edsammy/wipow/README.md

Wireless Power Monitoring Device
=====
University of Rochester   
Electrical Engineering Depatment   

Mentor: Professor Thomas B Jones   
Created by: Jack Yung & Ka Fung    
Maintained by: Will Kung & Eddie Samuels

-----------------------------------------------------------------------------------
Wireless Power Monitoring device that runs on the Arduino and uses the MAXQ3183. Capable of reading voltage, current, power, and voltage and current harmonics (1st-5th).
