edsammy/wipow/Presentations and Reports/7-10.pptx

| A | B | C | N | Total
RMS Voltage | ✓ | ✓ | ✓ | - | -
RMS Current | ✓ | ✓ | ✓ | ✓ | -
Power (Apparent/Real/Reactive) | ✓ | ✓ | ✓ | - | ✓
Line Frequency | ✓ | ✓ | ✓ | - | ✓
Power Factor (Real over Reactive) | ✓ | ✓ | ✓ | - | -
Voltage Phasor Angles | ✓ | ✓ | ✓ | - | -
Current Harmonics | Filter problem in the chip?
Voltage Harmonics
Current THD
Fundamental Powers

## Slide 2

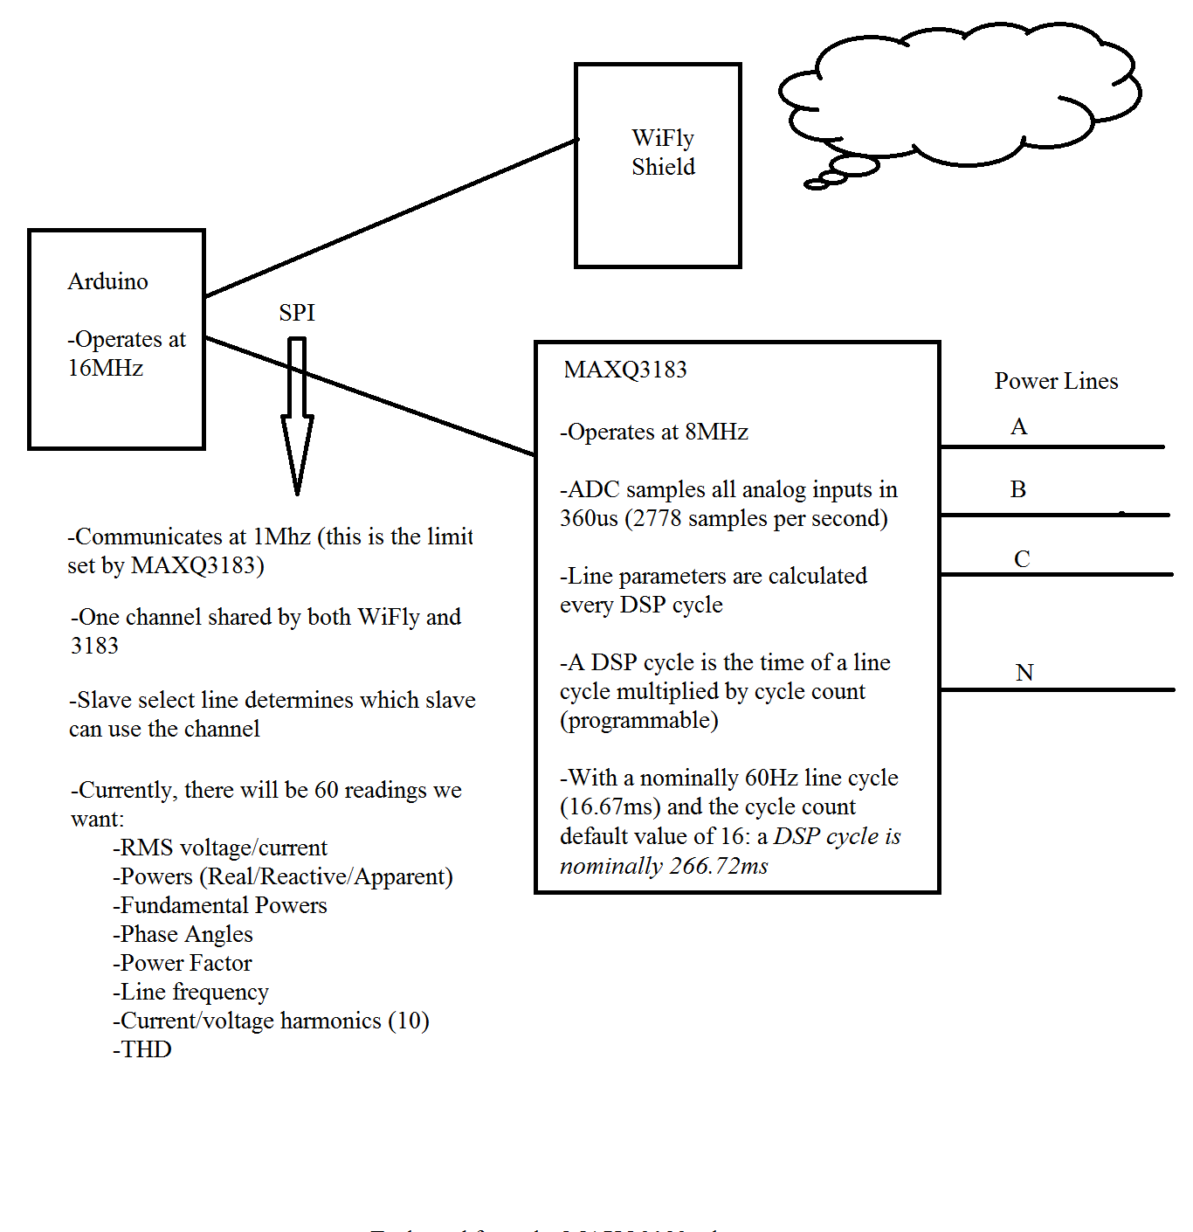
[picture p3: figure]
