edsammy/wipow/Presentations and Reports/9-11-12 Presentation.pptx

## Wireless Building Power Monitor

(Hardware Design and Packaging)
2012 Spring to Summer
Pak Lam (Jack) Yung

## Wireless Power Monitor System

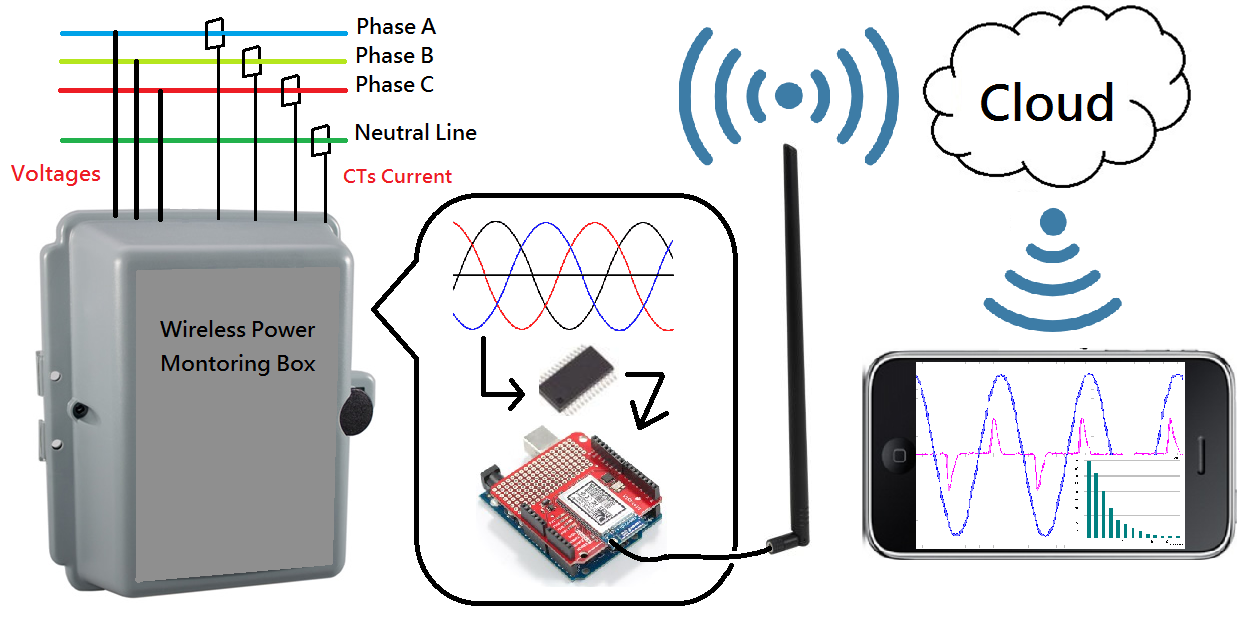
[picture p4: figure]

## Inside the Box

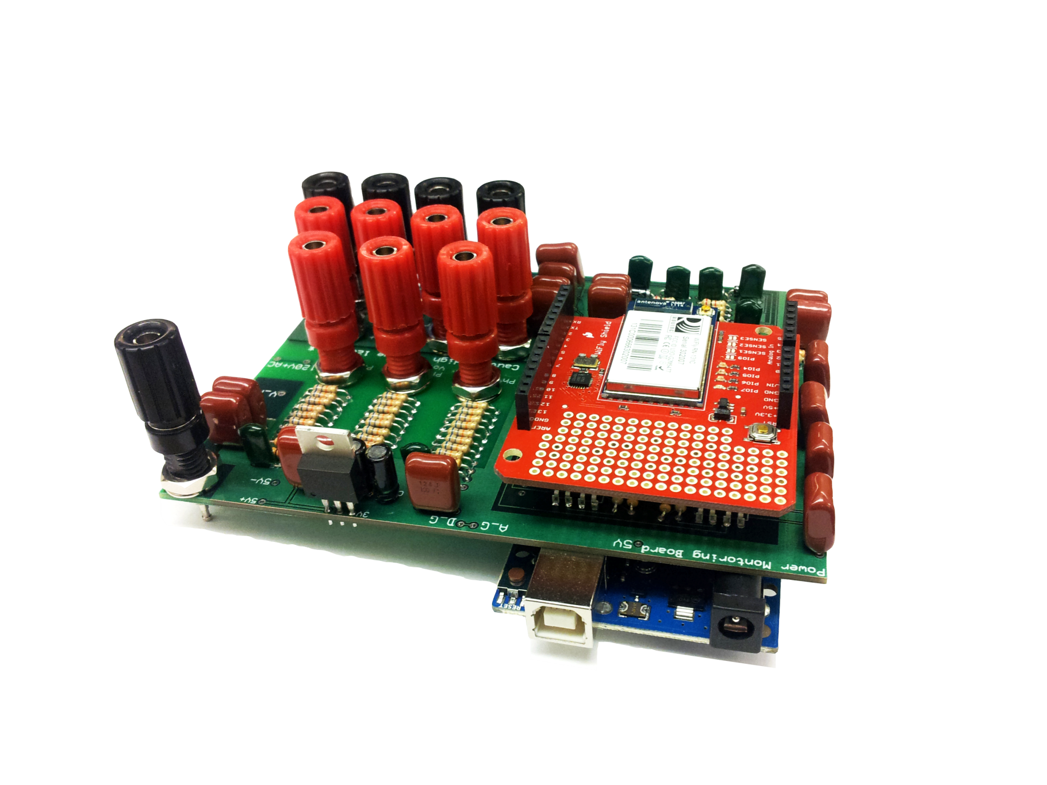
[picture p5: figure]

## Slide 4

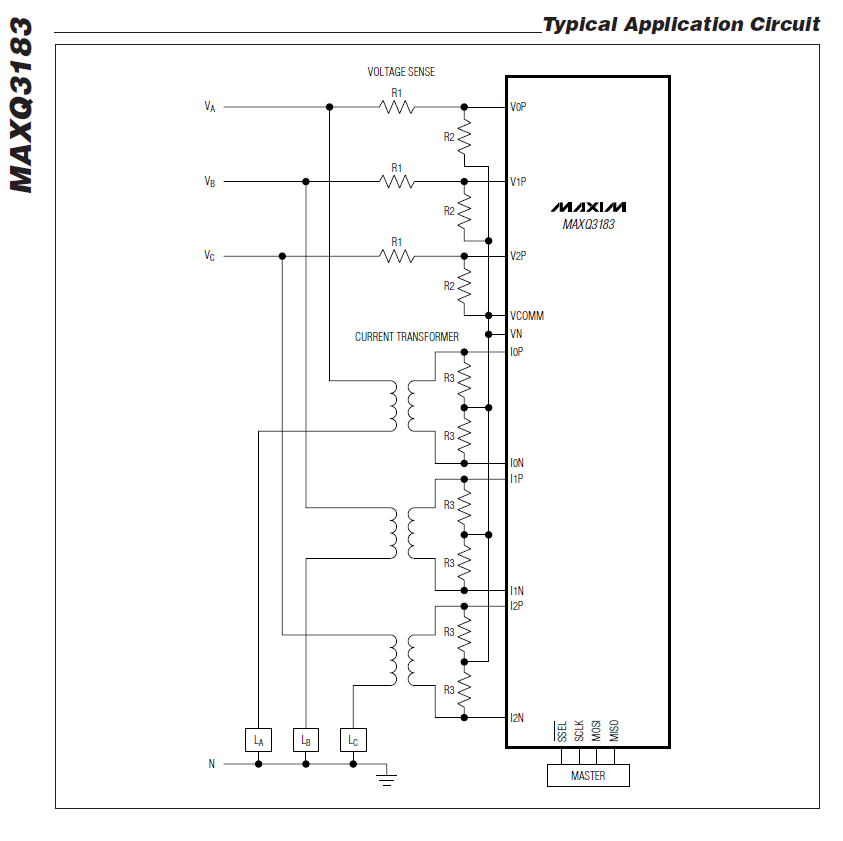
[picture p6: figure]

## Slide 5

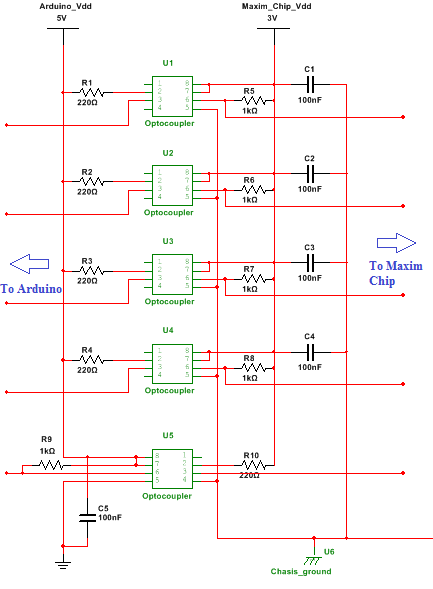
[picture p7: figure]

## Slide 6

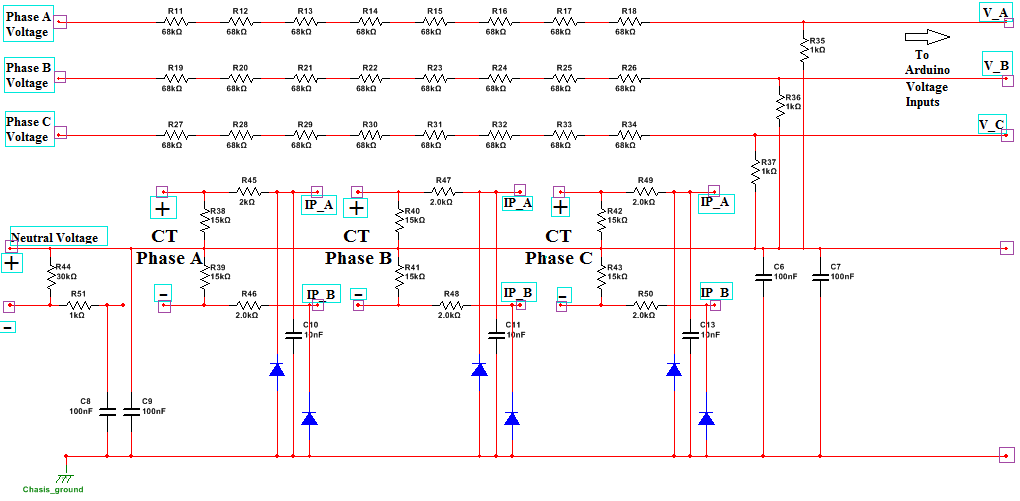
[picture p8: figure]

## Slide 7

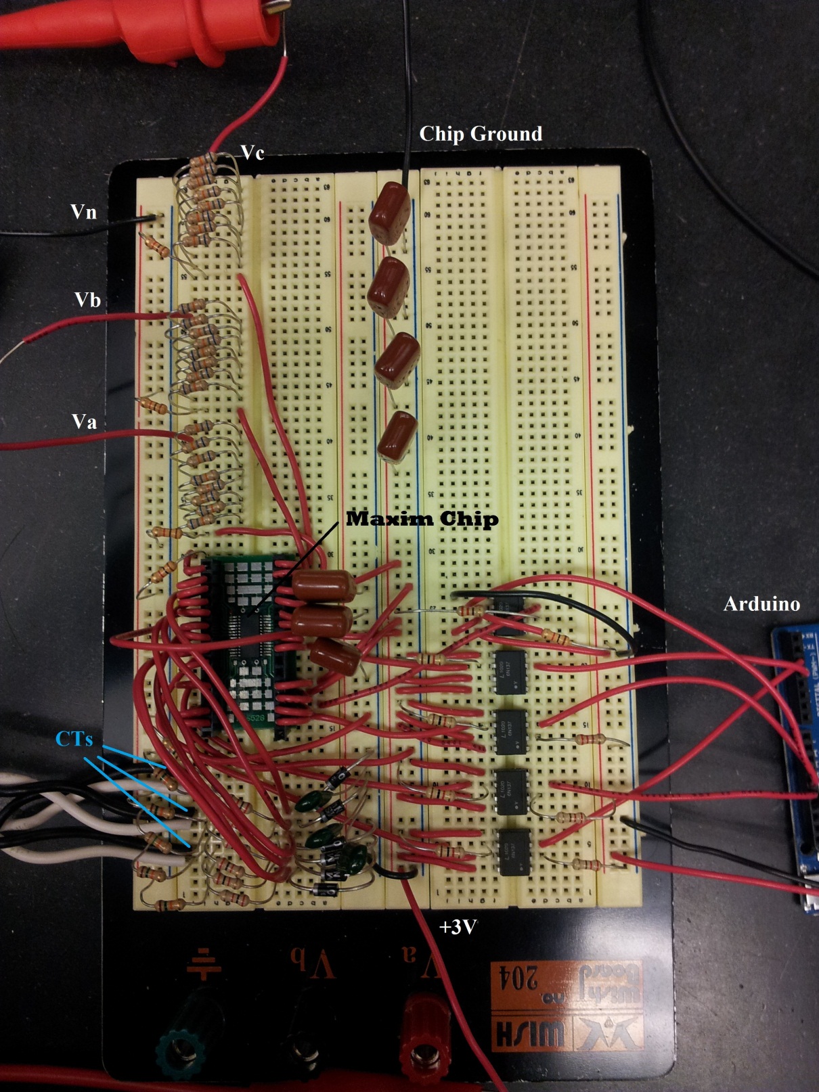
[picture p9: figure]

## Slide 8

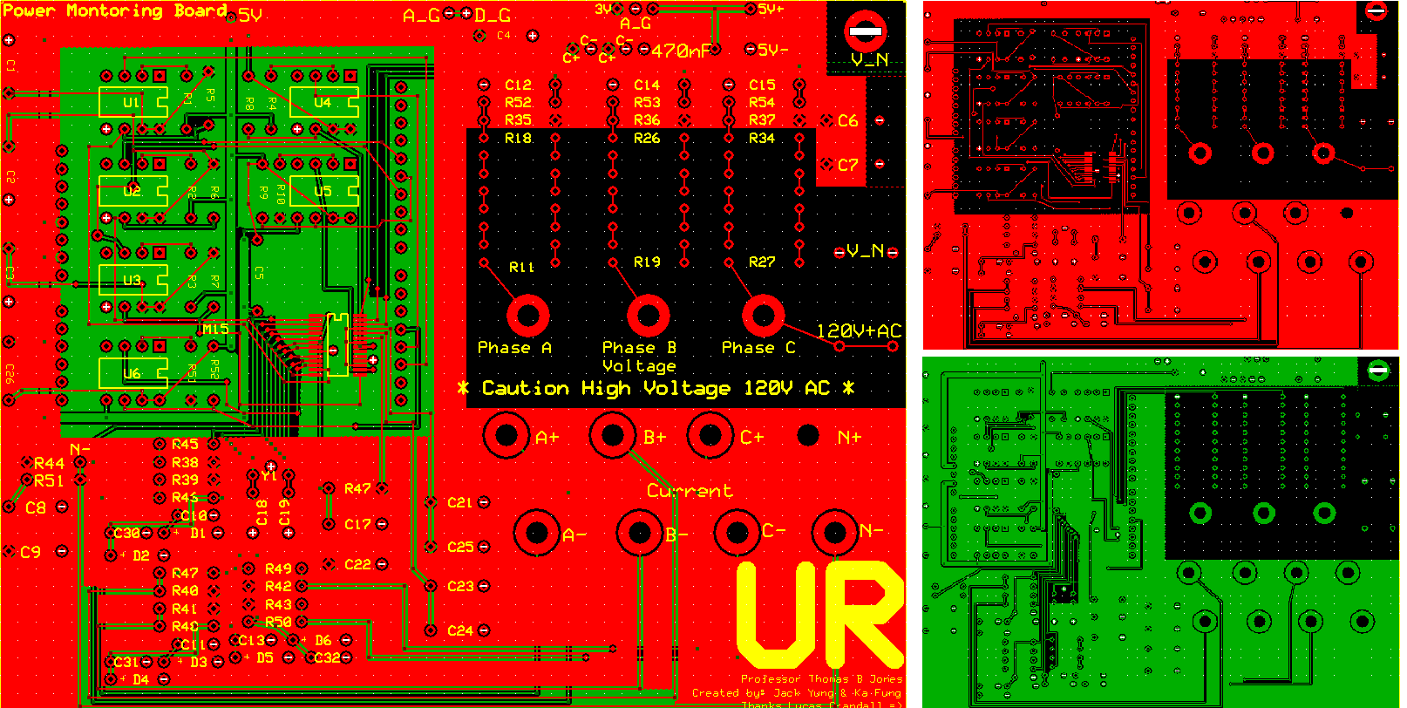
[picture p10: figure]
