edsammy/wipow/Presentations and Reports/Arduino intro plus AFEs.pptx

## Introduction to Arduino

By Gabriel Unger

## What is Arduino?

- Open-source physical computing platform
- Atmel AVR ATmega microcontrollers
- Free, simple IDE with built-in functions
- Arduino Programming Language (C/C++)

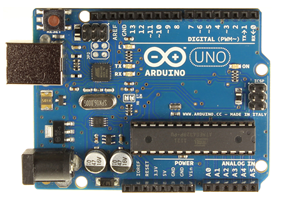
[picture p11: figure]

## What is Arduino Used For?

- Standalone systems
  - Robots
  - Pervasive computing (smart home)
- Interface between physical world and computing world
  - Our project
  - Transducers feed Arduino
  - Arduino feeds a system

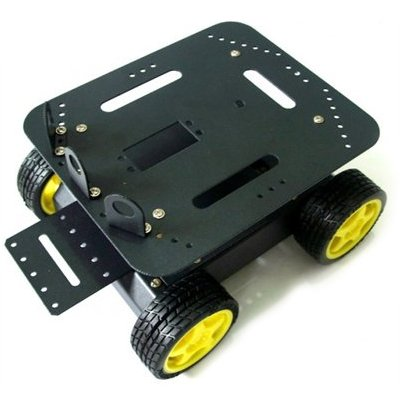
[picture p12: figure]

## Why Arduino?

- Easy
  - Pre-made official boards
  - C/C++
- Open
  - Third-party boards
  - “Shields” extend functionality
- Popular
  - Community-developed libraries
  - Online support community

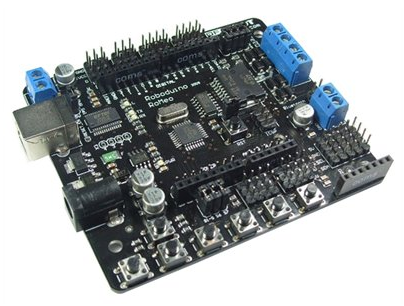
[picture p13: figure]
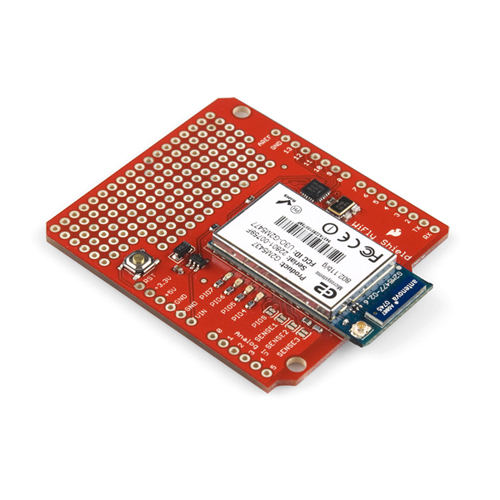
[picture p14: figure]

## What Can Arduino Do?

- Processing and Storage
  - Capable processor (robot brain)
  - SRAM, EEPROM, SD
- Connectivity
  - Basic digital, analog I/O
  - Serial
  - Bluetooth
  - WiFi
  - Zigbee
  - NFC/RFID
  - Ethernet

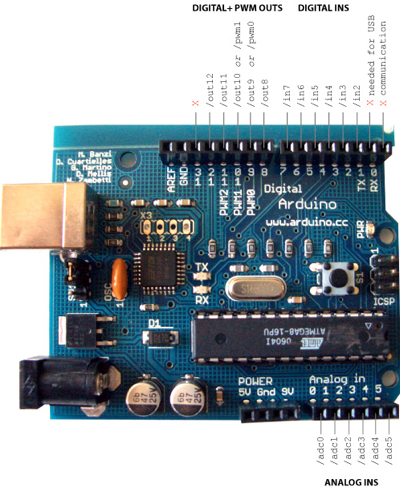
[picture p15: figure]

## Programming an Arduino Board

- Arduino IDE
  - Version 1.0
  - Free
  - C/C++
  - “Sketches”
    - One or more programs
    - .ino extension
    - setup() and loop()
- Any other IDE
  - Must support ATmega
  - Few advantages

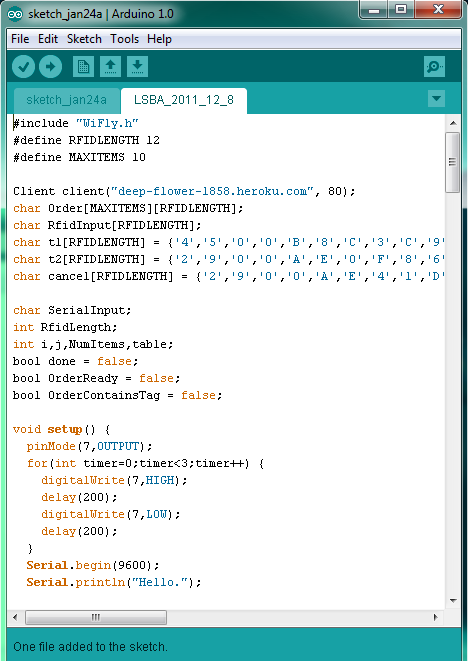
[picture p16: figure]

## Arduino Uno

- Latest official Arduino board
- ATmega328
  - 8-bit
  - 14 digital I/O (6 PWM)
  - 6 analog inputs
  - 16 MHz
  - 5V
  - 32 KB of program memory
  - 2 KB of SRAM (variables)
  - 1 KB EEPROM
  - Serial port
  - SPI port
  - 2 external interrupts
  - AREF

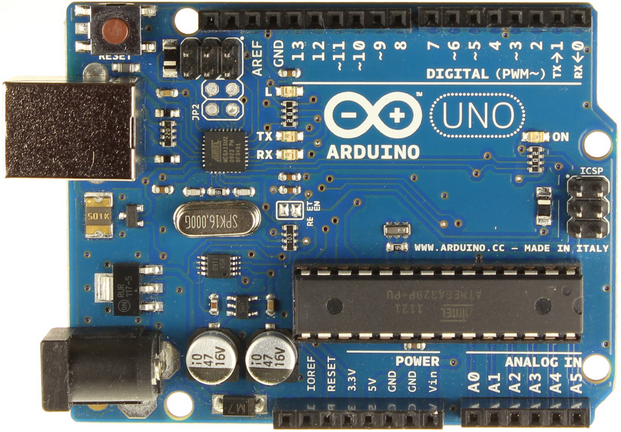
[picture p17: figure]

## How Arduino Fits Our Project

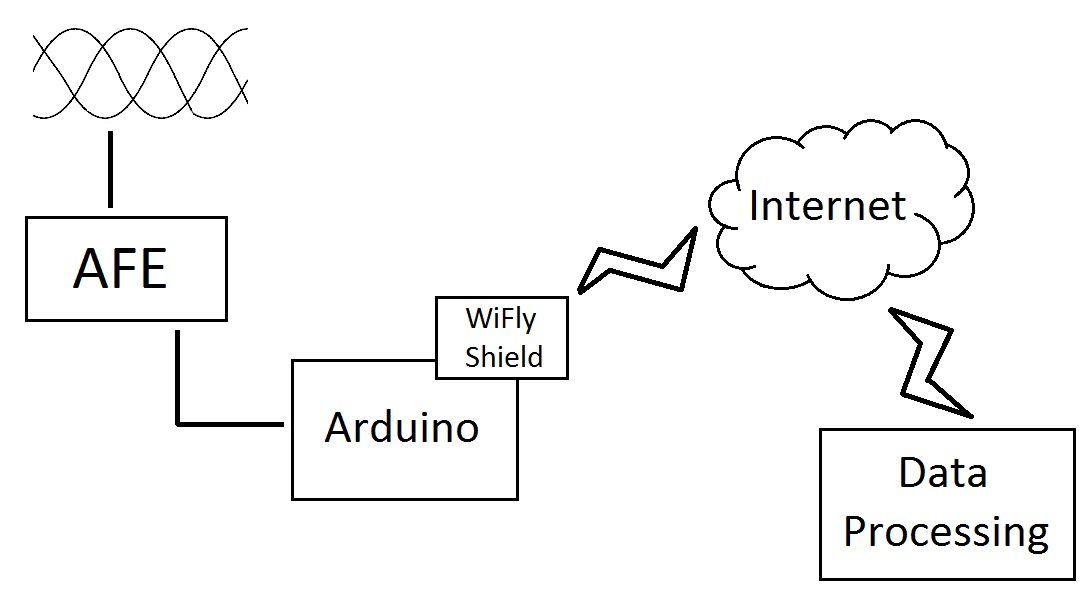
[picture p18: figure]

## Analog Front End (AFE)

- Grabs raw sensor outputs
  - Voltages
  - Currents
- Provides data to next level of processing
- Some provide advanced features
  - Fundamental frequency
  - Harmonic power
  - Power factor

## Maxim AFE Devices

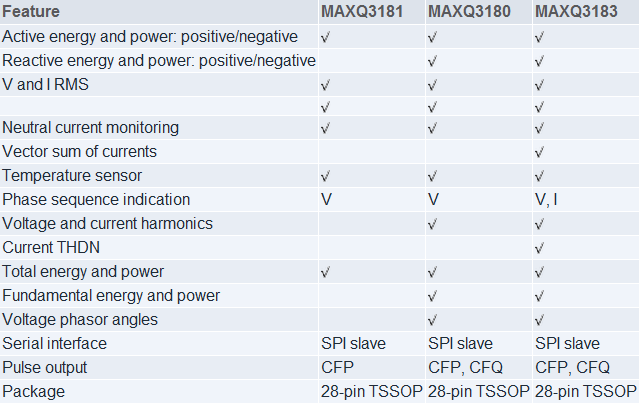
[picture p19: figure]

## MAXQ3183 Overview

- 3-Phase voltage, current
- ~$20 direct from Maxim
- TSSOP (tiny)
- SPI
- 3.3V
- 35 mW typical
- 7.6 MHz internal clock

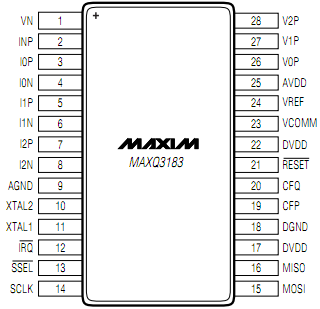
[picture p20: figure]

## MAXQ3183 Internals

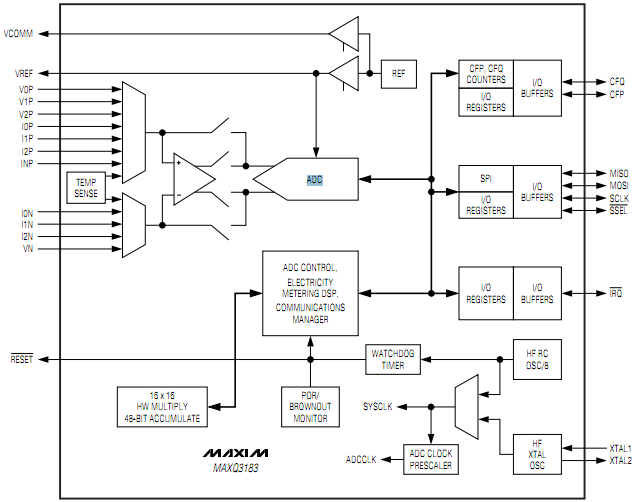
[picture p21: figure]
