edsammy/wipow/Presentations and Reports/Power Monitor - Hardware.pptx

## Power Monitor - Hardware

Pak Lam (Jack) Yung

## Power Monitoring System


## Hardware Design

- PCB Design (2x)
- Packaging
- Testing
- Installation

## One Year Ago

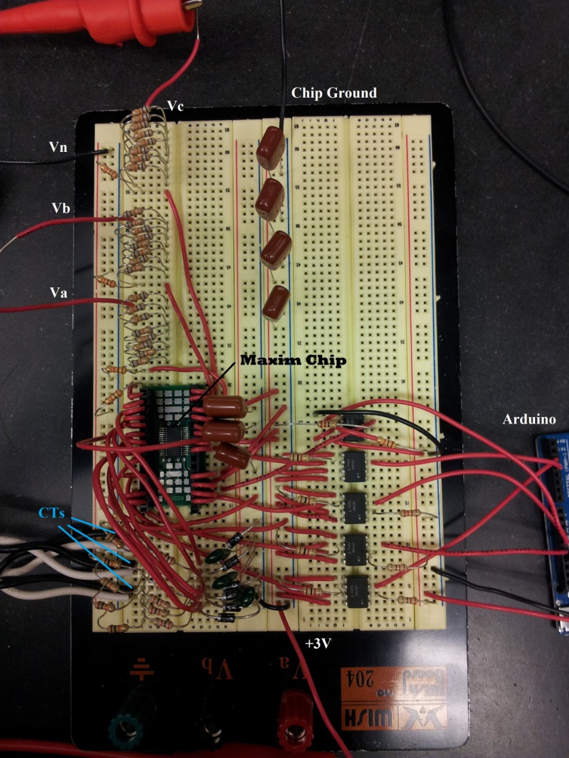
[picture p28: figure]

## Summer 2012

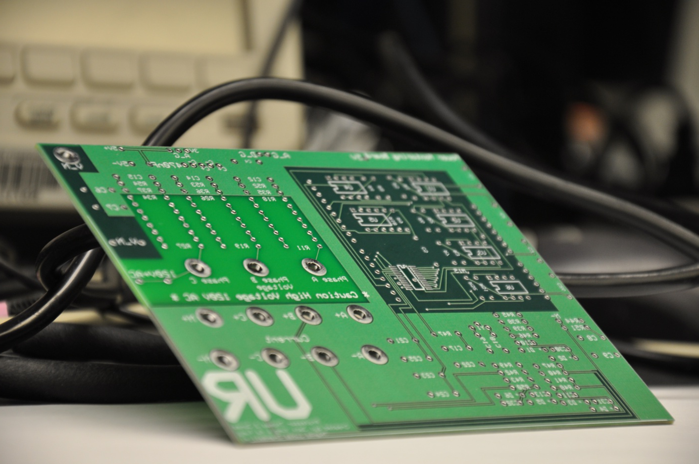
[picture p29: figure]

## Spring 2013

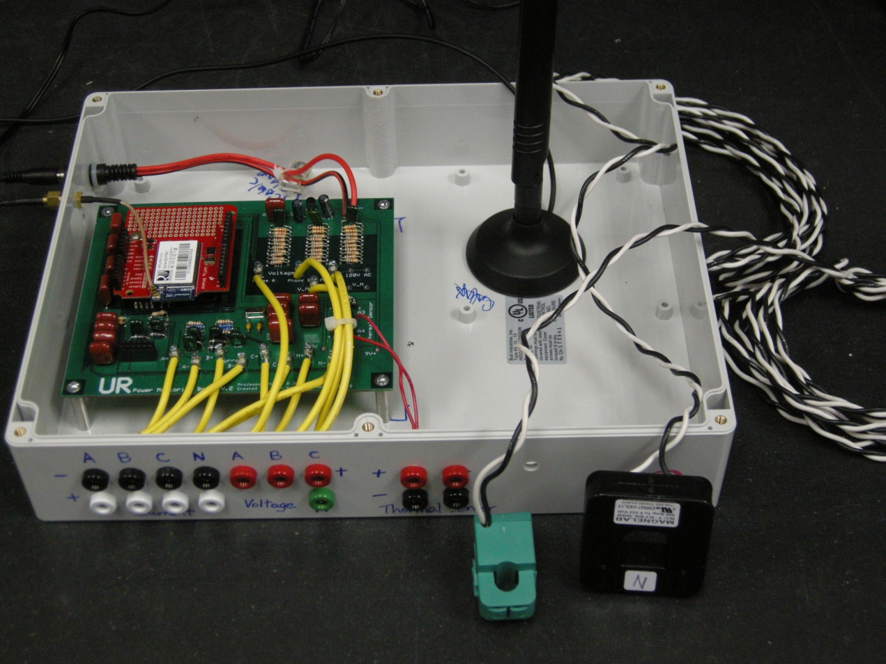
[picture p30: figure]

## First Circuit

- Noise
- Not safe
- Unstable
- Cheap

## First PCB

- Low Noise
- Safe
- 4 layer
- $219.9 – 4 piece
- $55 per piece
- Order from express PCB (Free Software)
- http://www.expresspcb.com/

## 4 layer PCB


## 4 Layer

- Top: N+
- 2nd: Digital Ground
- 3rd: Analog Ground
- Bottom: ~3V

## One Mistake for the first PCB

- R51 Right Hole
- should Not connect
- to top layer (N+)

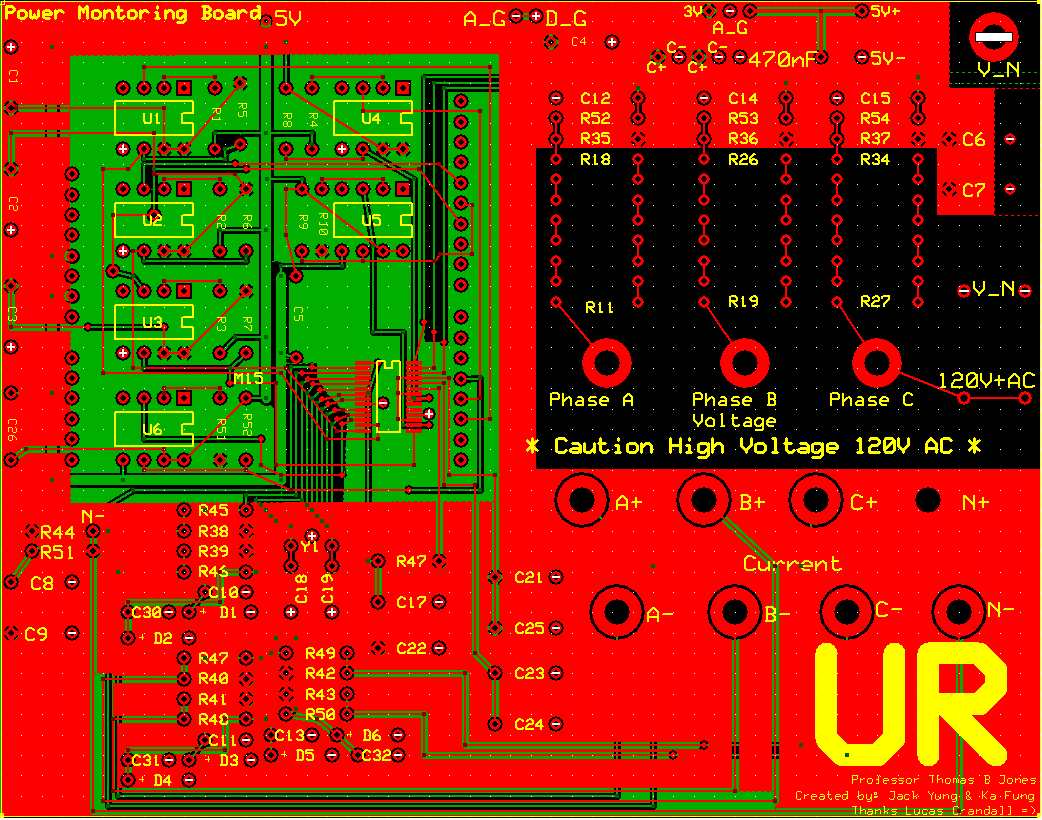
[picture p31: figure]
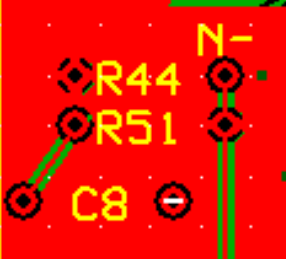
[picture p32: figure]

## Circuit


## Circuit


## Circuit

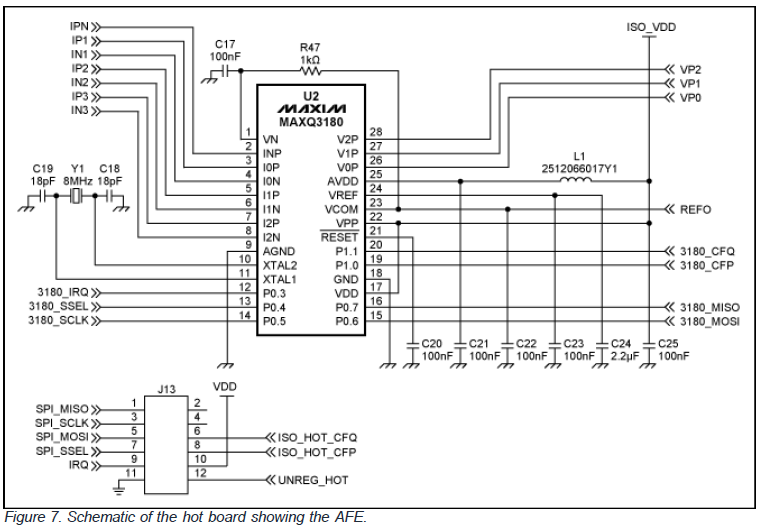
[picture p33: figure]

## Circuit


## Component

- Arduino Uno Board
- Wifly Shield
- CT
- Resistors, Capacitor
- Optopcoupler
- Maxim Chip
- Stackable Header
- Crystal Oscillator
- Voltage Regulator 5v to 3v
- Transformer AC to DC

## Where to Buy Them ?!

- http://www.sparkfun.com/products/10007
- https://shop.maximintegrated.com/storefront/priceavailable.do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
- http://www.digikey.com/product-detail/en/6N137/160-1791-ND/1969175
- http://www.digikey.com/product-detail/en/EPS090066-P5P/T980-P5P-ND/1016856
- http://www.digikey.com/product-detail/en/LP2950-33LPRE3/296-31455-1-ND/3505910
- http://www.newegg.com/Product/Product.aspx?Item=N82E16833998117
- https://www.sparkfun.com/products/9954

## PCB 2

- Same components
- BUT used Arduino Mage and added Thermal Sensor
- Bigger size
- Still 4 layer, circuit design is about the same.
- 6 piece for $430.99
- Each board is 72
- Express PCB

## Circuit Power

- 120 AC to 9v and 5v DC
- 9v Goes to Anduino, 5v goes to regulator and change to 3v.
- 3V power the chip and Optopcoupler

## Circuit Power

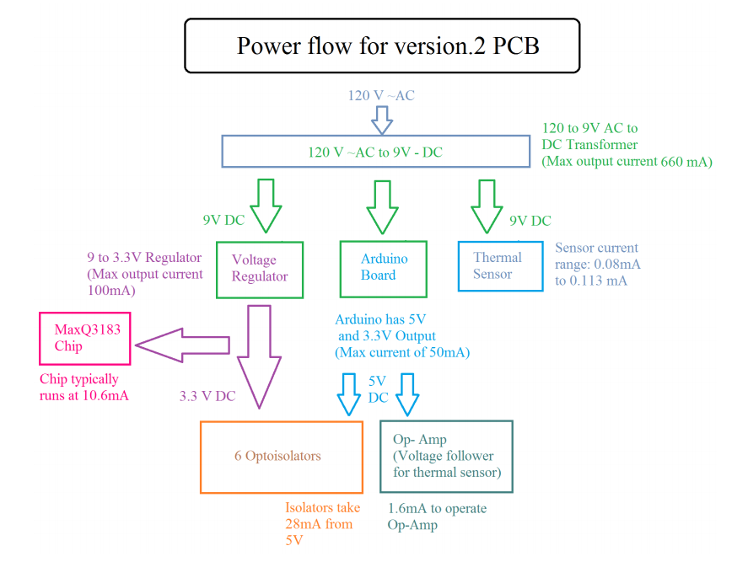
[picture p34: figure]

## Packaging

- Size measurement, purchase, installation

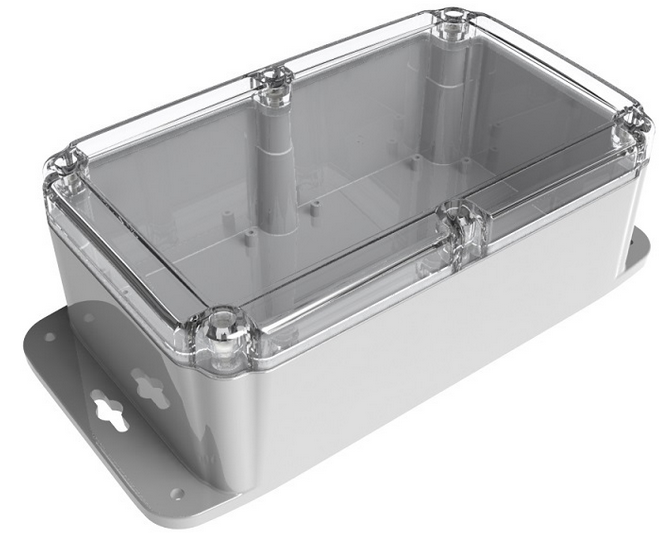
[picture p35: figure]

## Box 1 – Hopeman Building

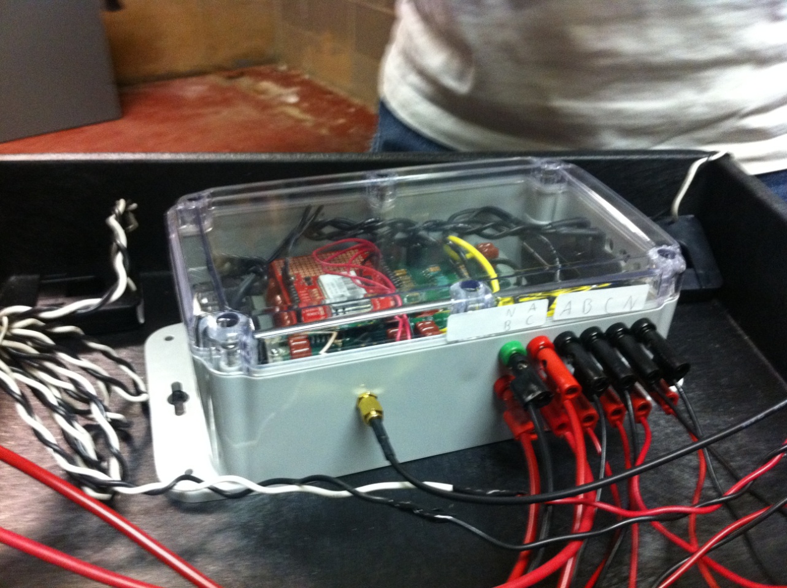
[picture p36: figure]

## Box 2

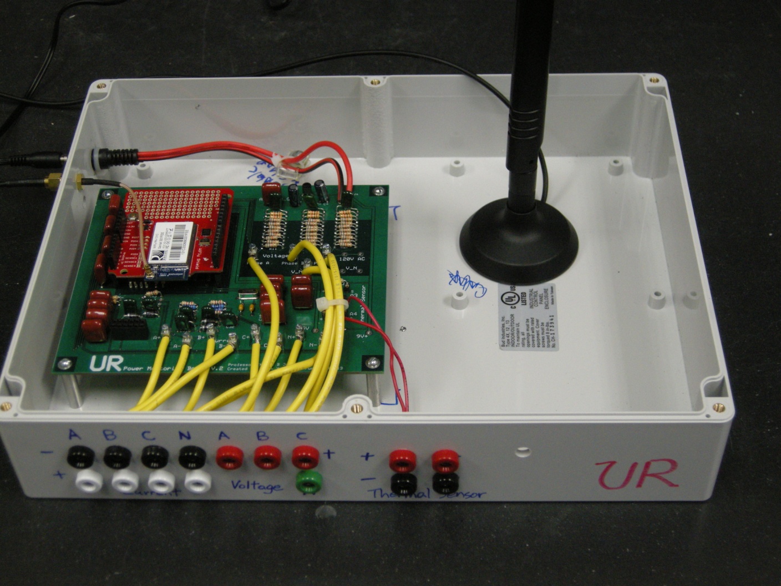
[picture p37: figure]

## Testing

- After building and soldering the board, run the sample code, get same reading. Let it run in the lab for few days and make sure it is safe to use (High voltage !!!)

## Installation

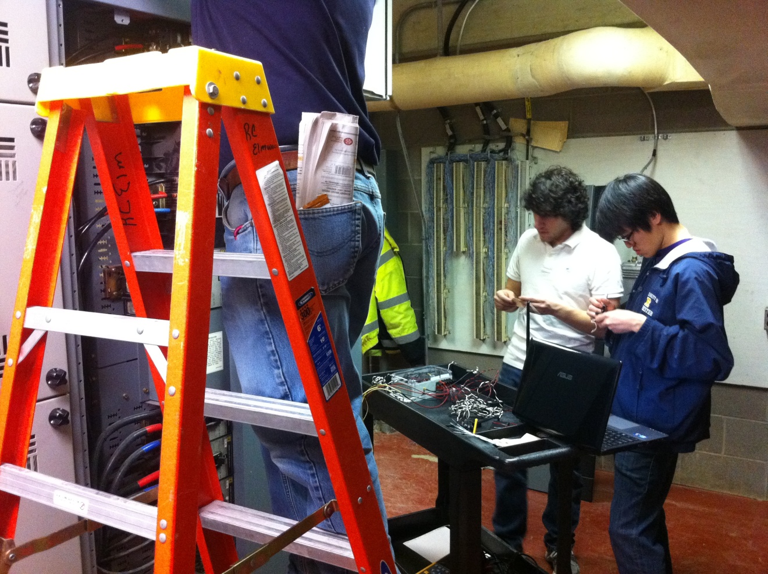
[picture p38: figure]

## Installation

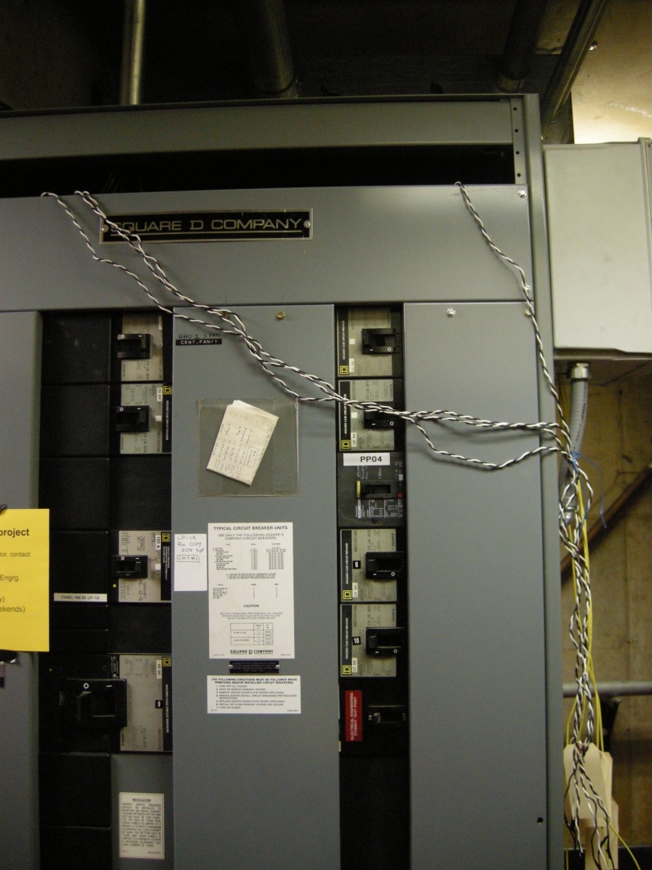
[picture p39: figure]

## Installation

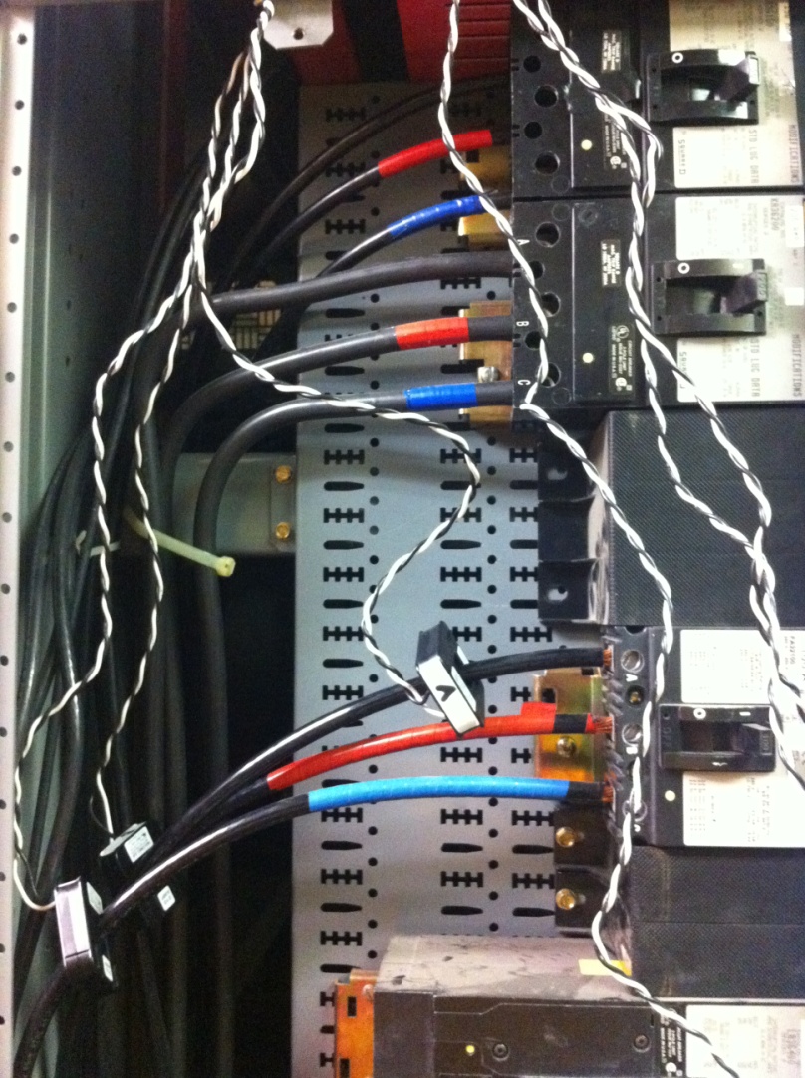
[picture p40: figure]

## Inventory

- Arduino Uno Board X3
- Arduino Mage x1
- PCB V1 x2
- PCB v2 x5 (un soldered)
- Wifly Shield X2
- CT x 9
- Resistors, Capacitor (Workshop)
- Optopcoupler x24
- Maxim Chip x5
- Stackable Header x6 sets
- Crystal Oscillator x4
- Voltage Regulator x5
- Transformer AC to 9 DC x3
- Box x2 (1 big and 1 small)
- Antenna x2
- Laptop x1
