edsammy/wipow/Presentations and Reports/Progress Report_PCB and Packing.pptx

## Process Report – PCB and Packing

Jack Yung
11-27-2012

## PCB Update:

- Adding internal connections to match the extra pins for Arduino Mega
- Expanding the circuit board:
- Make space for installation.
- Make space for thermal sensor.
- Adding voltage regulator to replace voltage transformer.
- $220 4-boards

## Voltage Regulator I

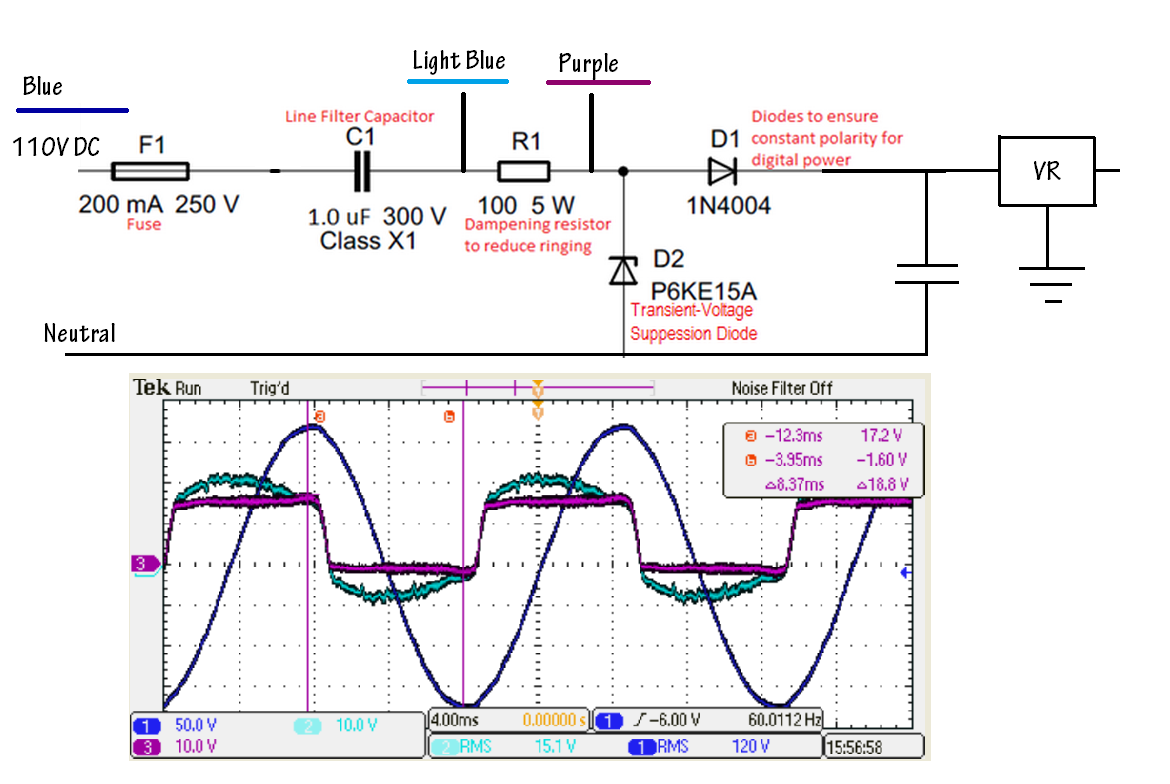
[picture p45: figure]

## Voltage Regulator II

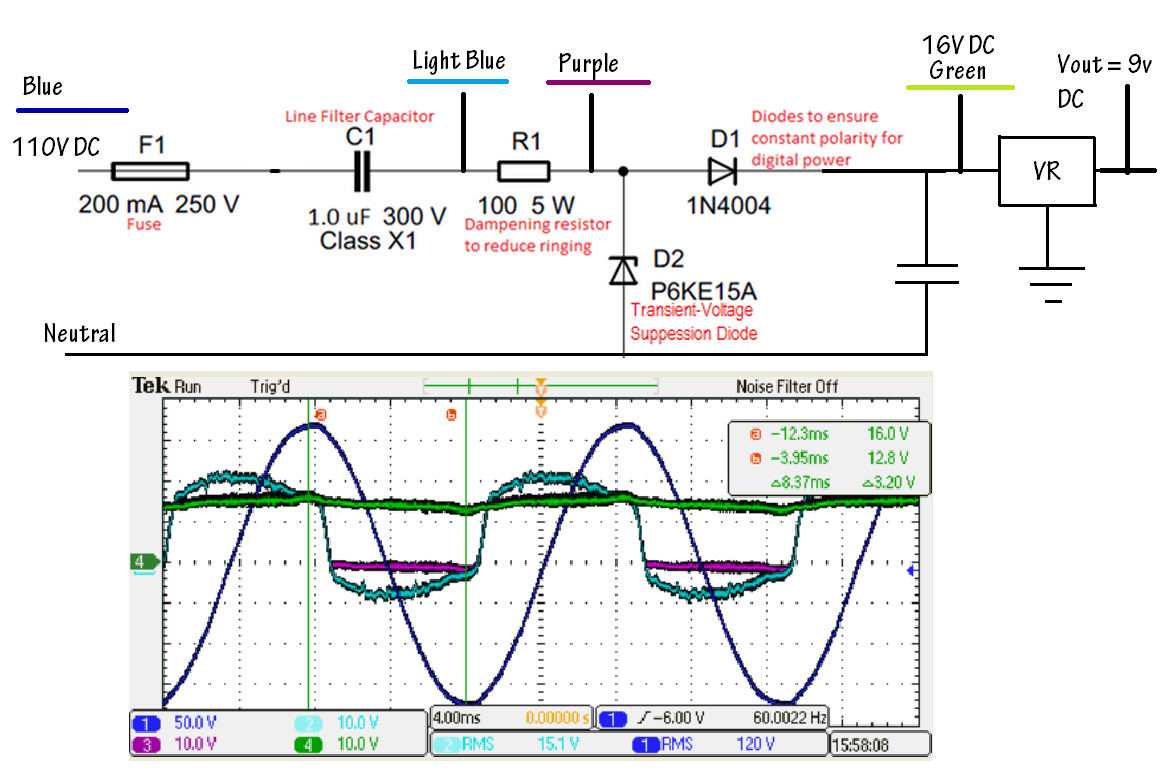
[picture p46: figure]

## Voltage Regulator

- Safety Testing (Connection with resistive load)
- ~20 hours total

## Packing Update

- Paul: No more packing box in the lab
- Buy new packing box when new PCB design finished.
- Plastic Vs. Metal

## Sample

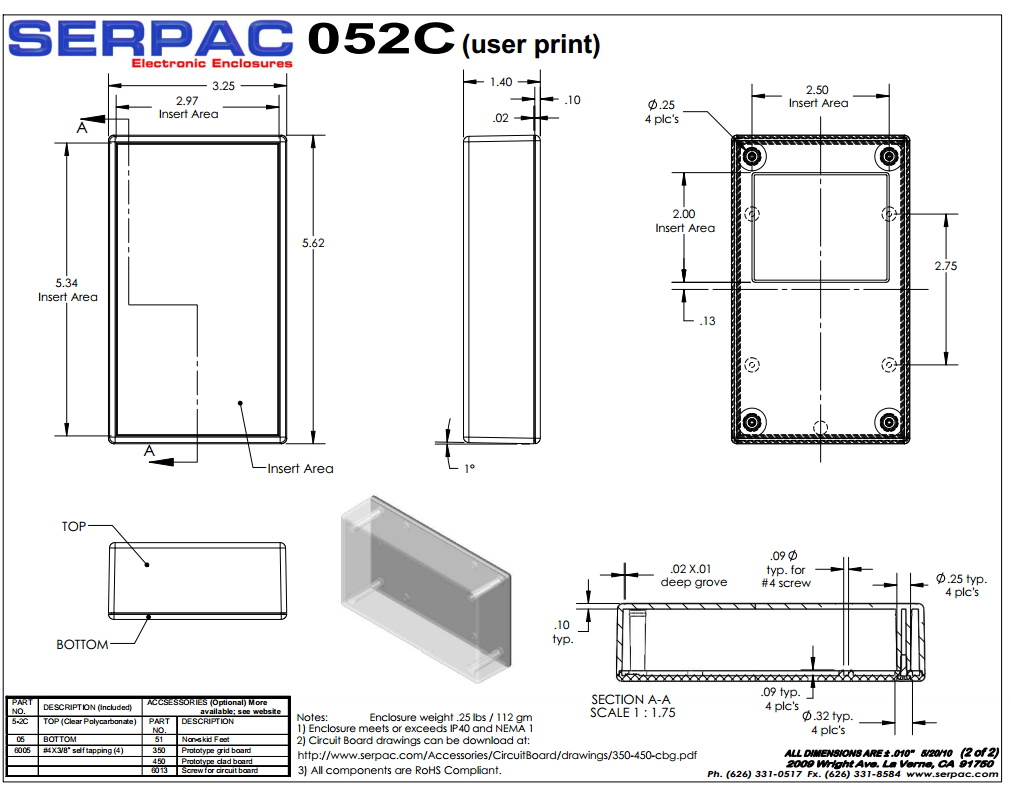
[picture p47: figure]

## Slide 8

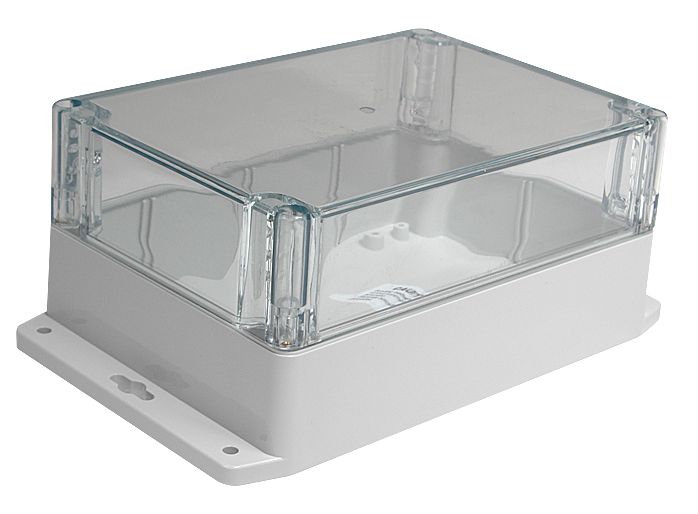
[picture p48: figure]
