edsammy/wipow/Measurement Device/MAXQ3182 Reference Design from Maxim/4663Fig54.gif

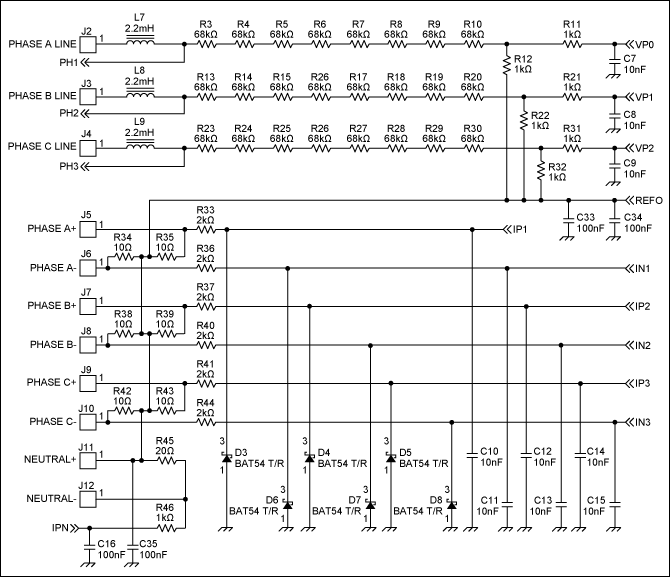
Measurement Device/MAXQ3182 Reference Design from Maxim/4663Fig54.gif
