edsammy/wipow/Measurement Device/MAXQ3182 Reference Design from Maxim/Chip.png

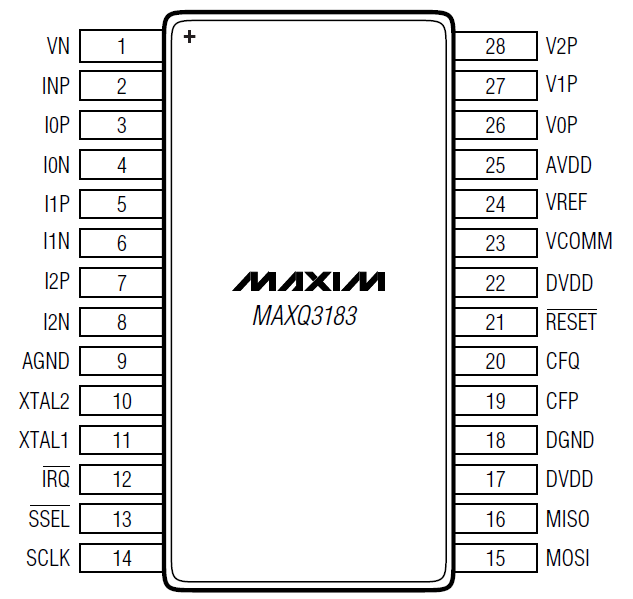
Measurement Device/MAXQ3182 Reference Design from Maxim/Chip.png
