edsammy/wipow/Pictures/20120620_092530.jpg

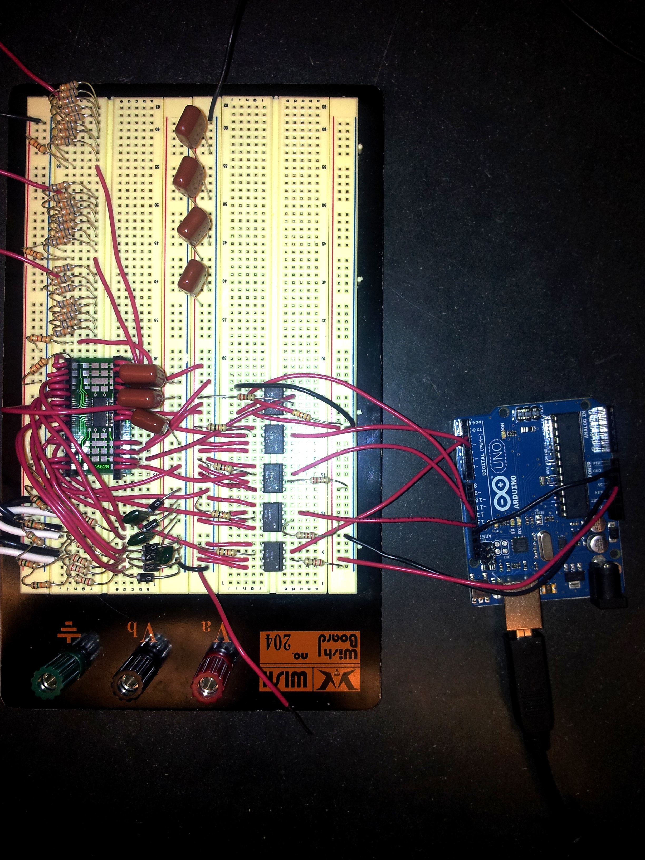
Pictures/20120620_092530.jpg
