edsammy/wipow/Pictures/20120724_105830.jpg

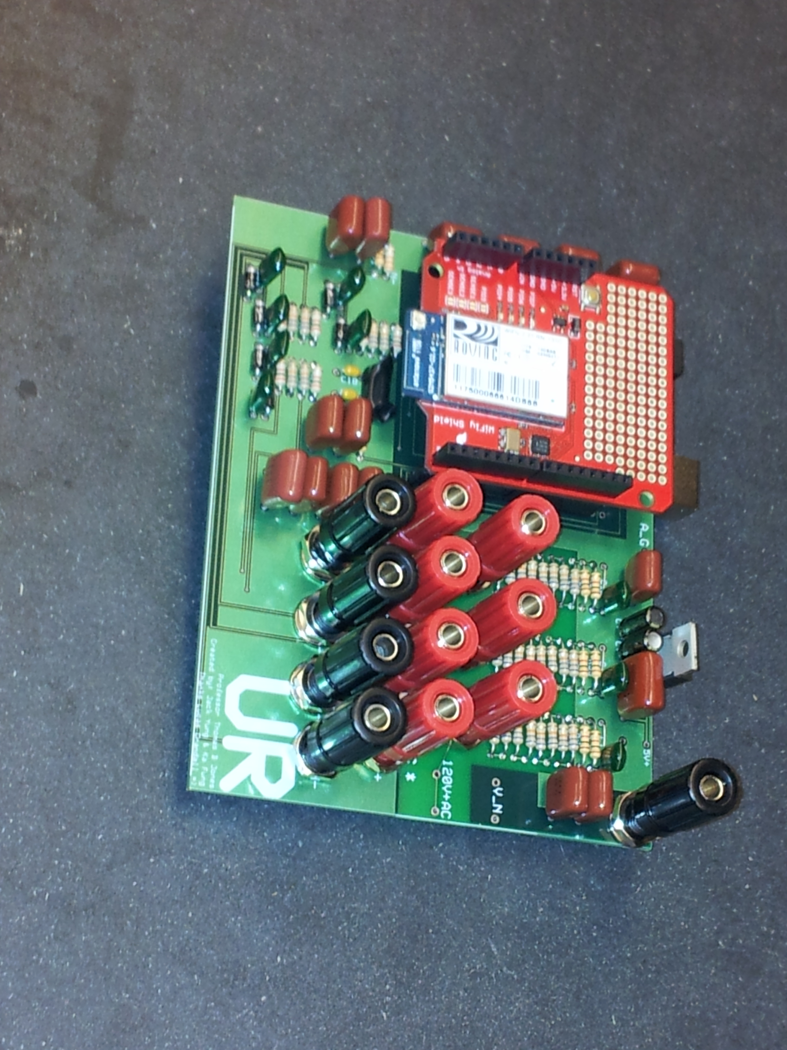
Pictures/20120724_105830.jpg
