edsammy/wipow/Pictures/20120724_105836.jpg

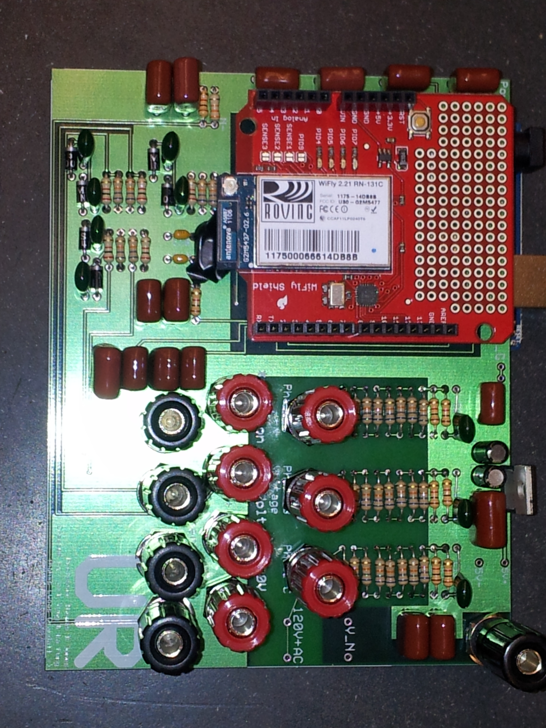
Pictures/20120724_105836.jpg
