edsammy/wipow/Pictures/20120724_105849.jpg

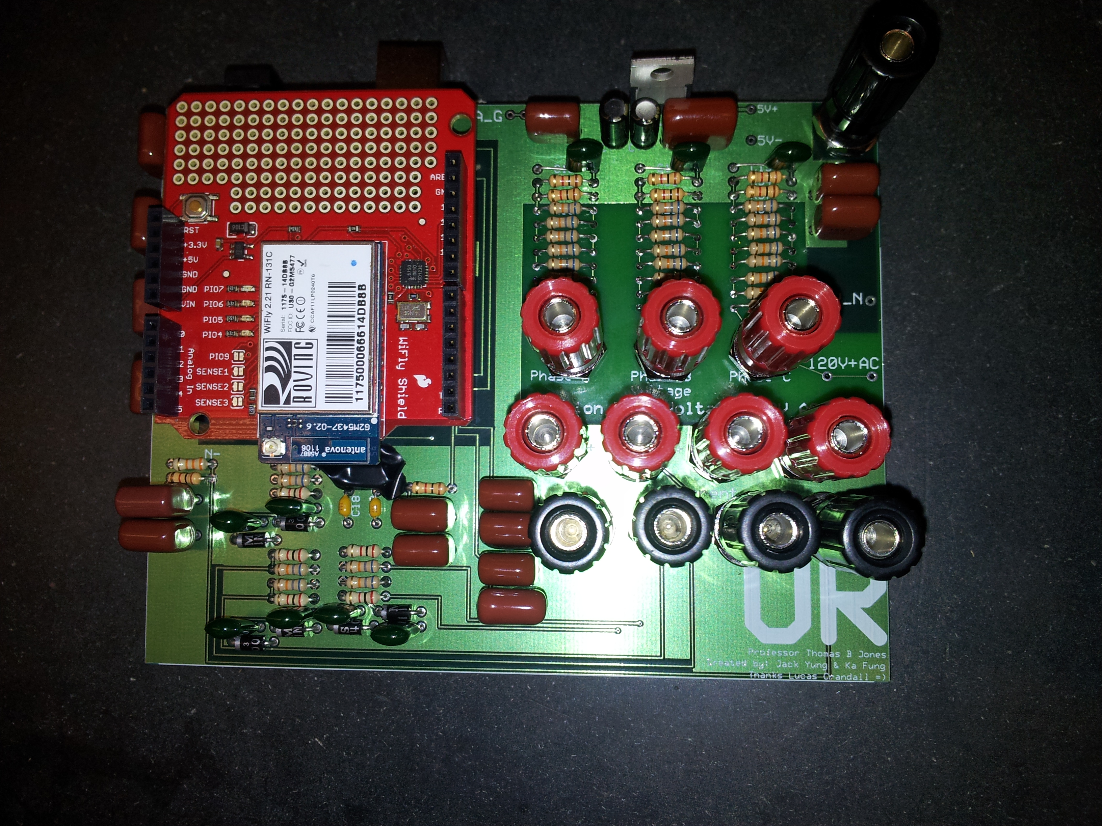
Pictures/20120724_105849.jpg
