edsammy/wipow/Pictures/20120724_143413.jpg

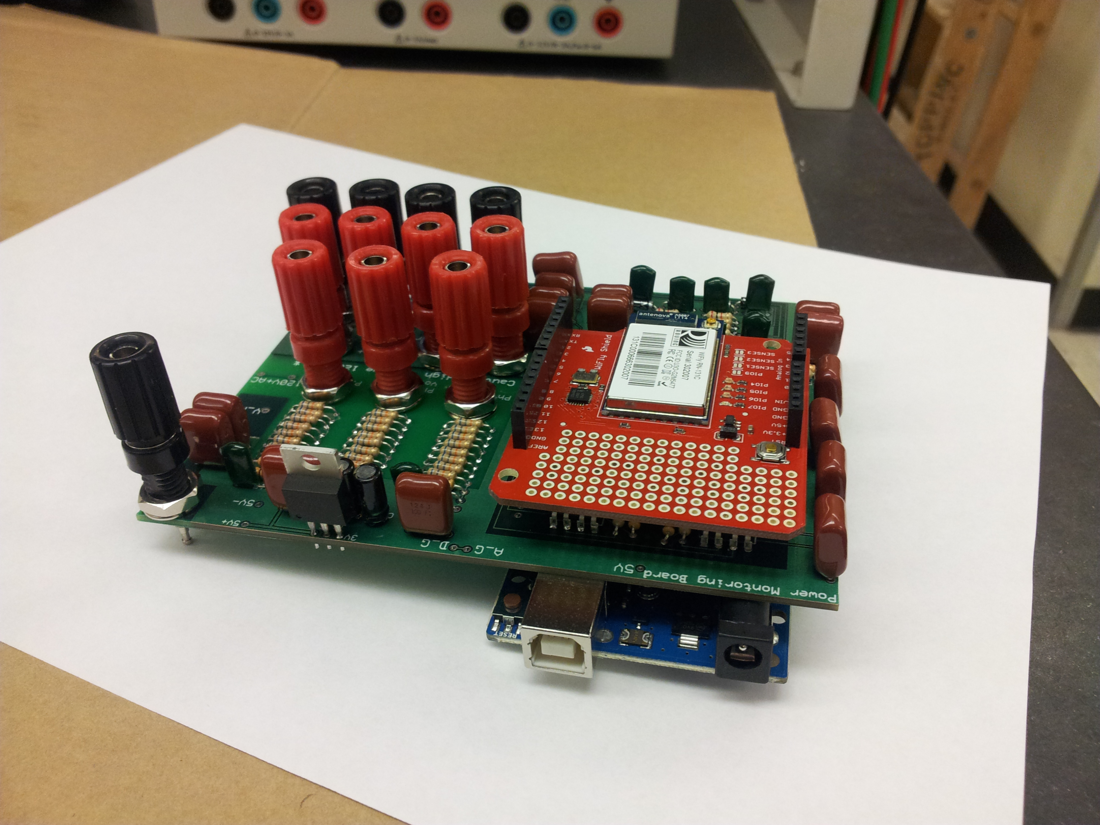
Pictures/20120724_143413.jpg
