edsammy/wipow/Pictures/DSCN5337.JPG

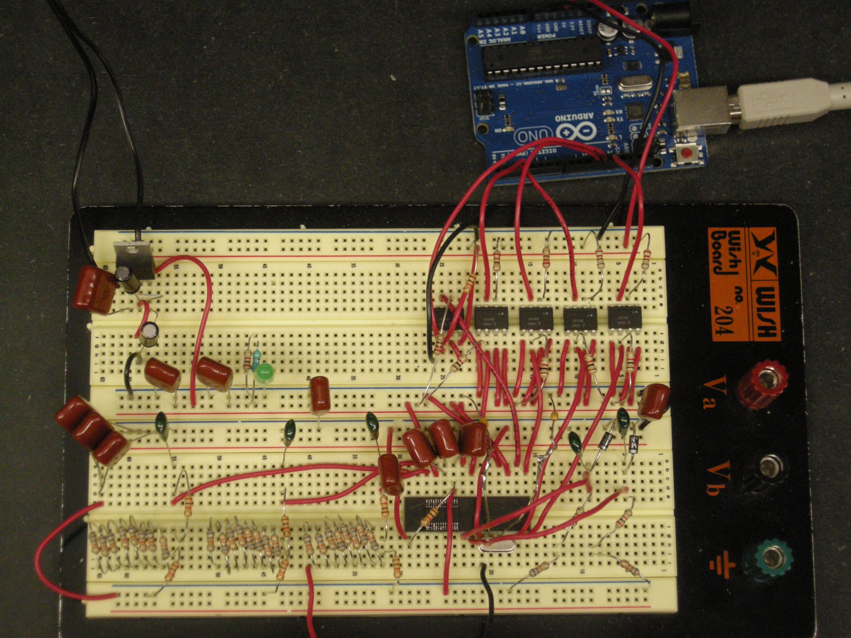
Pictures/DSCN5337.JPG
