edsammy/wipow/Pictures/DSCN5338.JPG

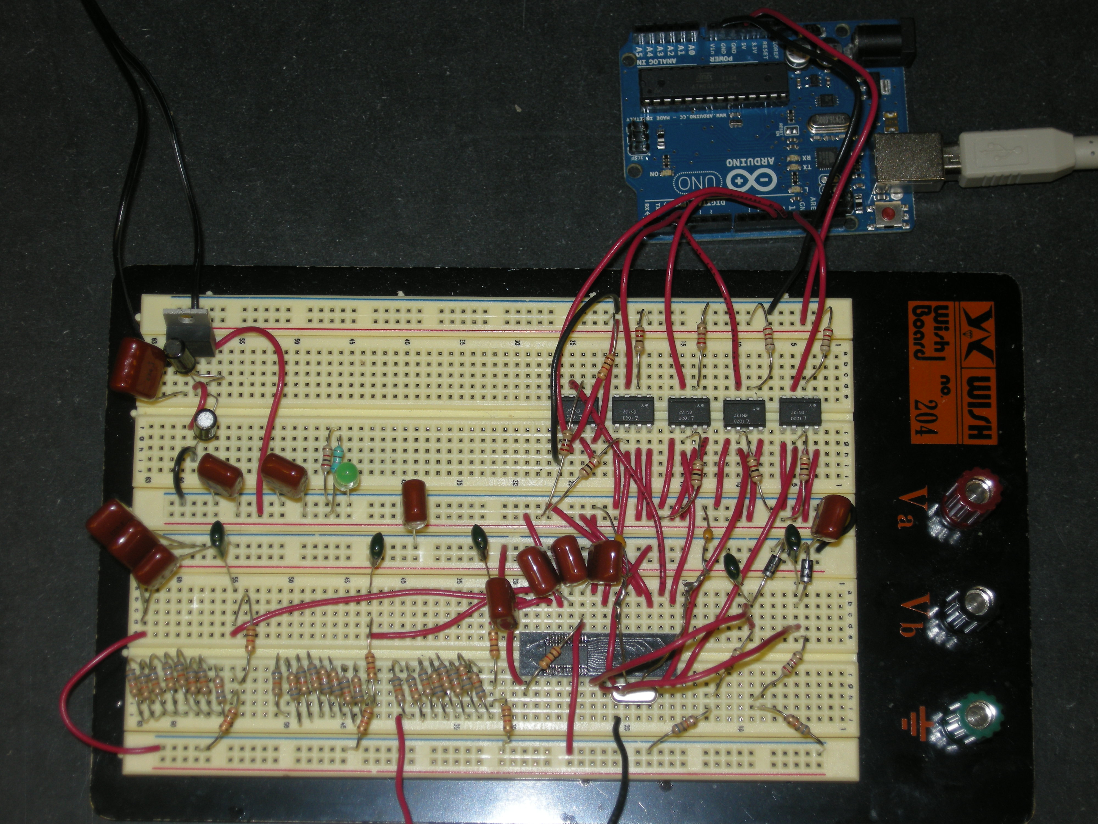
Pictures/DSCN5338.JPG
