edsammy/wipow/Pictures/DSCN5339.JPG

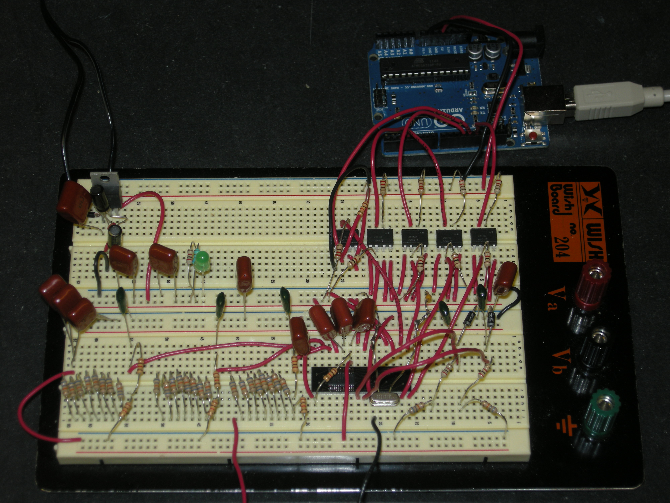
Pictures/DSCN5339.JPG
