edsammy/wipow/Pictures/DSCN5345.JPG

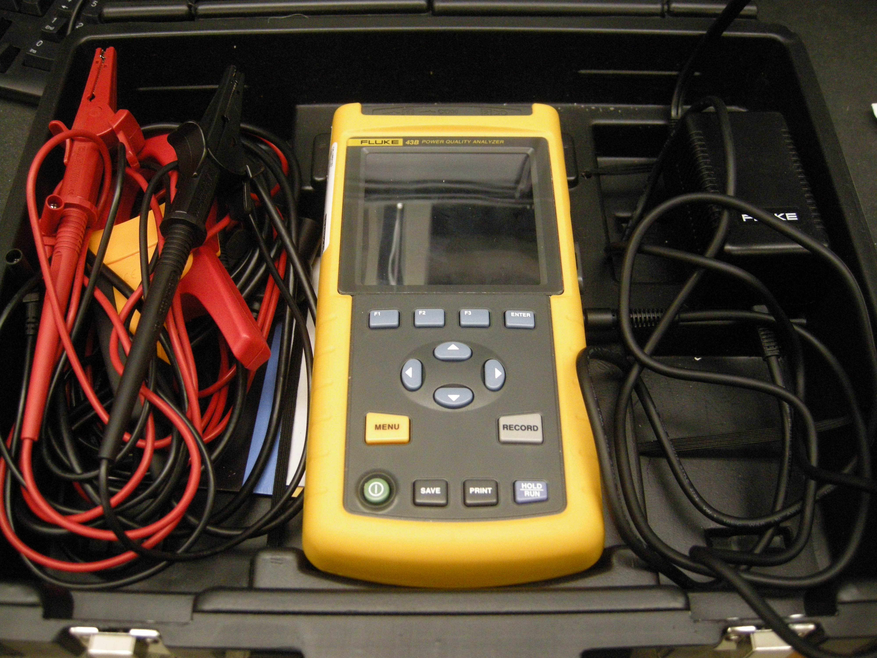
Pictures/DSCN5345.JPG
