edsammy/wipow/Pictures/DSCN5346.JPG

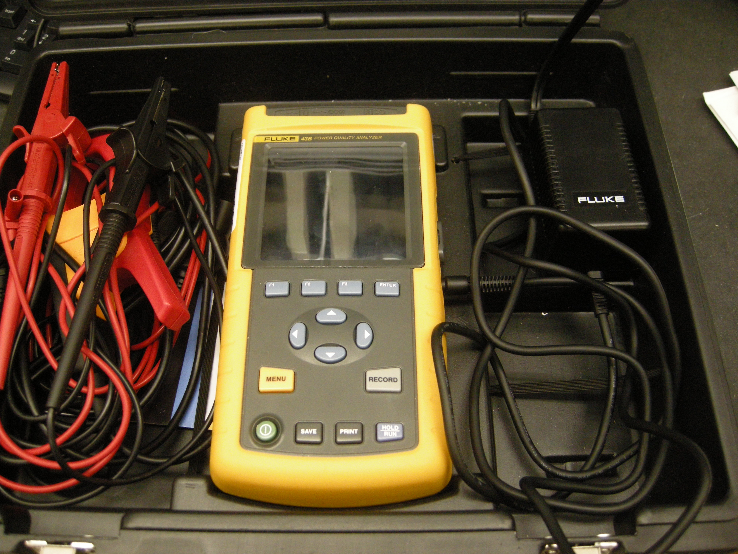
Pictures/DSCN5346.JPG
