edsammy/wipow/Pictures/DSCN5347.JPG

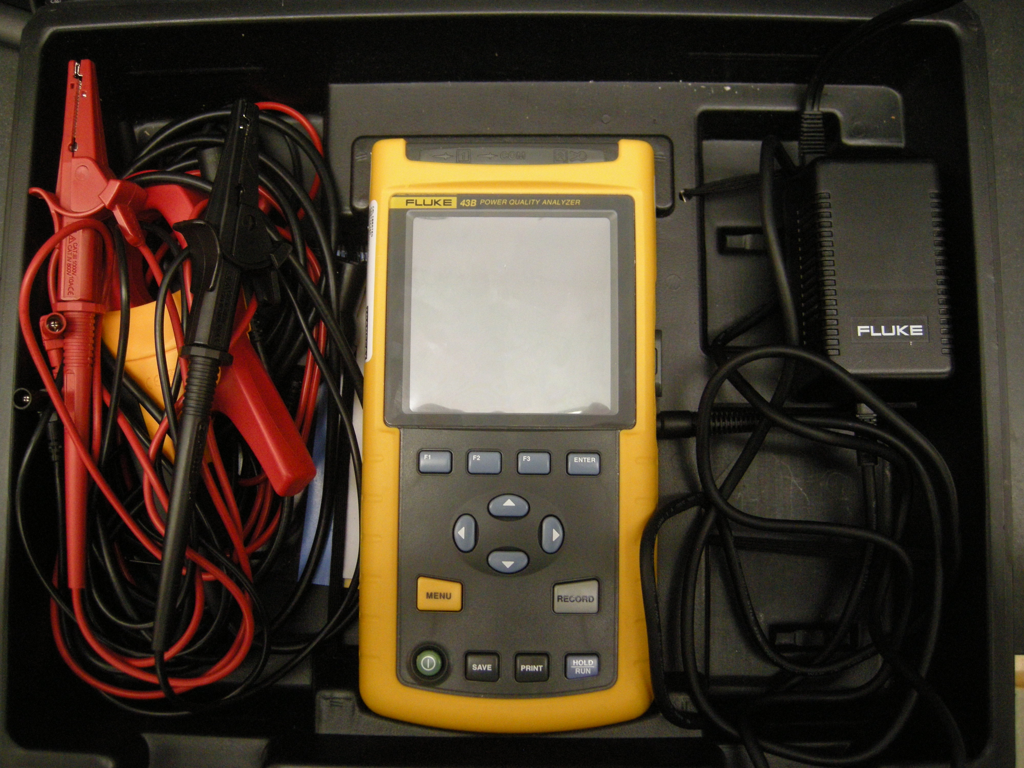
Pictures/DSCN5347.JPG
