edsammy/wipow/Pictures/DSCN5348.JPG

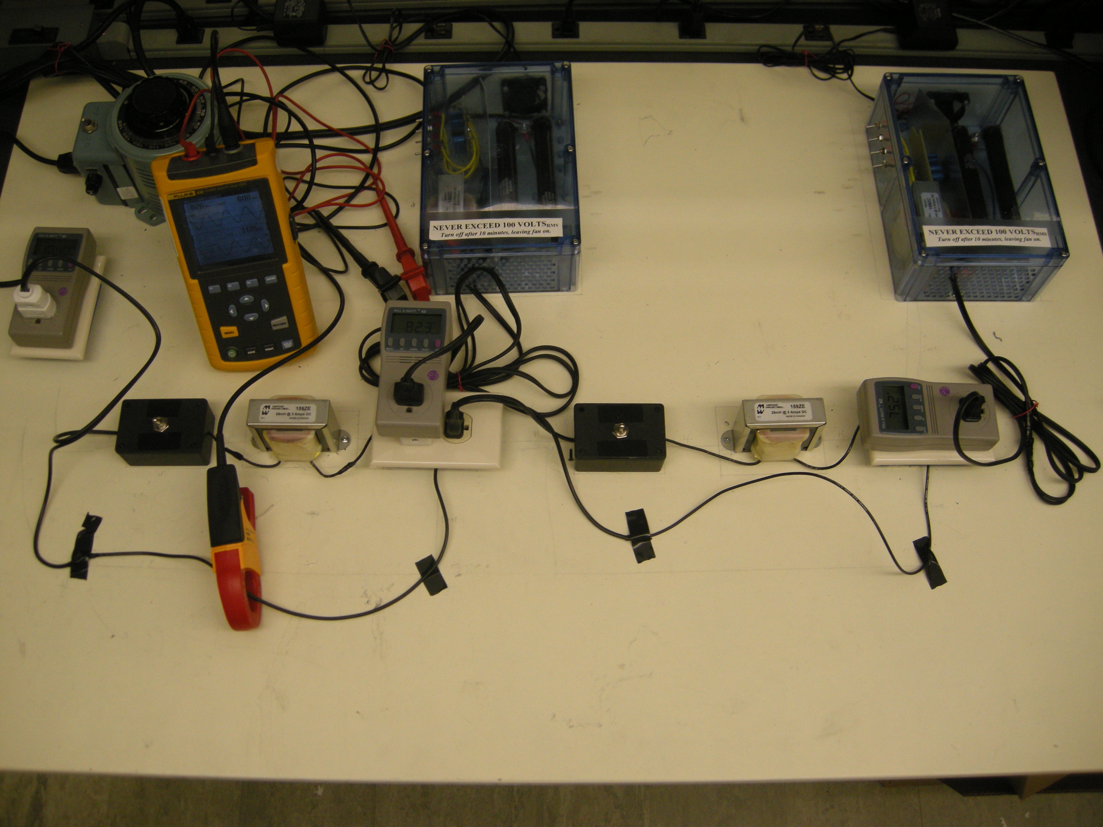
Pictures/DSCN5348.JPG
