edsammy/wipow/Pictures/DSCN5349.JPG

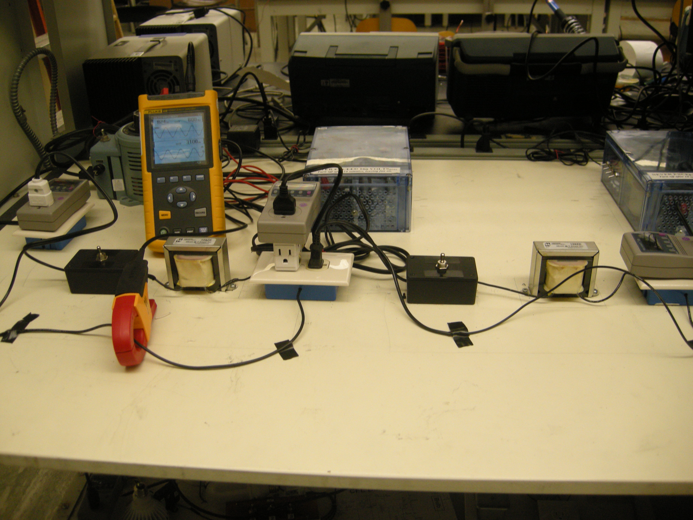
Pictures/DSCN5349.JPG
