edsammy/wipow/Pictures/DSCN5350.JPG

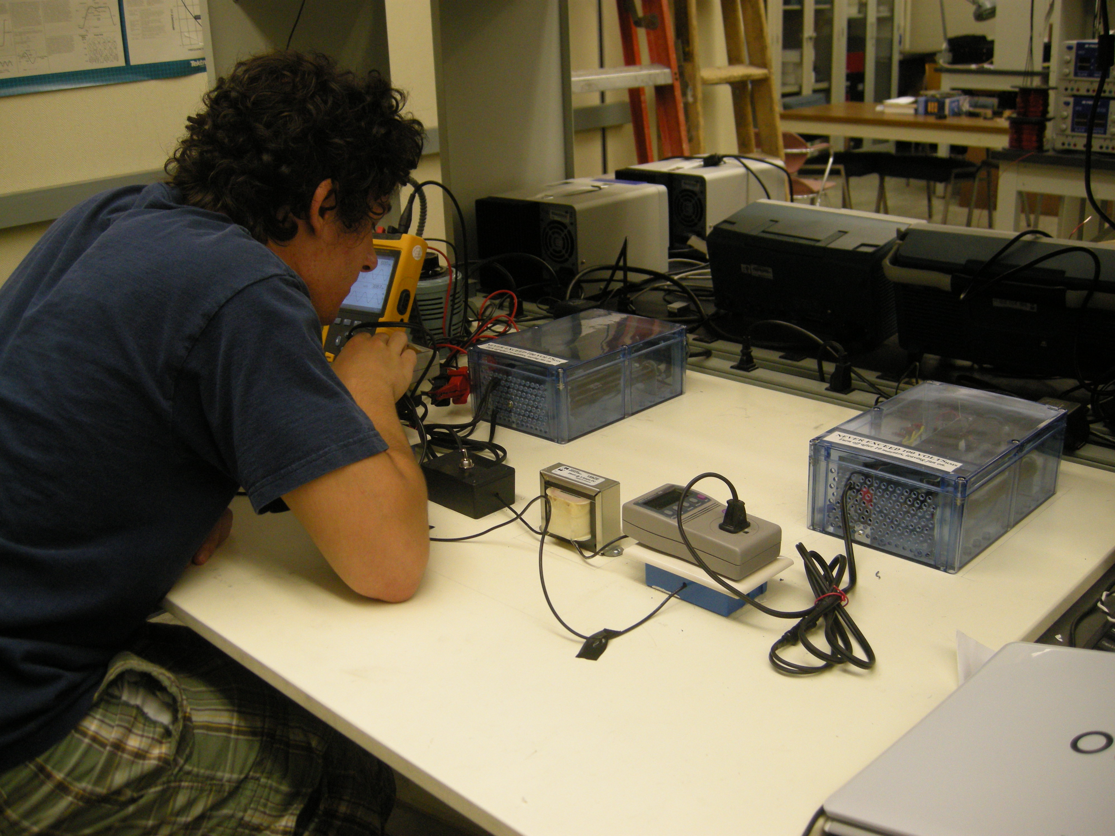
Pictures/DSCN5350.JPG
