edsammy/wipow/Pictures/DSCN5351.JPG

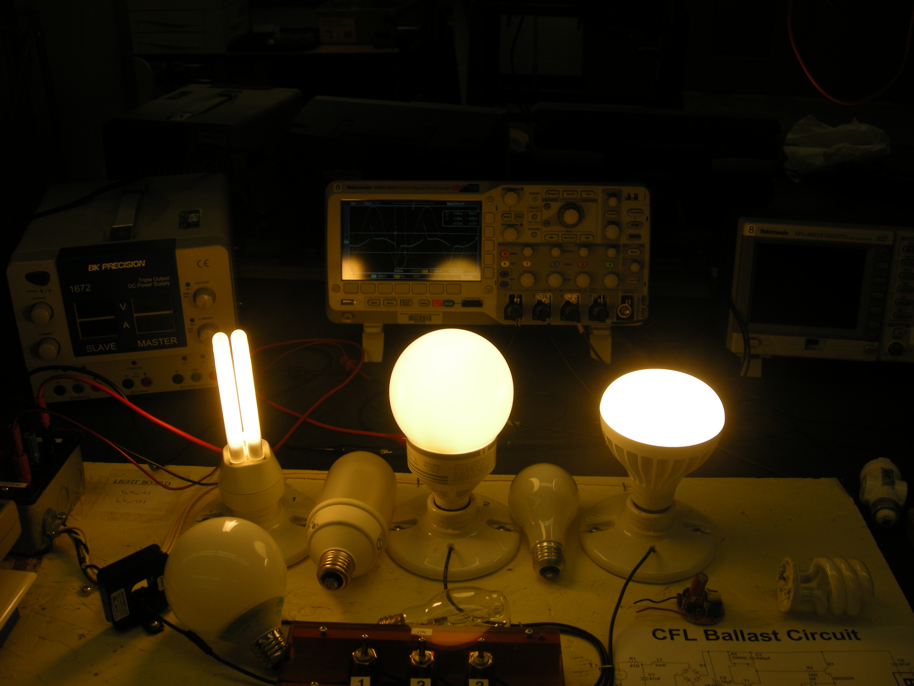
Pictures/DSCN5351.JPG
