edsammy/wipow/Pictures/DSCN5352.JPG

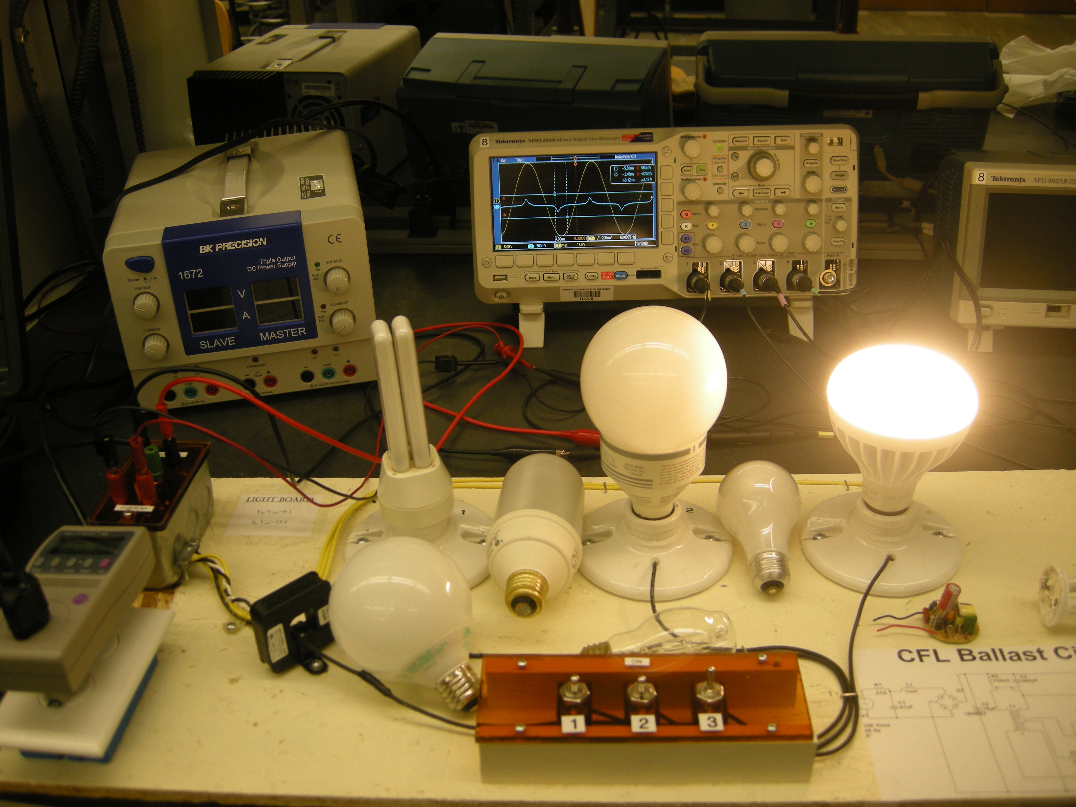
Pictures/DSCN5352.JPG
