edsammy/wipow/Pictures/DSCN5353.JPG

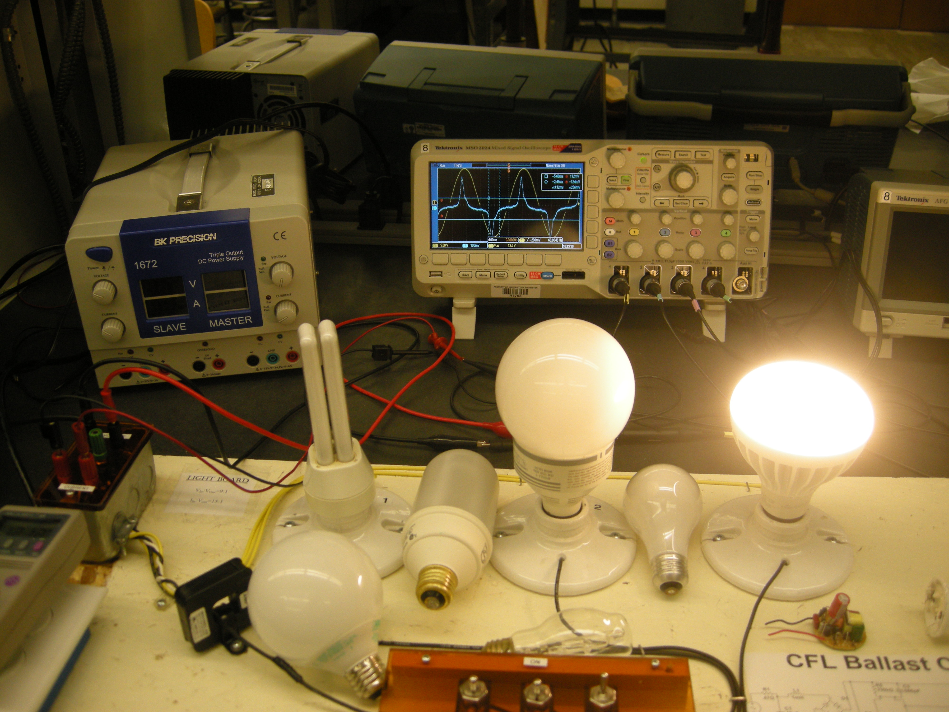
Pictures/DSCN5353.JPG
