edsammy/wipow/Pictures/DSCN5354.JPG

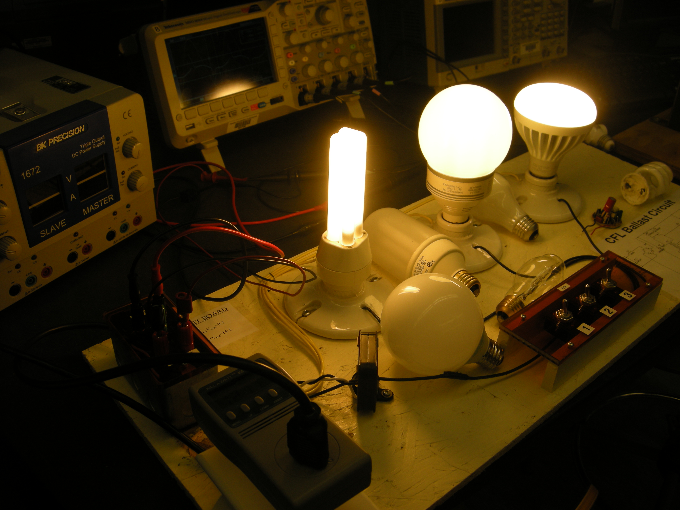
Pictures/DSCN5354.JPG
