edsammy/wipow/Pictures/DSCN5355.JPG

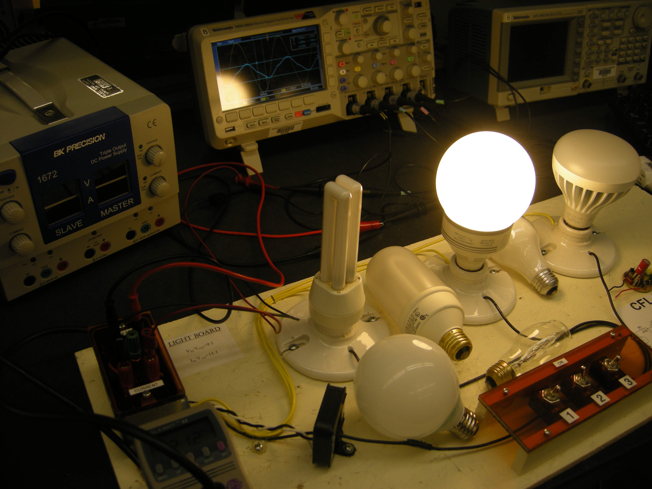
Pictures/DSCN5355.JPG
