edsammy/wipow/Pictures/DSCN5356.JPG

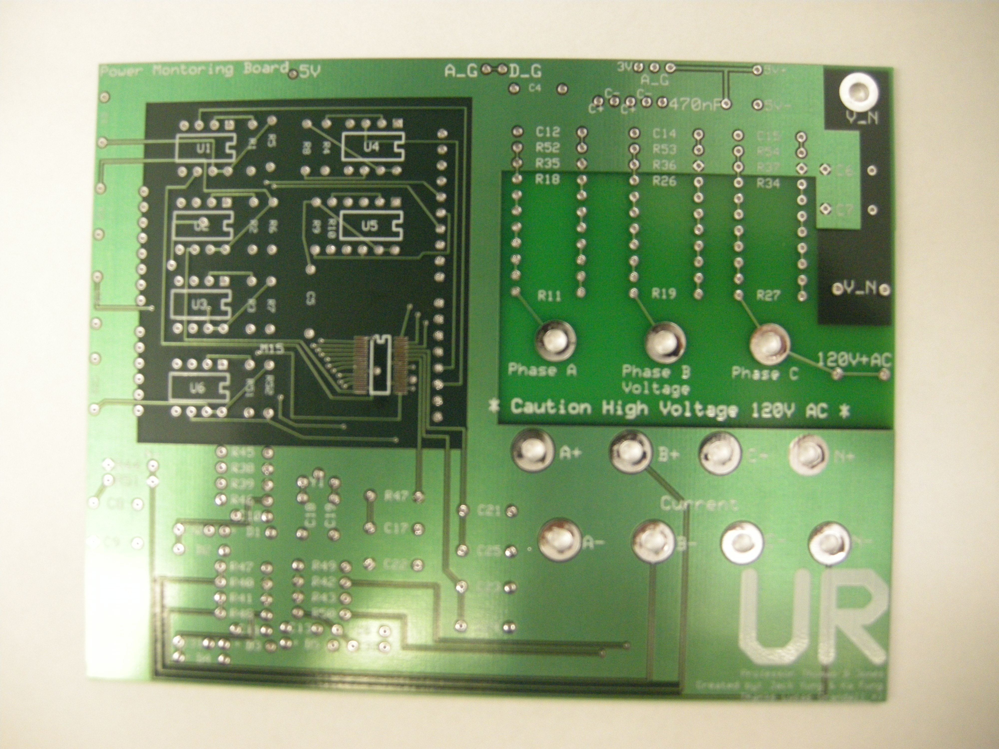
Pictures/DSCN5356.JPG
