edsammy/wipow/Pictures/DSCN5357.JPG

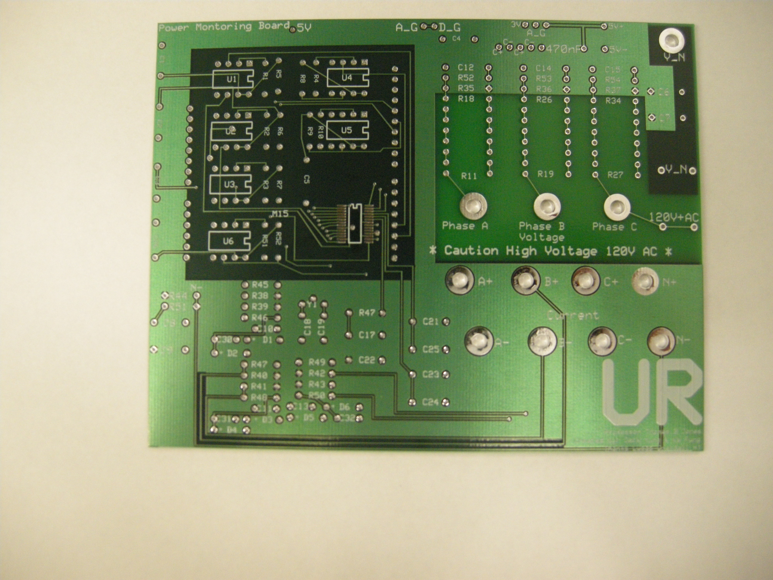
Pictures/DSCN5357.JPG
