edsammy/wipow/Pictures/DSCN5360.JPG

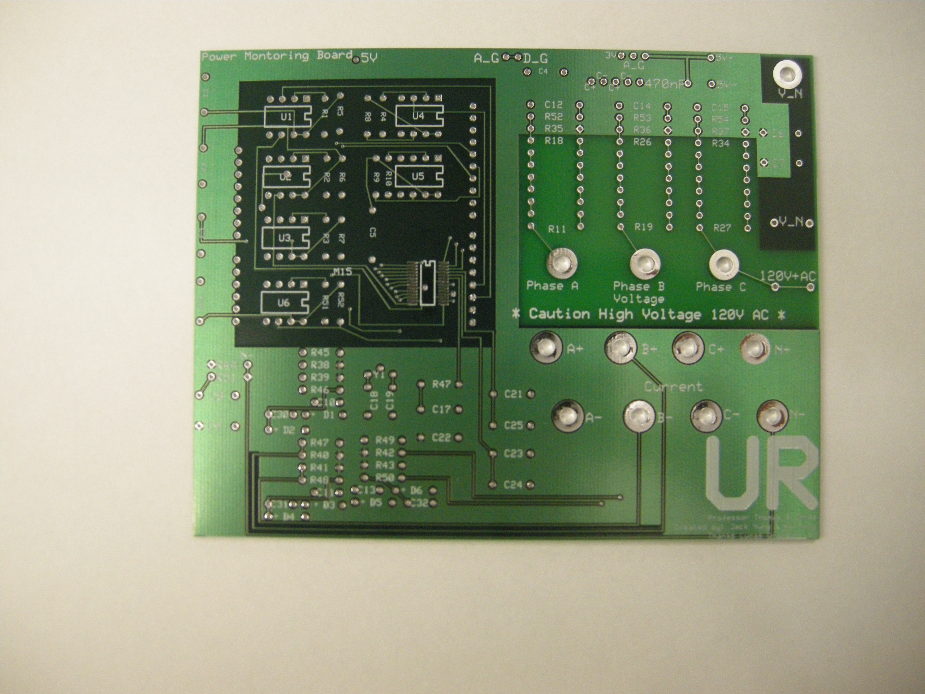
Pictures/DSCN5360.JPG
