edsammy/wipow/Pictures/DSCN5361.JPG

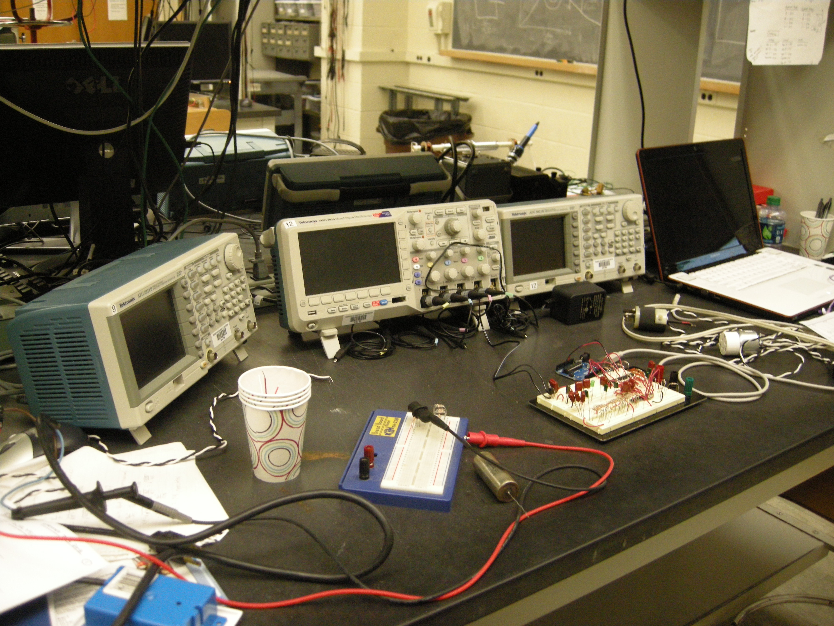
Pictures/DSCN5361.JPG
