edsammy/wipow/Pictures/DSCN5362.JPG

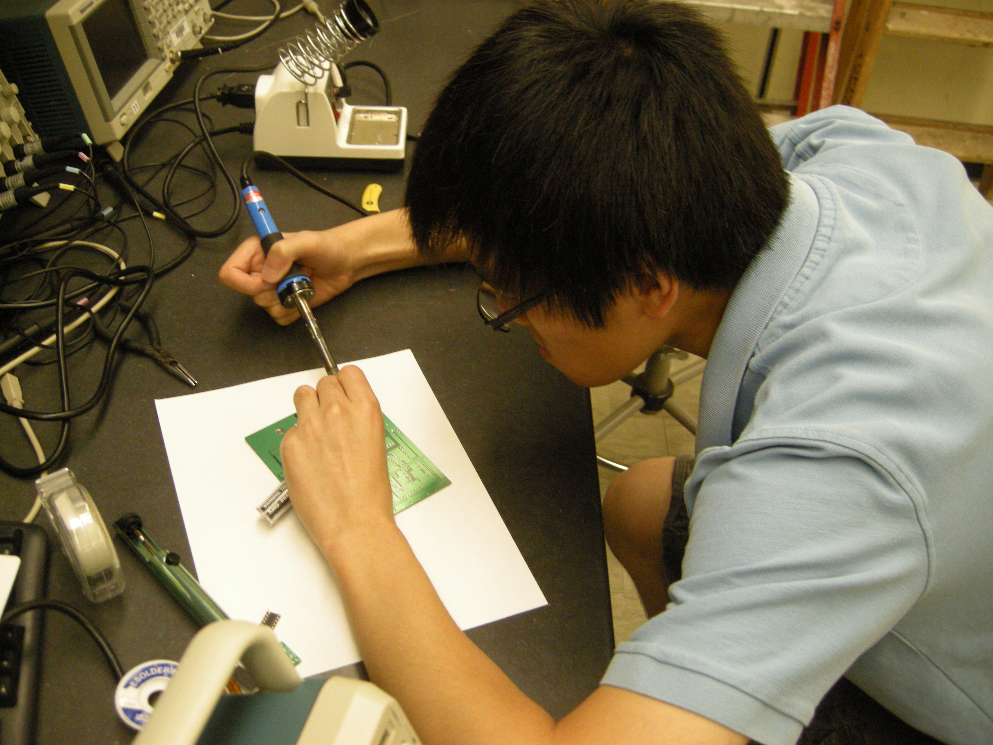
Pictures/DSCN5362.JPG
