edsammy/wipow/Pictures/DSCN5363.JPG

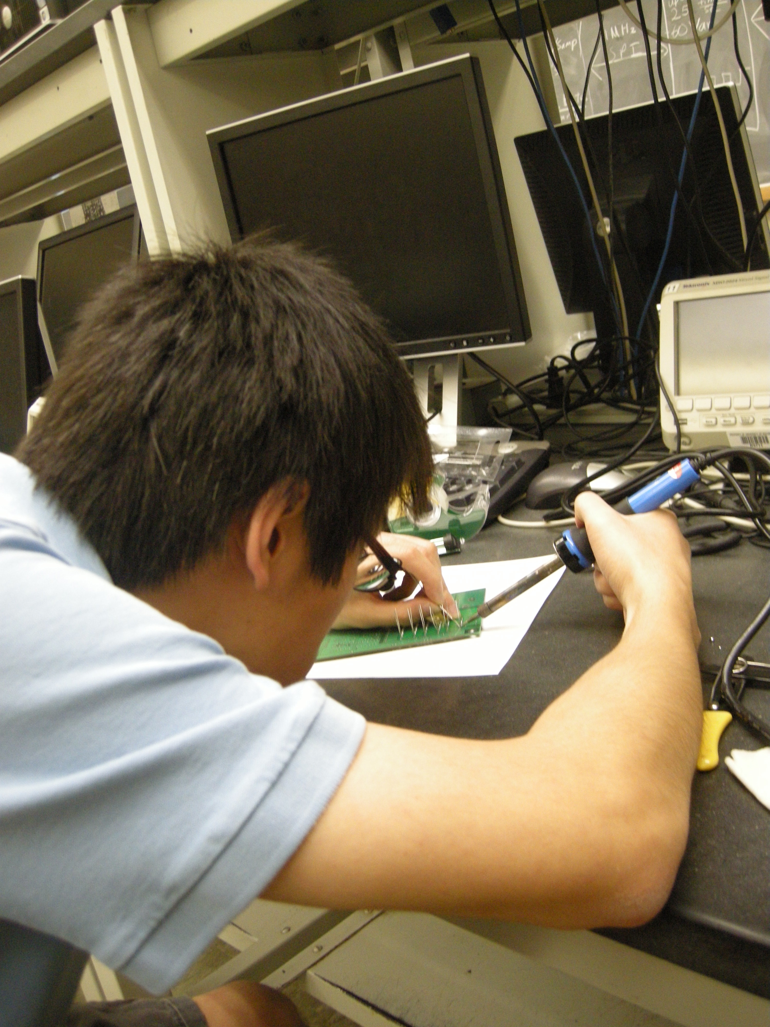
Pictures/DSCN5363.JPG
