edsammy/wipow/Pictures/DSCN5364.JPG

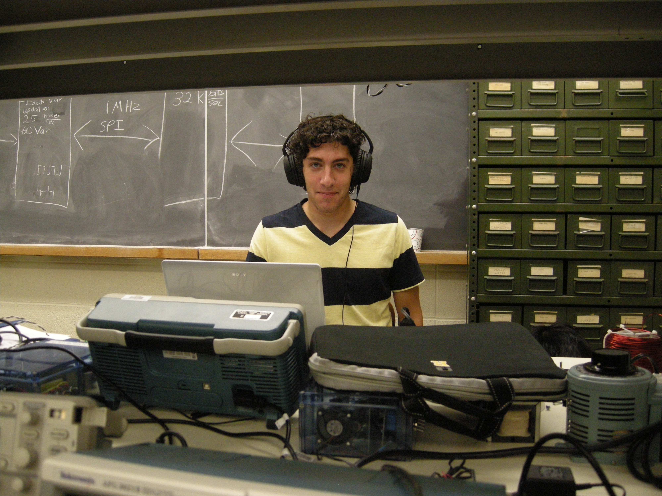
Pictures/DSCN5364.JPG
