edsammy/wipow/Pictures/DSCN5375.JPG

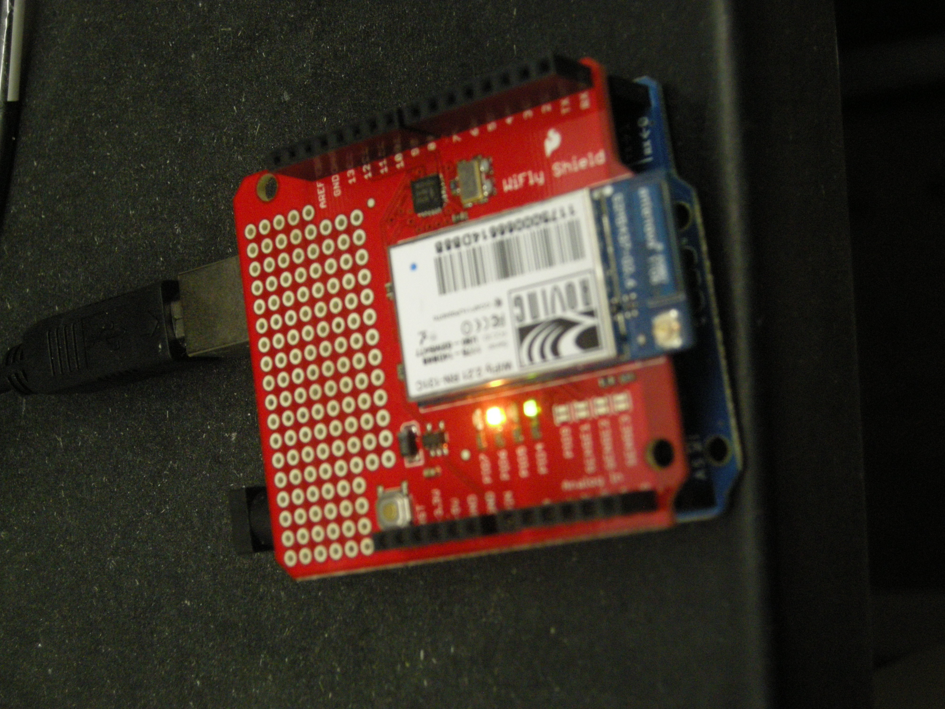
Pictures/DSCN5375.JPG
