edsammy/wipow/Pictures/DSCN5383.JPG

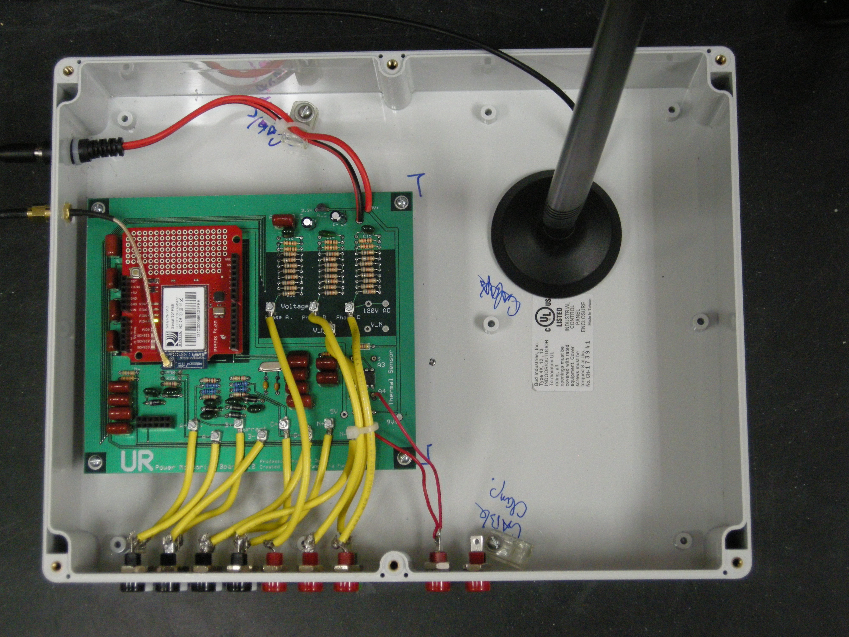
Pictures/DSCN5383.JPG
