edsammy/wipow/Pictures/DSCN5384.JPG

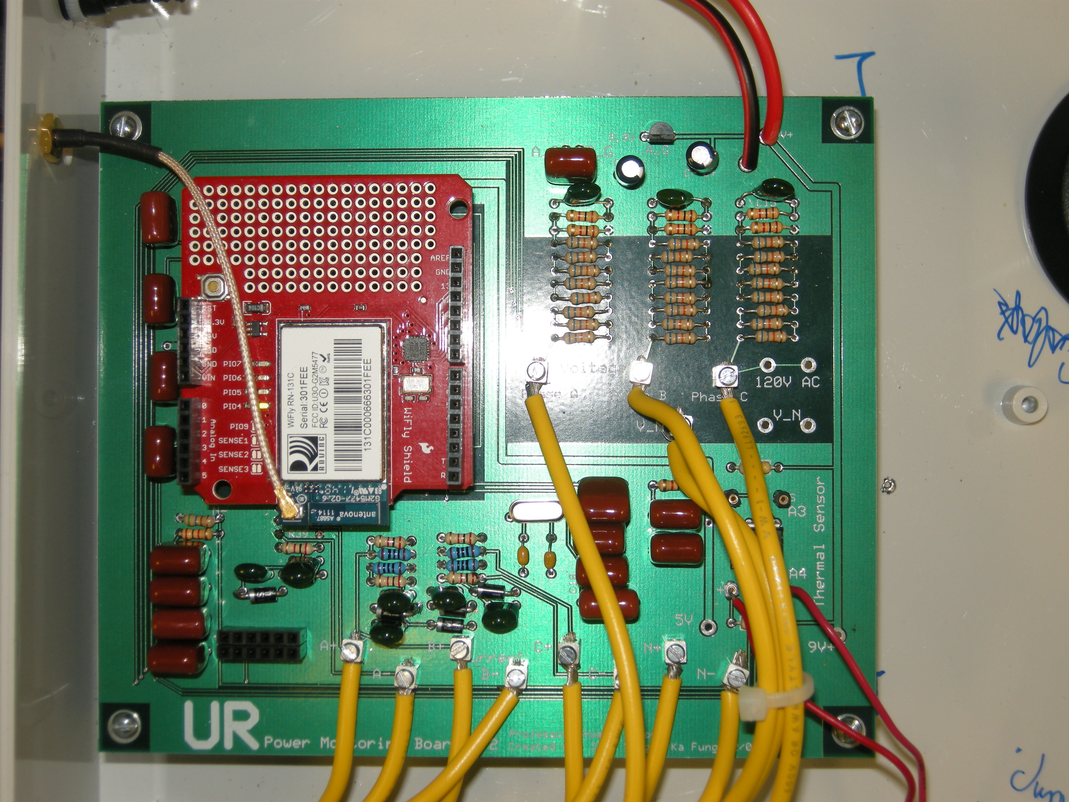
Pictures/DSCN5384.JPG
