edsammy/wipow/Pictures/DSCN5385.JPG

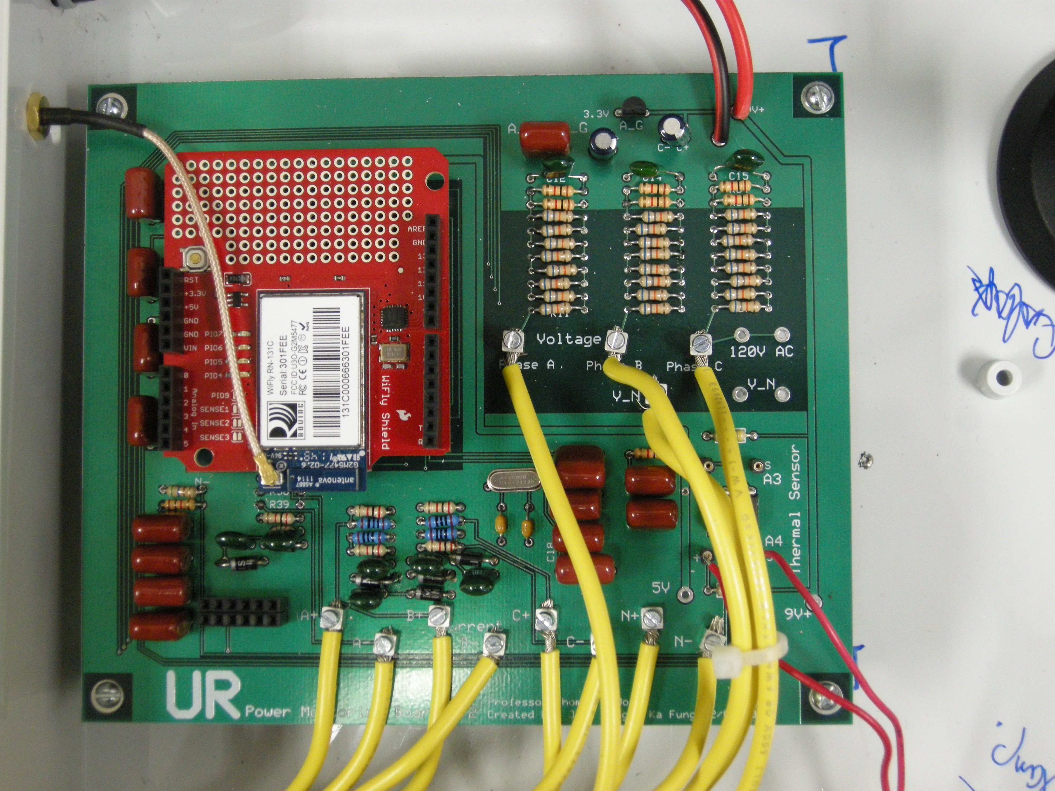
Pictures/DSCN5385.JPG
