edsammy/wipow/Pictures/DSCN5388.JPG

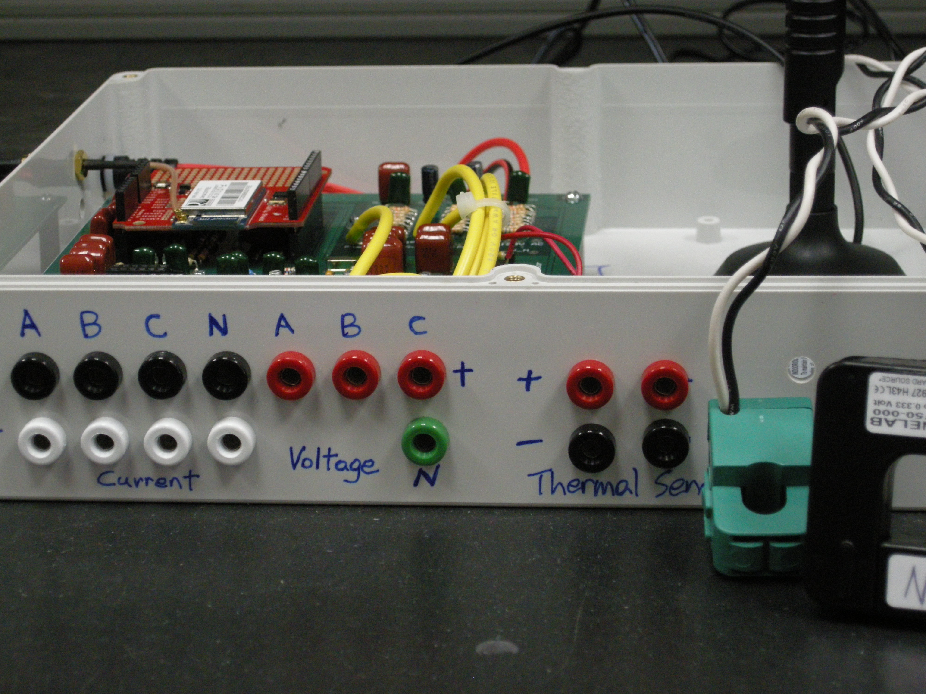
Pictures/DSCN5388.JPG
