edsammy/wipow/Pictures/DSCN5389.JPG

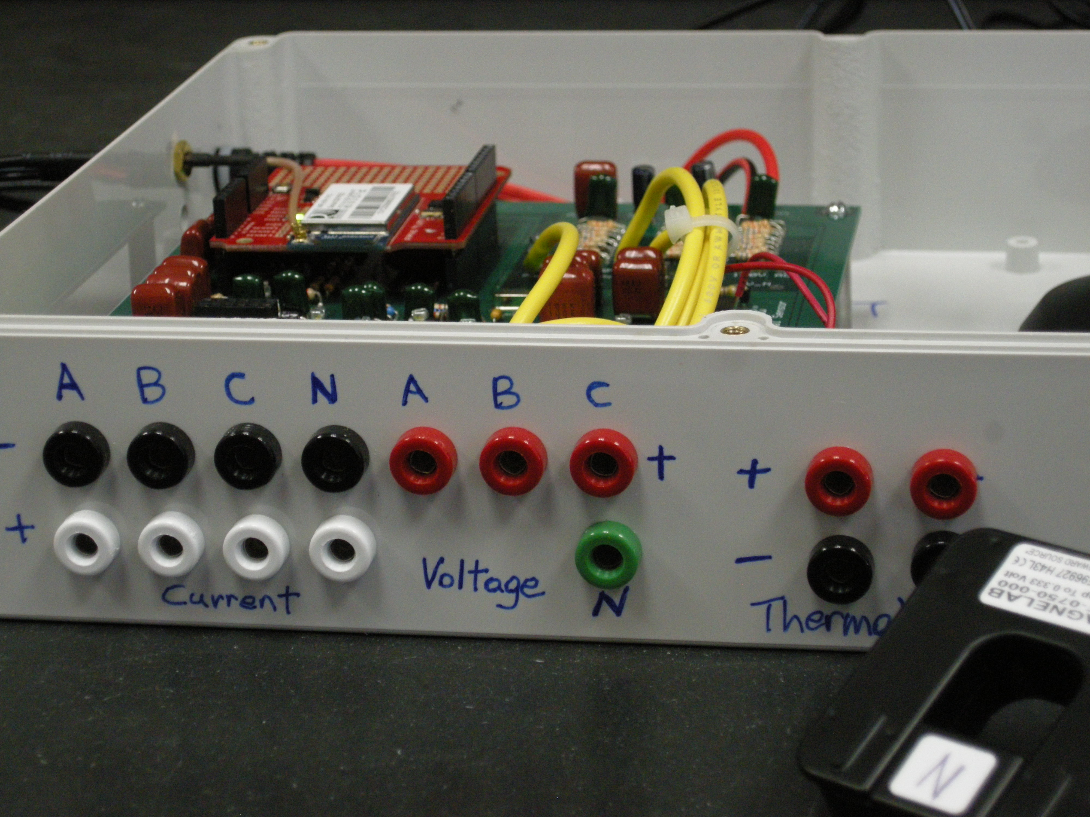
Pictures/DSCN5389.JPG
