edsammy/wipow/Pictures/DSCN5390.JPG

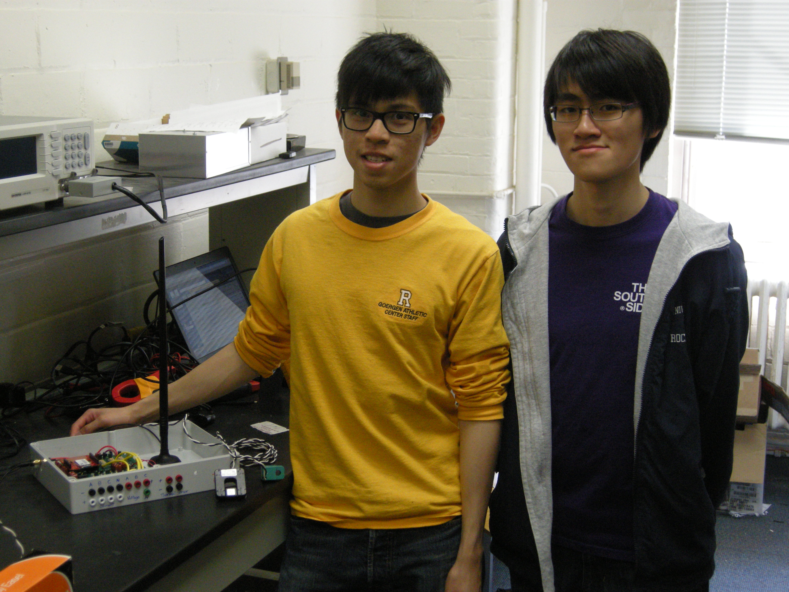
Pictures/DSCN5390.JPG
