edsammy/wipow/Pictures/DSCN5393.JPG

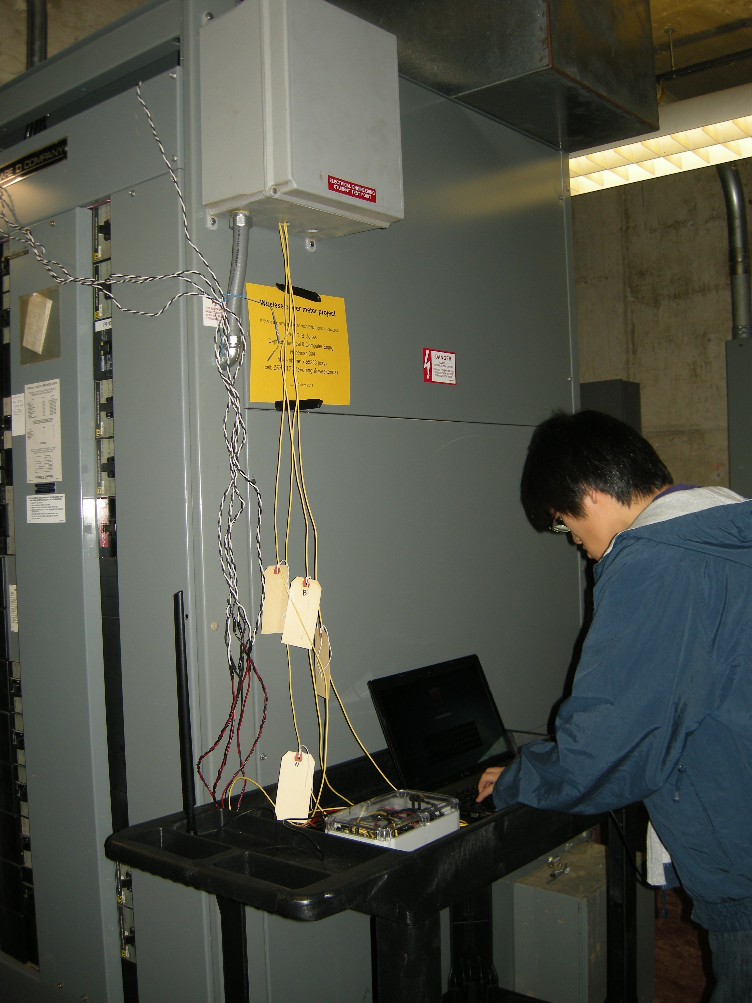
Pictures/DSCN5393.JPG
