edsammy/wipow/Pictures/DSCN5394.JPG

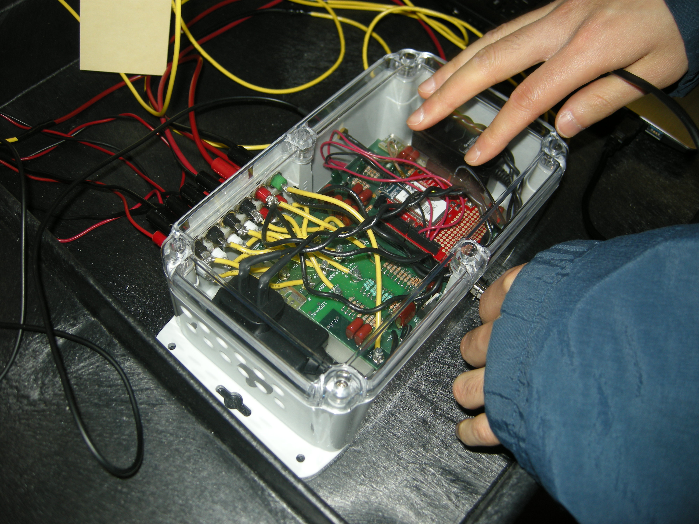
Pictures/DSCN5394.JPG
