edsammy/wipow/Pictures/DSCN5395.JPG

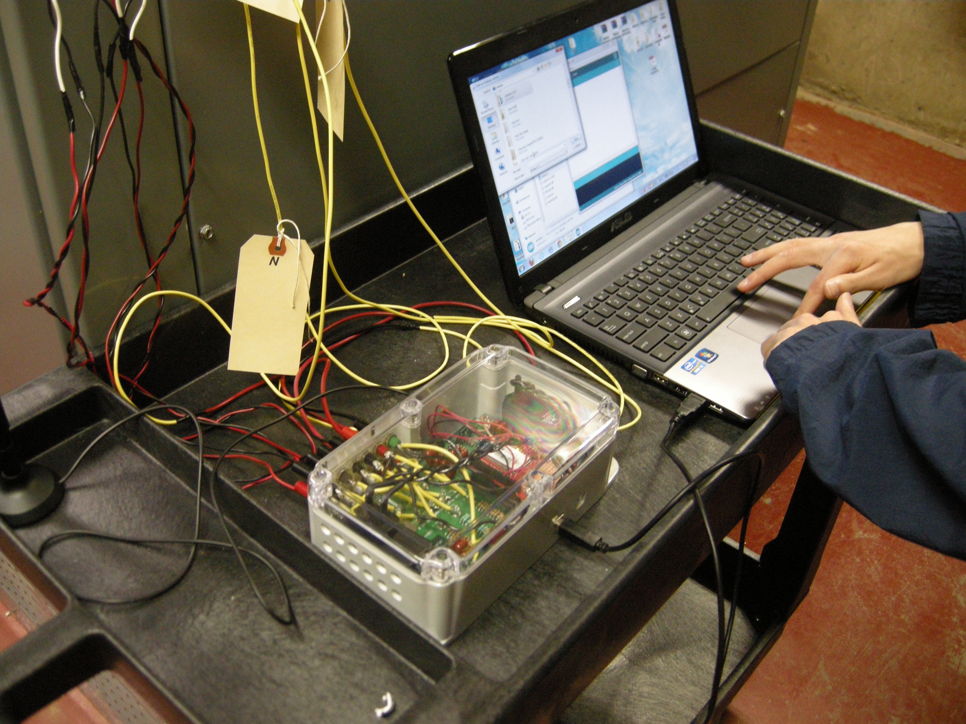
Pictures/DSCN5395.JPG
