edsammy/wipow/Pictures/DSCN5396.JPG

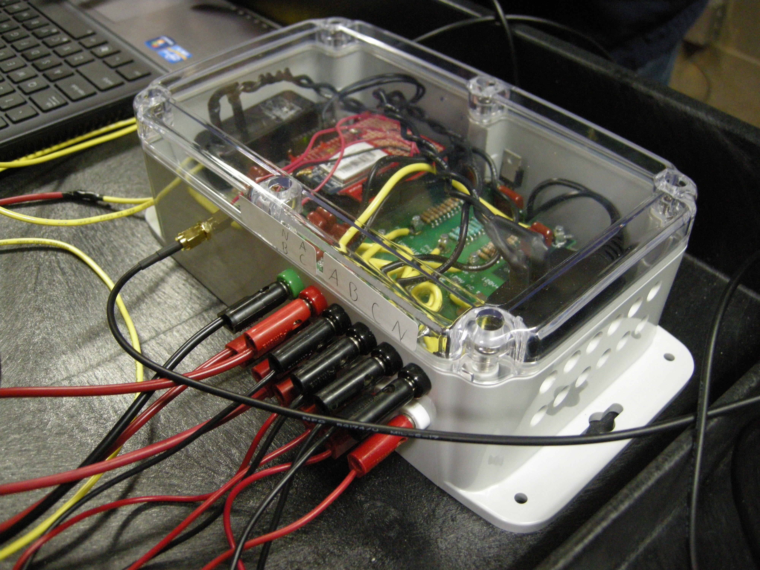
Pictures/DSCN5396.JPG
