edsammy/wipow/Pictures/DSCN5397.JPG

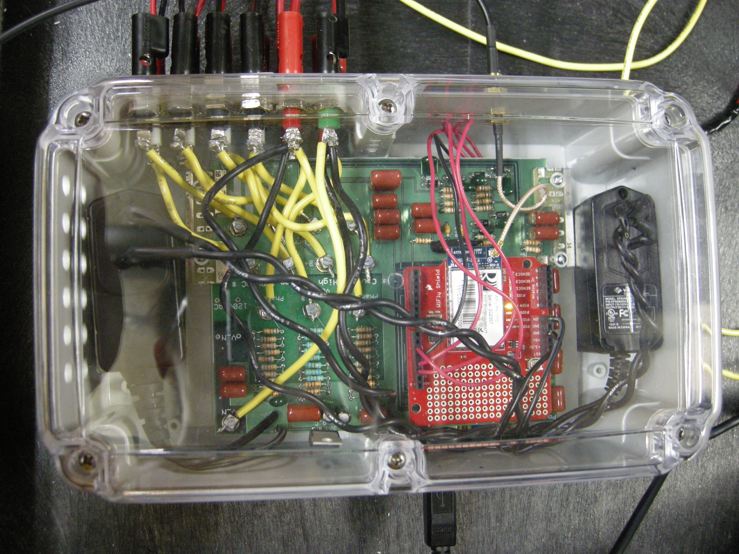
Pictures/DSCN5397.JPG
