edsammy/wipow/Pictures/DSCN5399.JPG

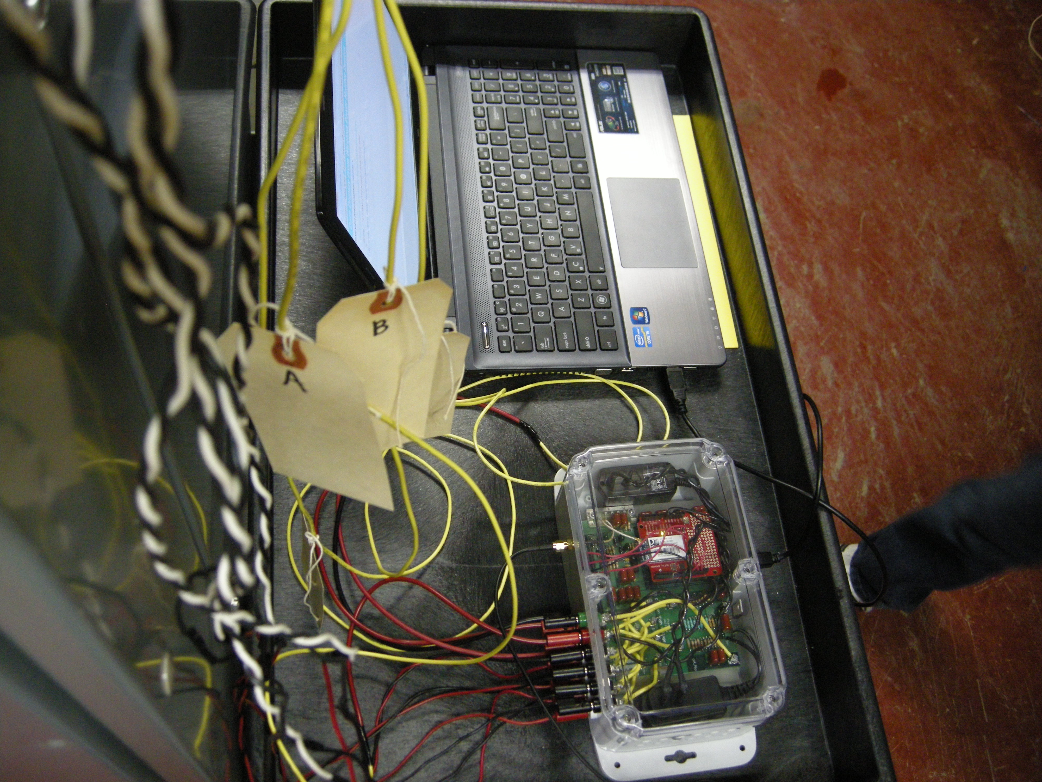
Pictures/DSCN5399.JPG
