edsammy/wipow/Pictures/DSCN5400.JPG

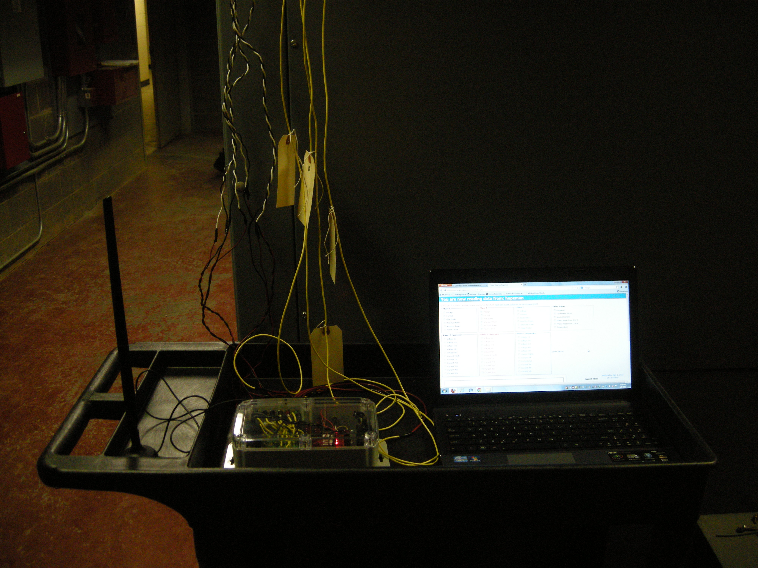
Pictures/DSCN5400.JPG
