edsammy/wipow/Pictures/DSCN5401.JPG

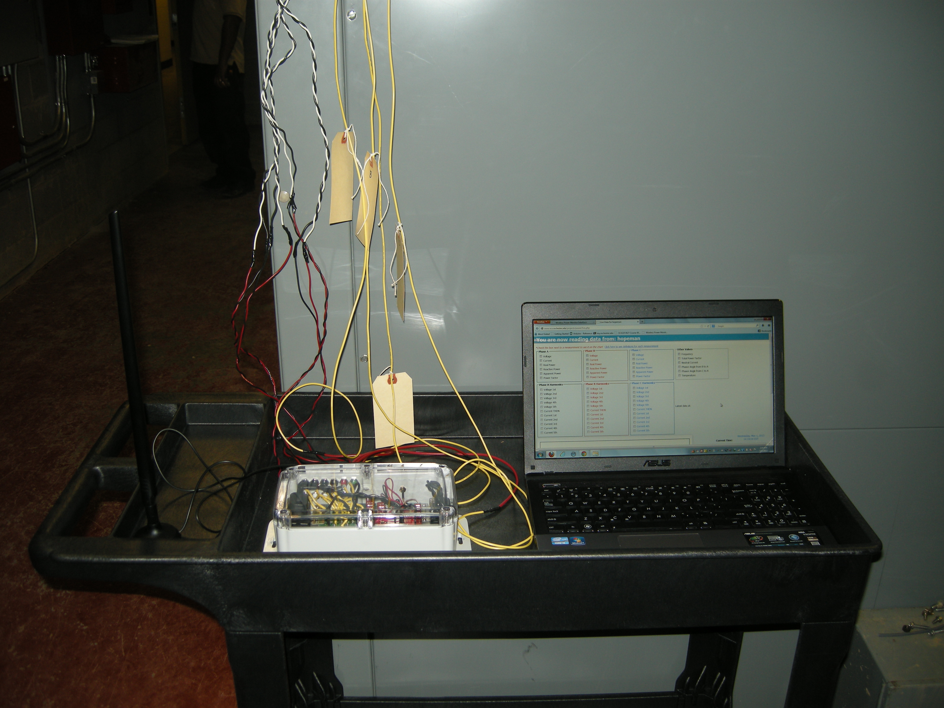
Pictures/DSCN5401.JPG
