edsammy/wipow/Pictures/DSCN5402.JPG

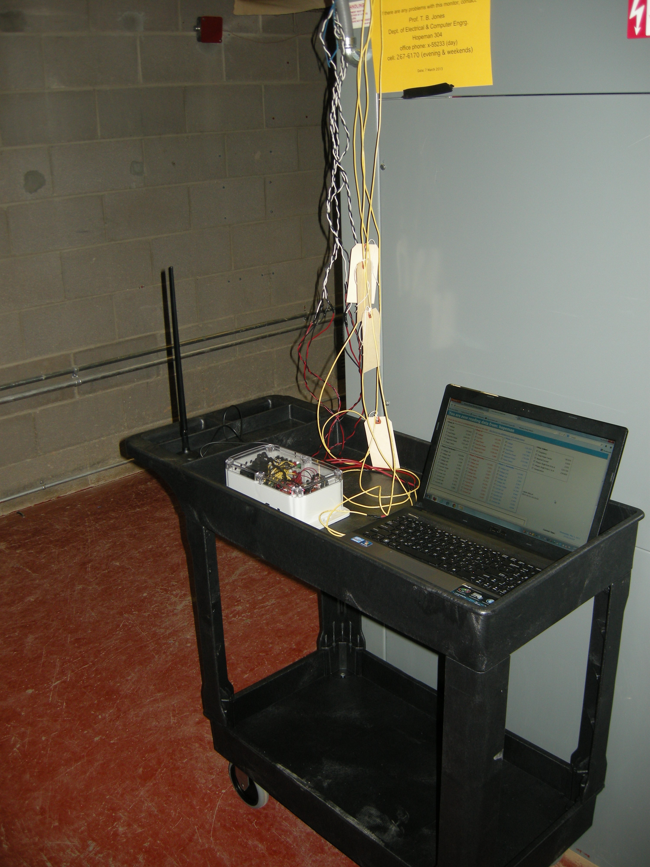
Pictures/DSCN5402.JPG
