edsammy/wipow/Pictures/DSCN5403.JPG

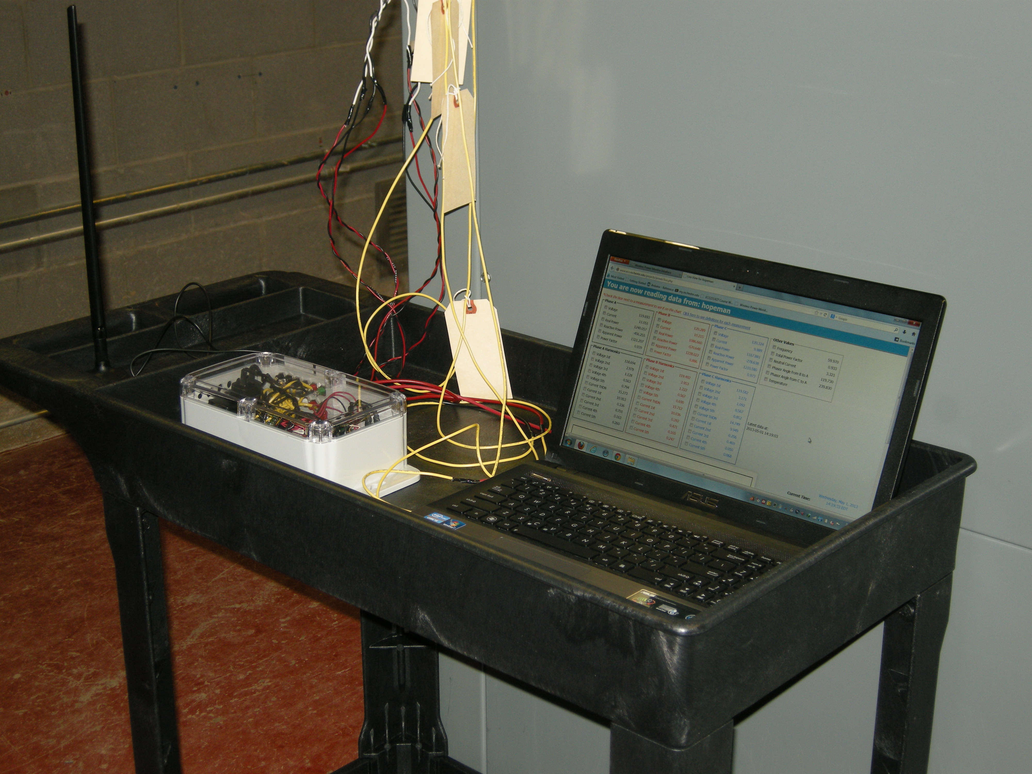
Pictures/DSCN5403.JPG
