edsammy/wipow/Pictures/DSCN5404.JPG

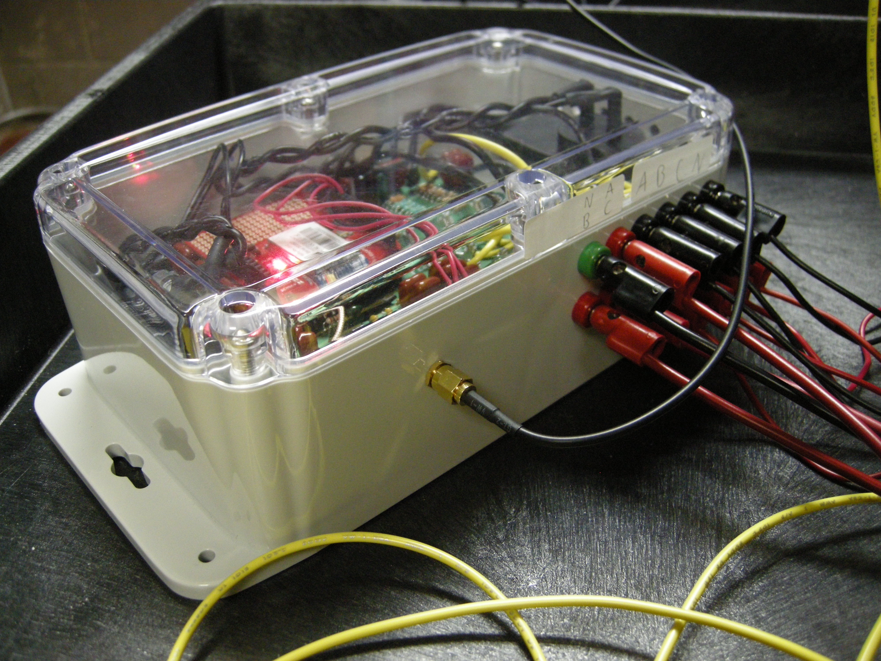
Pictures/DSCN5404.JPG
