edsammy/wipow/Pictures/DSCN5405.JPG

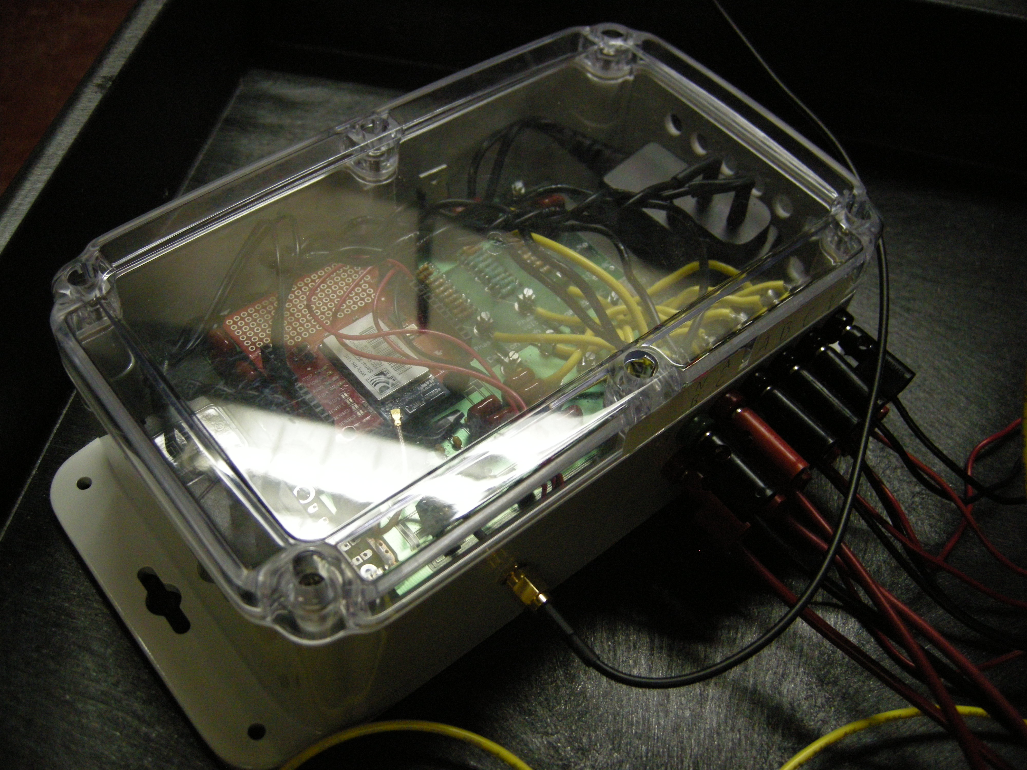
Pictures/DSCN5405.JPG
