edsammy/wipow/Pictures/IMG_1544.JPG

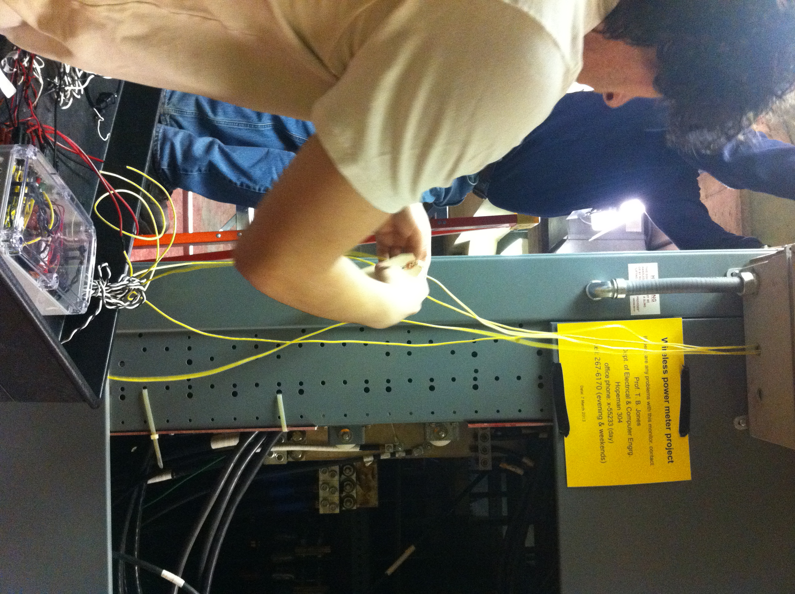
Pictures/IMG_1544.JPG
