edsammy/wipow/Pictures/IMG_1545.JPG

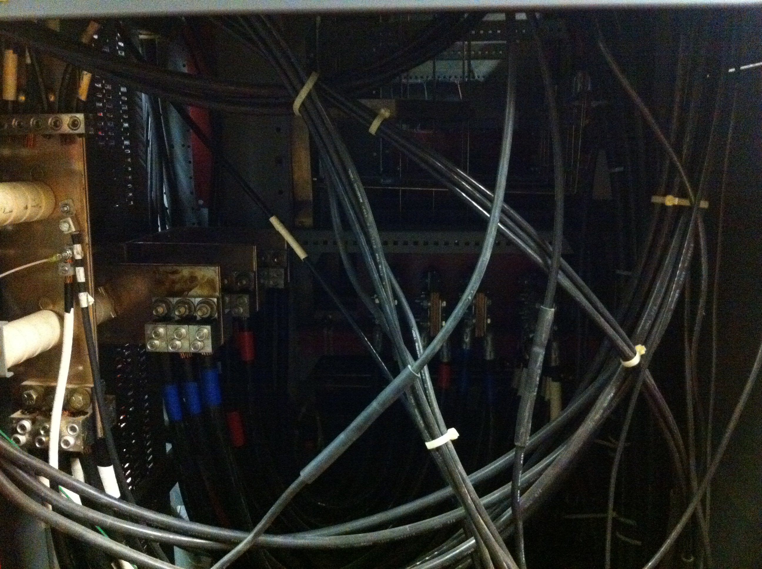
Pictures/IMG_1545.JPG
