edsammy/wipow/Pictures/IMG_1546.JPG

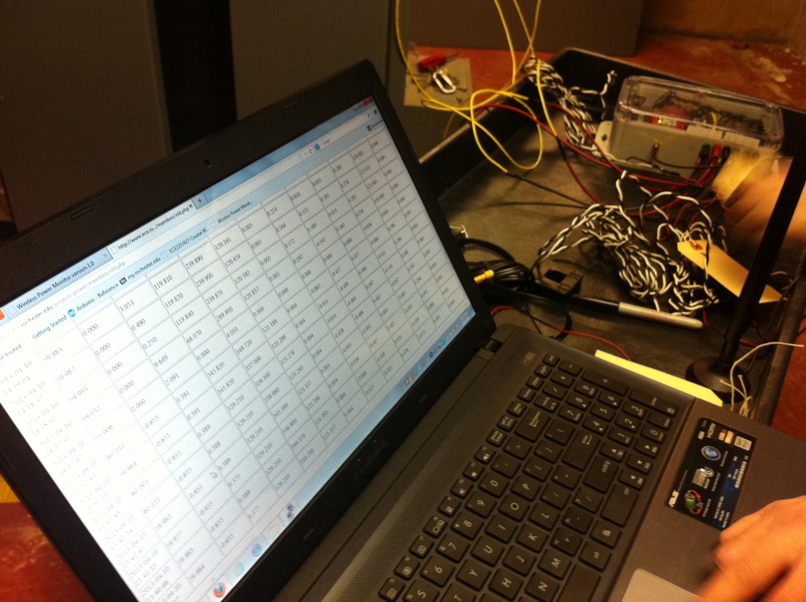
Pictures/IMG_1546.JPG
