edsammy/wipow/Pictures/IMG_1547.JPG

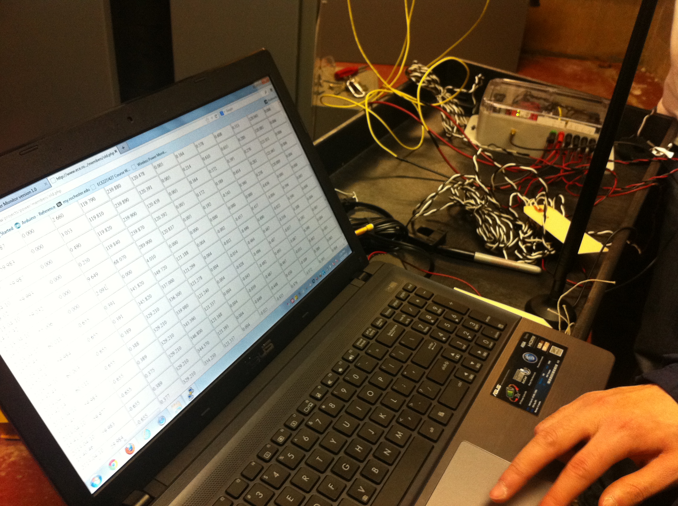
Pictures/IMG_1547.JPG
