edsammy/wipow/Pictures/IMG_1549.JPG

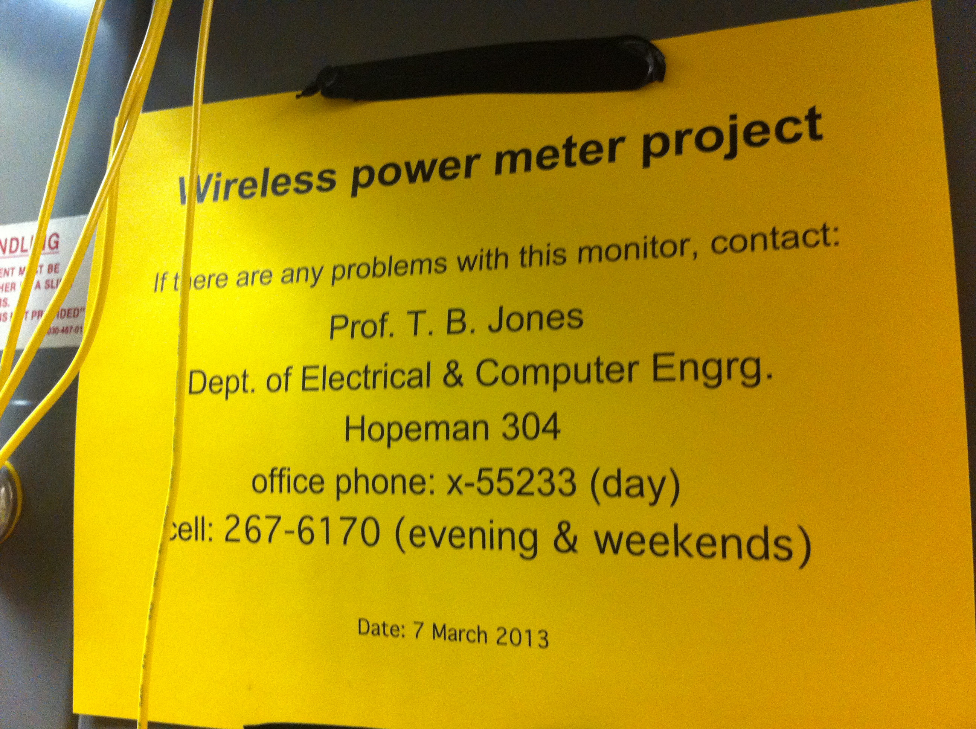
Pictures/IMG_1549.JPG
