edsammy/wipow/Pictures/IMG_1550.JPG

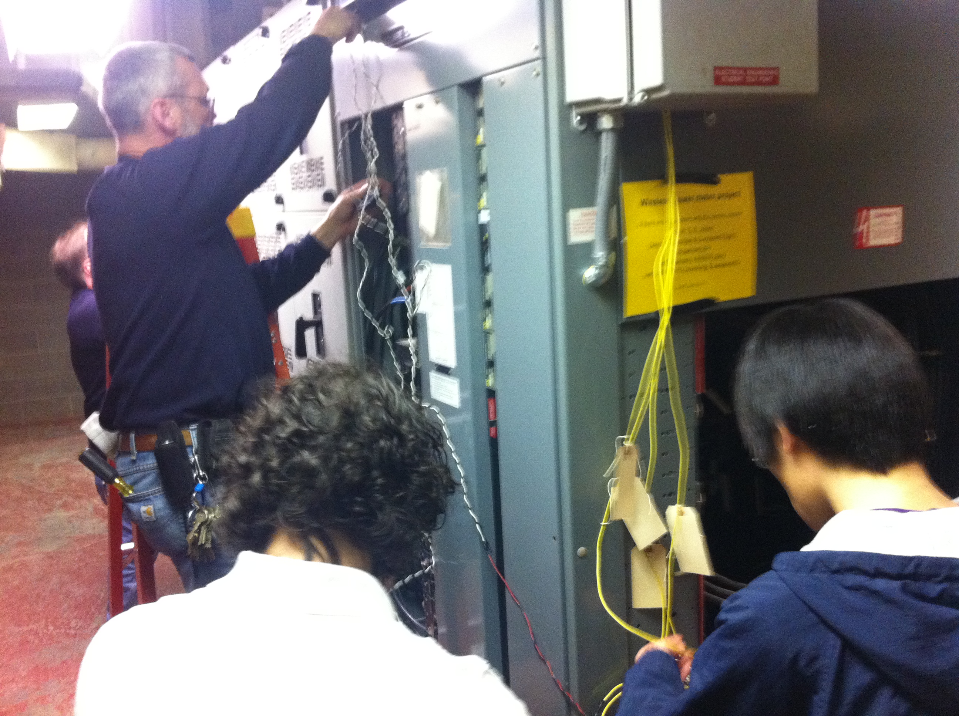
Pictures/IMG_1550.JPG
