edsammy/wipow/Pictures/IMG_1551.JPG

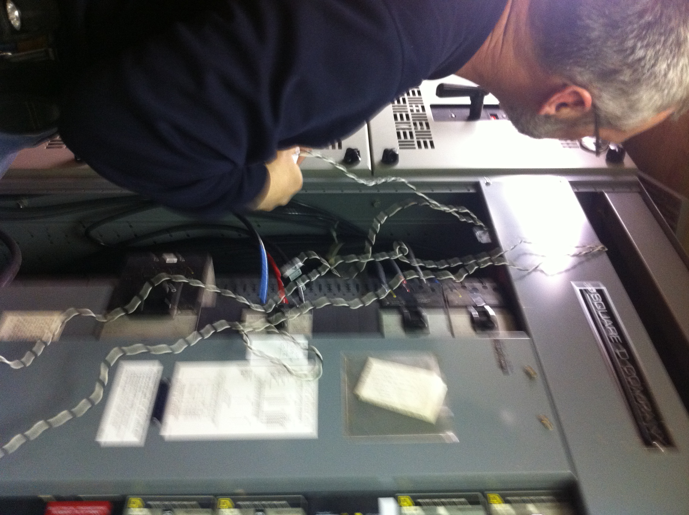
Pictures/IMG_1551.JPG
