edsammy/wipow/Pictures/IMG_1552.JPG

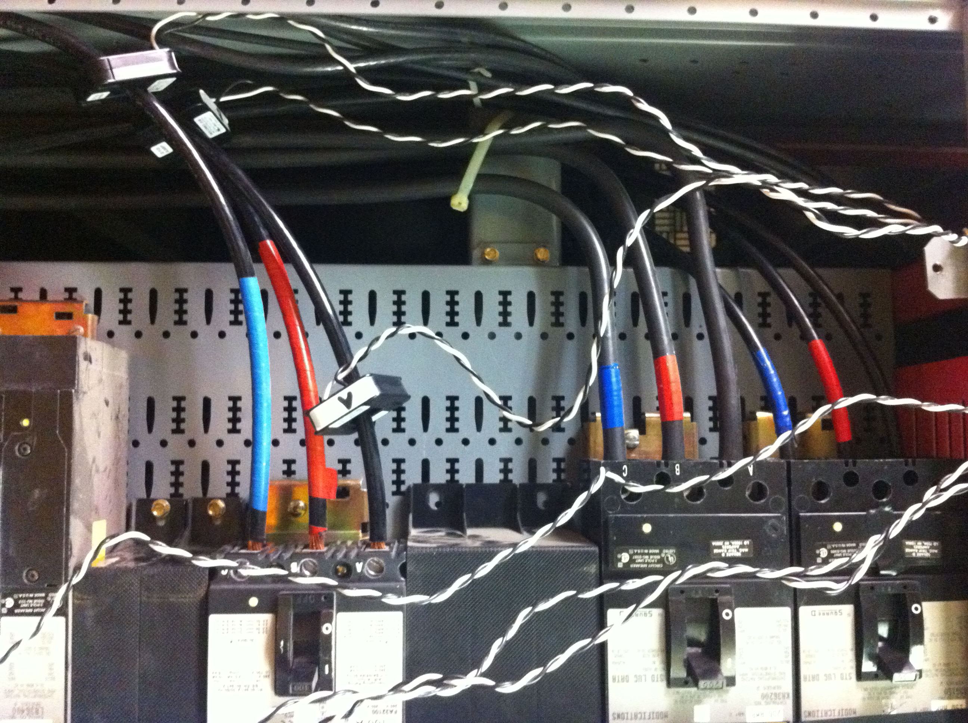
Pictures/IMG_1552.JPG
