edsammy/wipow/Pictures/IMG_1553.JPG

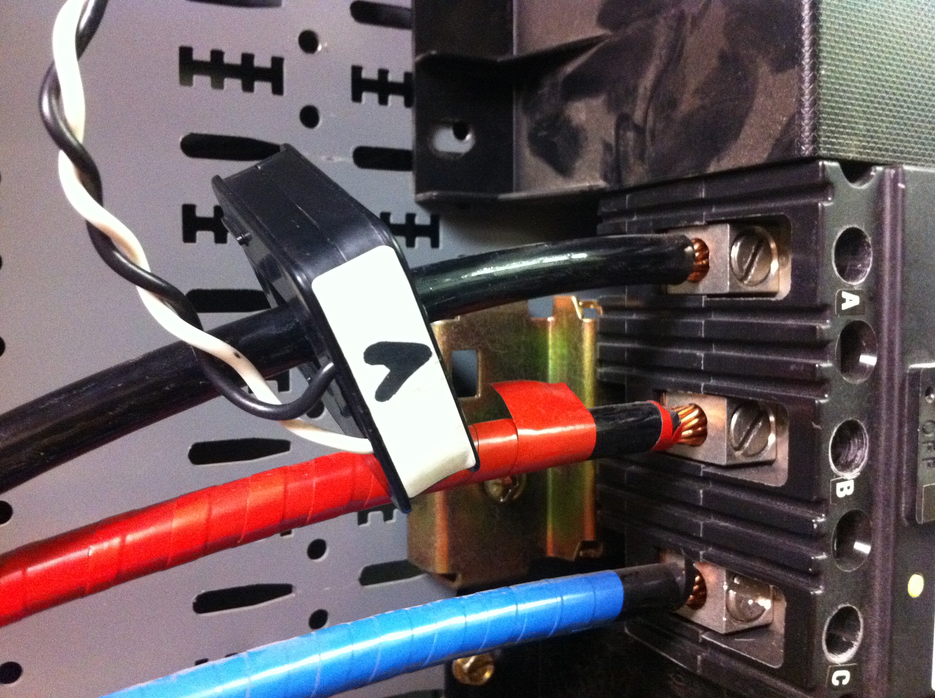
Pictures/IMG_1553.JPG
