edsammy/wipow/Pictures/IMG_1554.JPG

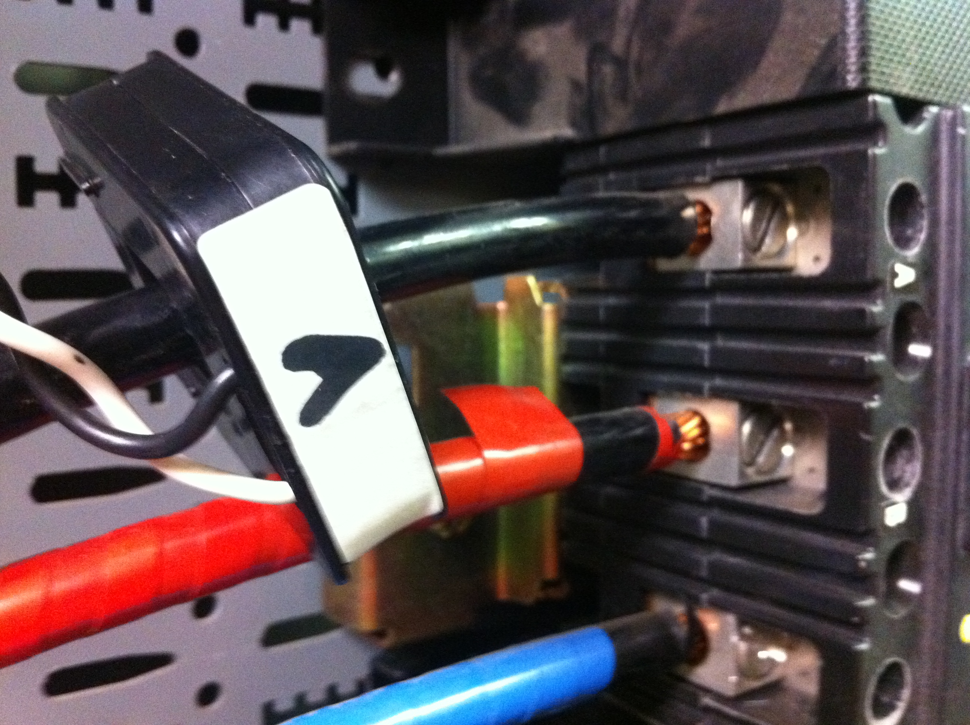
Pictures/IMG_1554.JPG
