edsammy/wipow/Pictures/IMG_1555.JPG

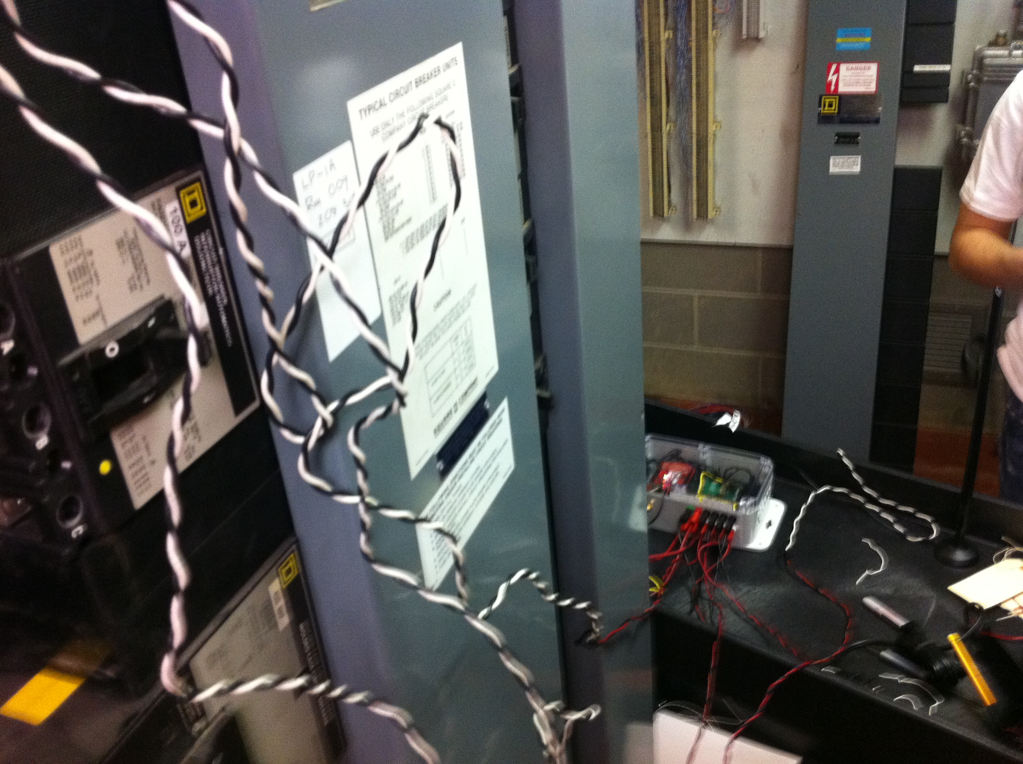
Pictures/IMG_1555.JPG
