edsammy/wipow/Pictures/IMG_1556.JPG

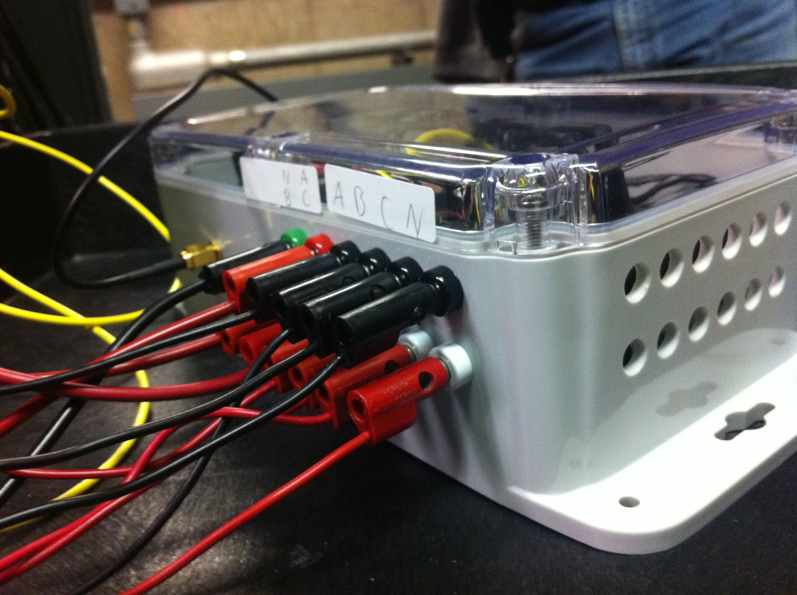
Pictures/IMG_1556.JPG
