edsammy/wipow/Pictures/IMG_1557.JPG

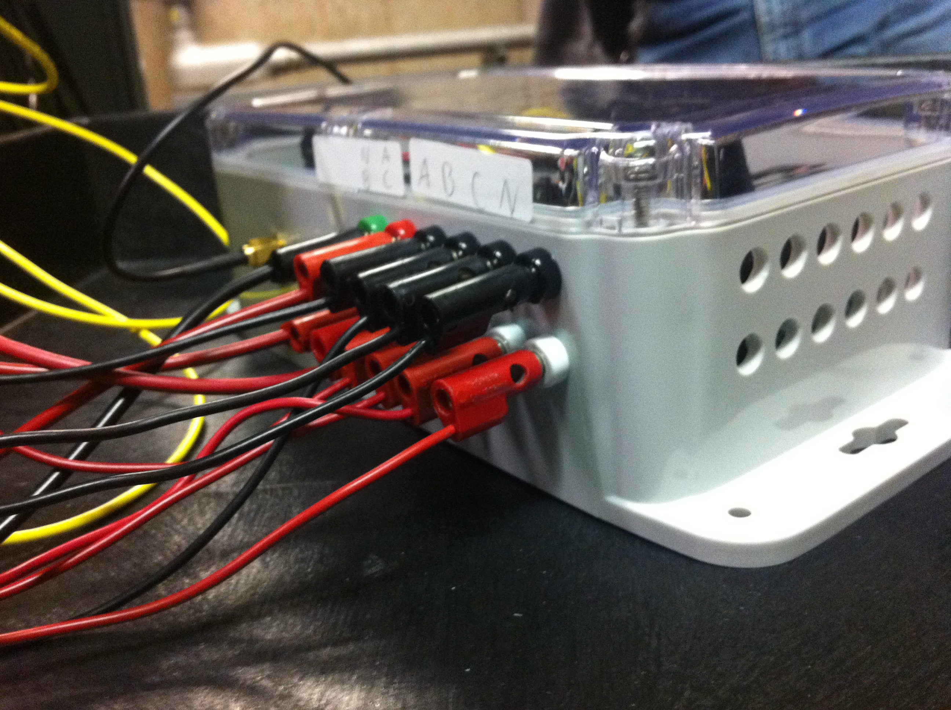
Pictures/IMG_1557.JPG
