edsammy/wipow/Pictures/IMG_1558.JPG

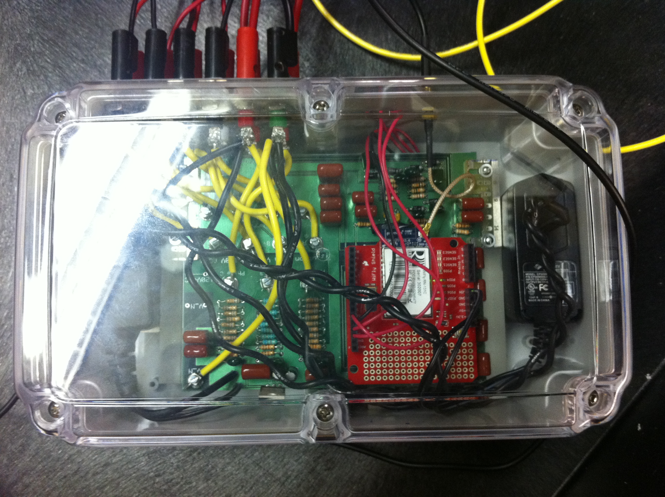
Pictures/IMG_1558.JPG
