edsammy/wipow/Pictures/IMG_1559.JPG

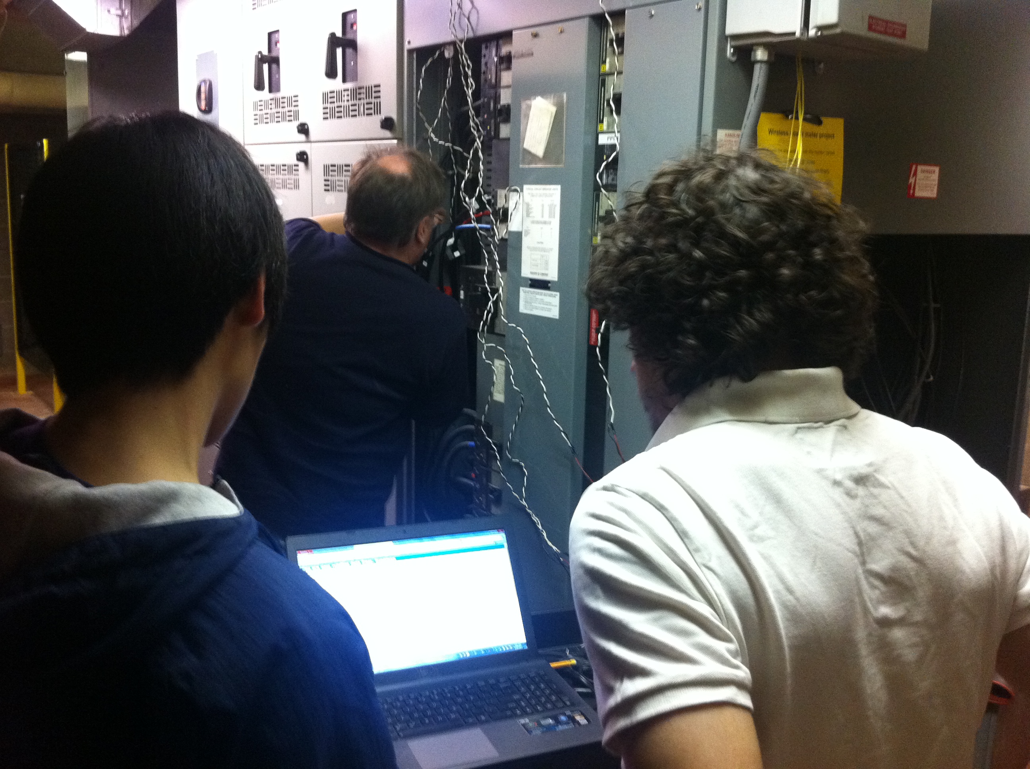
Pictures/IMG_1559.JPG
