edsammy/wipow/Pictures/IMG_1560.JPG

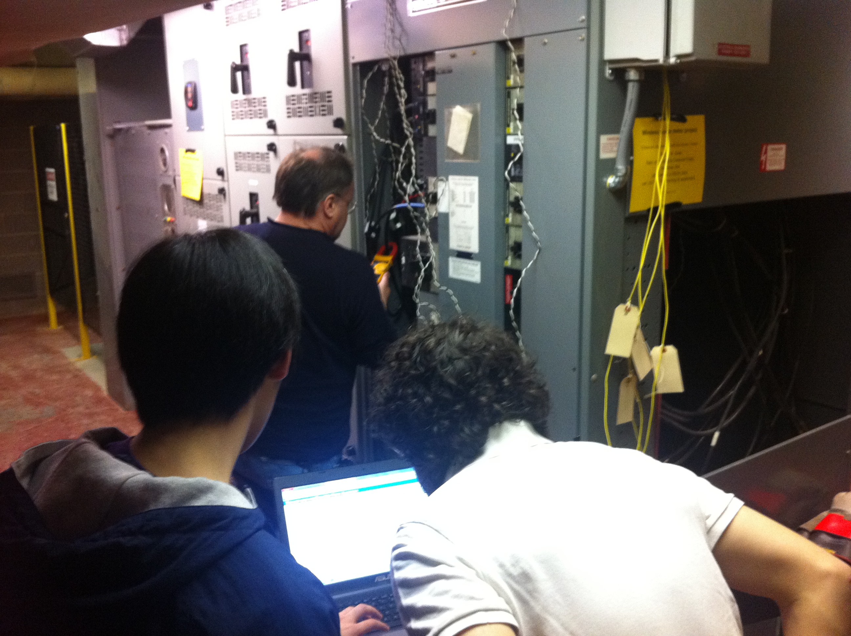
Pictures/IMG_1560.JPG
