edsammy/wipow/Pictures/IMG_1561.JPG

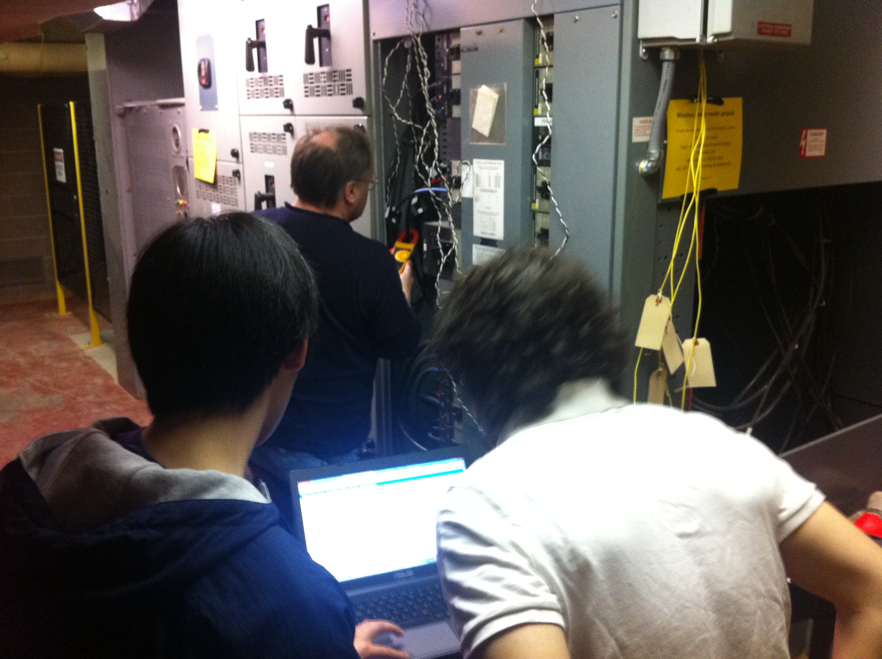
Pictures/IMG_1561.JPG
