edsammy/wipow/Pictures/IMG_1562.JPG

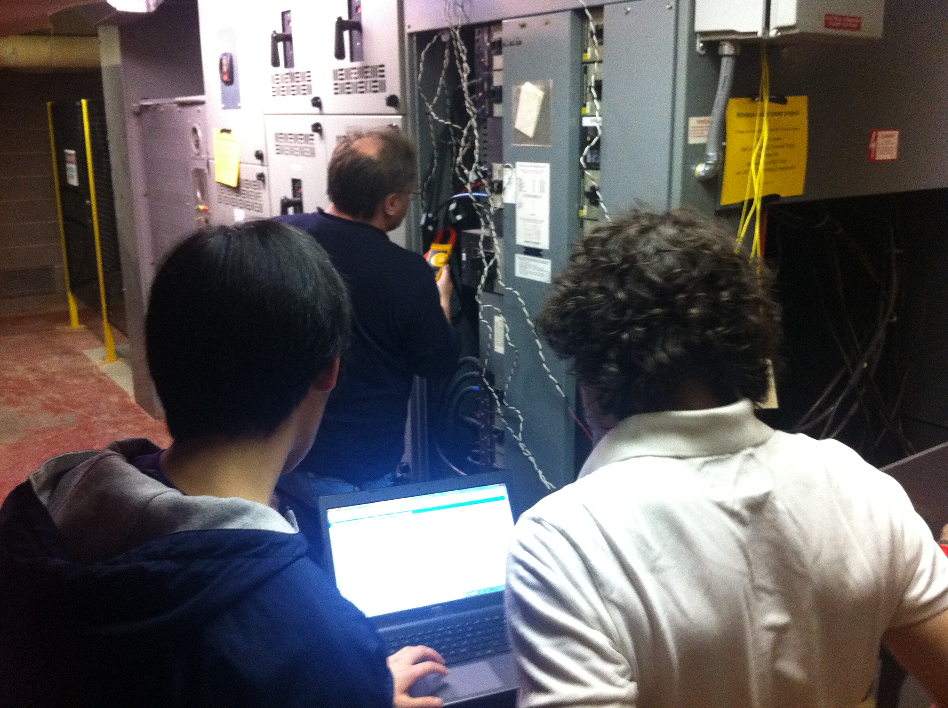
Pictures/IMG_1562.JPG
