edsammy/wipow/Pictures/IMG_1563.JPG

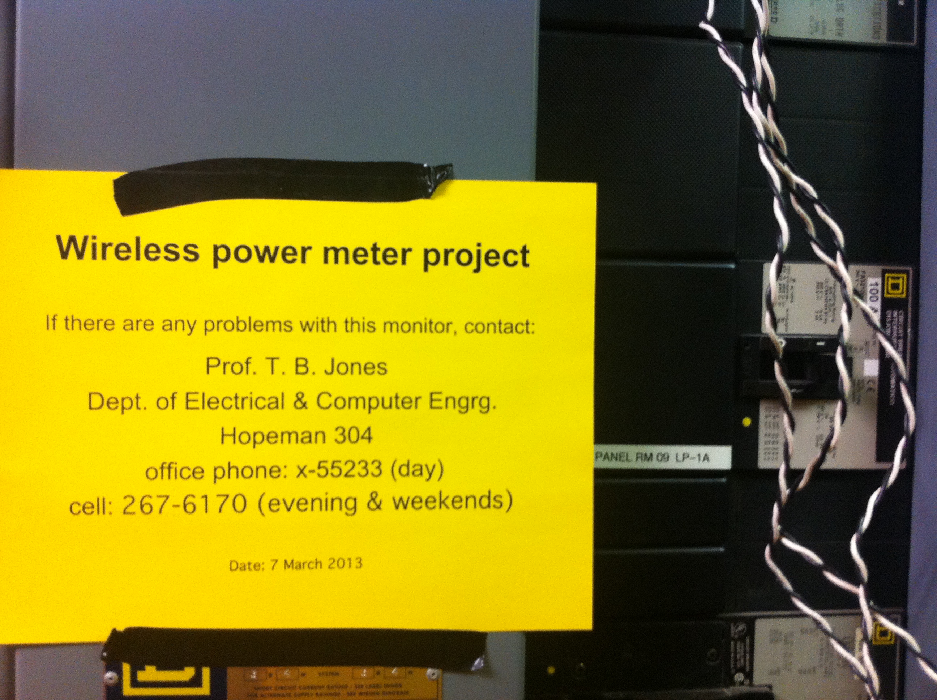
Pictures/IMG_1563.JPG
