edsammy/wipow/Pictures/IMG_1564.JPG

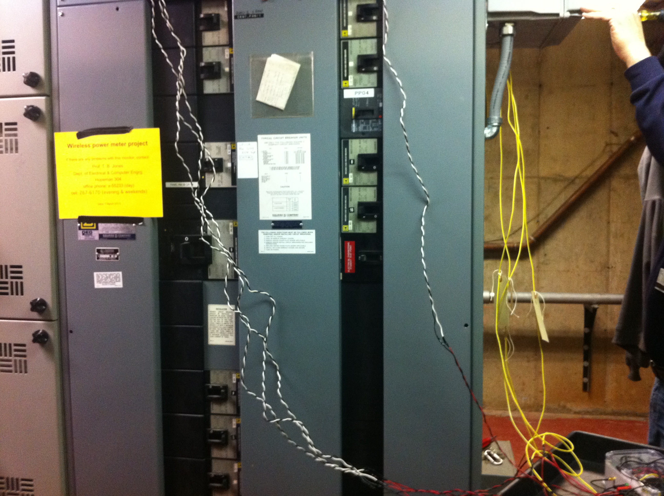
Pictures/IMG_1564.JPG
