edsammy/wipow/Pictures/IMG_1565.JPG

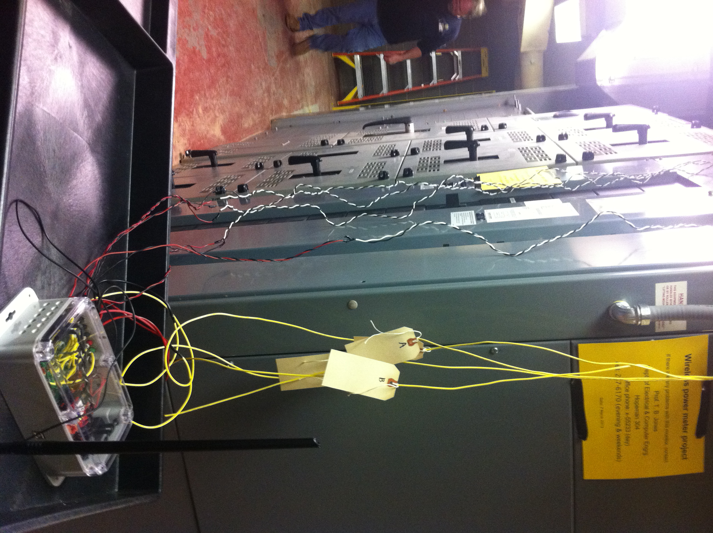
Pictures/IMG_1565.JPG
