edsammy/wipow/Pictures/P1030046.JPG

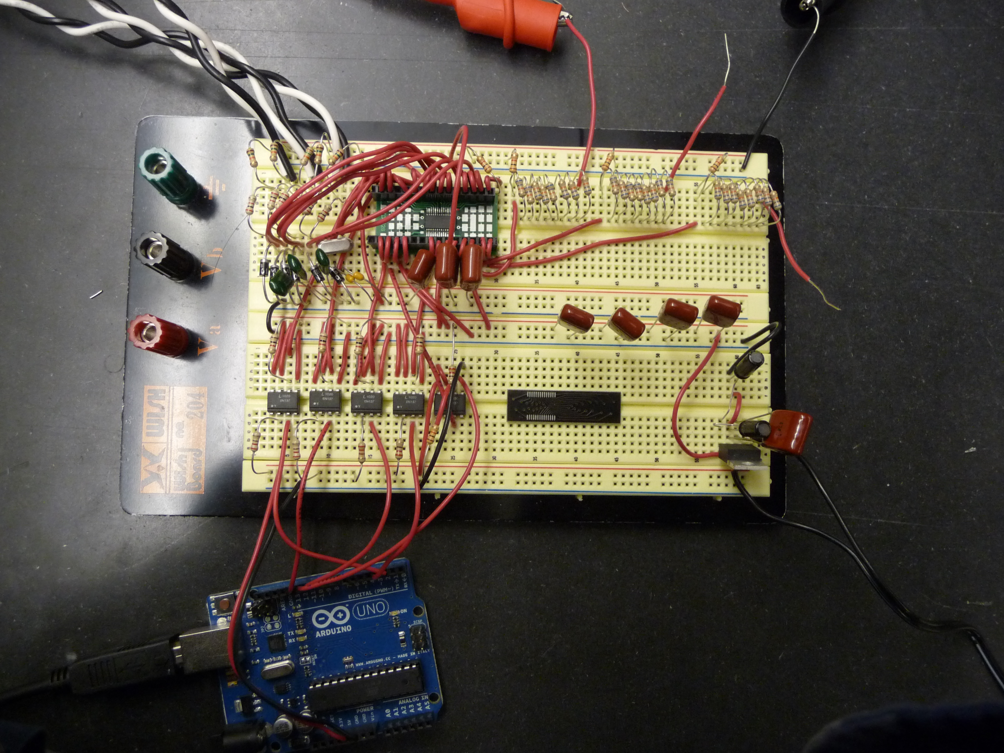
Pictures/P1030046.JPG
