edsammy/wipow/Website/images/calendar.png

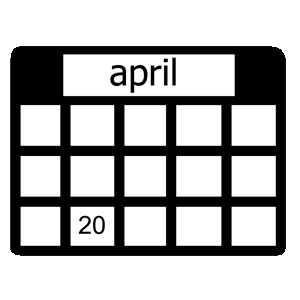
Website/images/calendar.png
