edsammy/wipow/Website/images/headshots/david.jpg

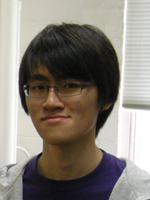
Website/images/headshots/david.jpg
