edsammy/wipow/Website/images/headshots/eddie.jpg

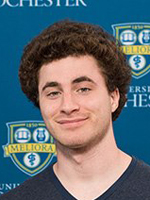
Website/images/headshots/eddie.jpg
