edsammy/wipow/Website/images/headshots/jak.jpg

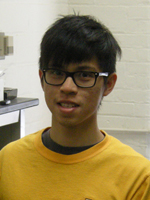
Website/images/headshots/jak.jpg
