edsammy/wipow/Website/images/headshots/james.jpg

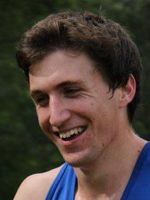
Website/images/headshots/james.jpg
