edsammy/wipow/Website/images/headshots/lucas.jpg

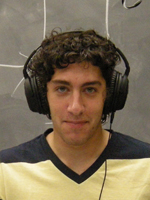
Website/images/headshots/lucas.jpg
