edsammy/wipow/Website/images/headshots/will.jpg

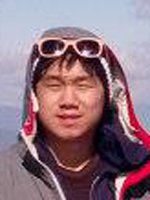
Website/images/headshots/will.jpg
