edsammy/wipow/Website/images/newpower1.png

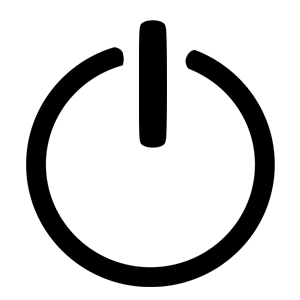
Website/images/newpower1.png
