edsammy/wipow/Website/images/power1.png

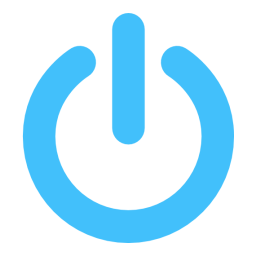
Website/images/power1.png
