edsammy/wipow/Website/images/view.png

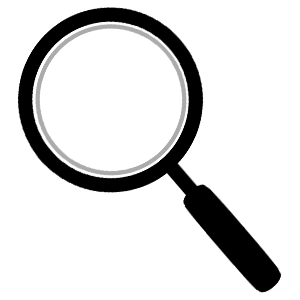
Website/images/view.png
