edsammy/wipow/Website/images/whitepower.png

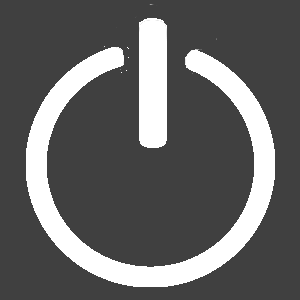
Website/images/whitepower.png
