edsammy/wipow/Website/tmp/10.4.146.82.375810270.Current A Harmonic 4.png

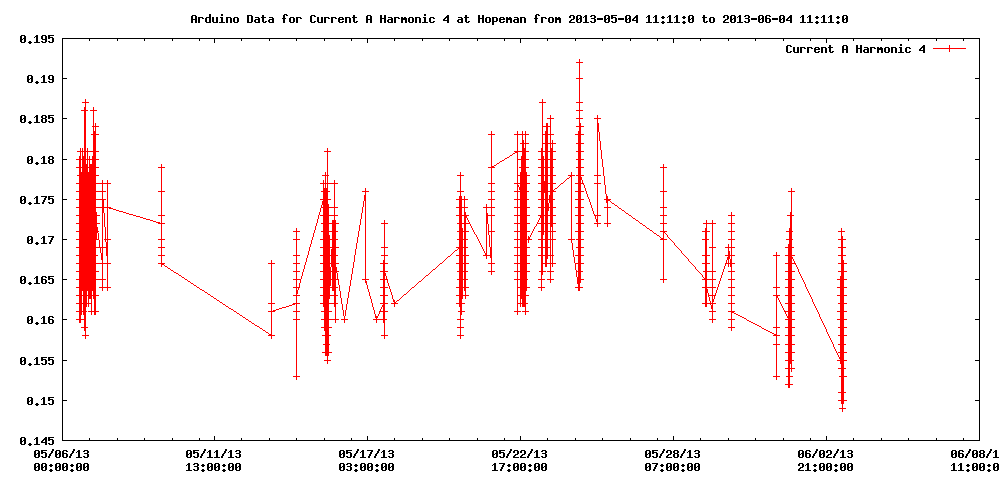
Website/tmp/10.4.146.82.375810270.Current A Harmonic 4.png
