edsammy/wipow/Website/tmp/10.4.146.82.375810270.Current A Total Harmonic Distortion + Noise.png

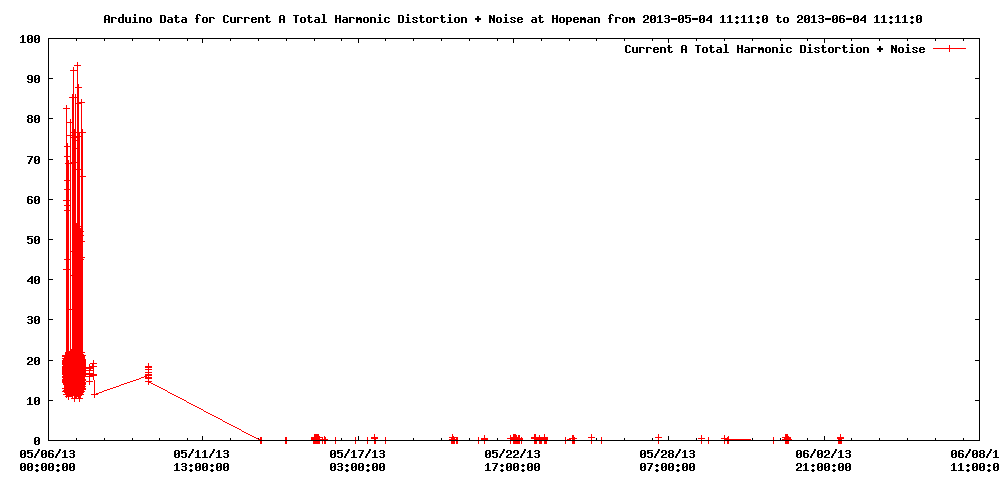
Website/tmp/10.4.146.82.375810270.Current A Total Harmonic Distortion + Noise.png
