edsammy/wipow/Website/tmp/10.4.146.82.375810270.Phasor Angle B to A.png

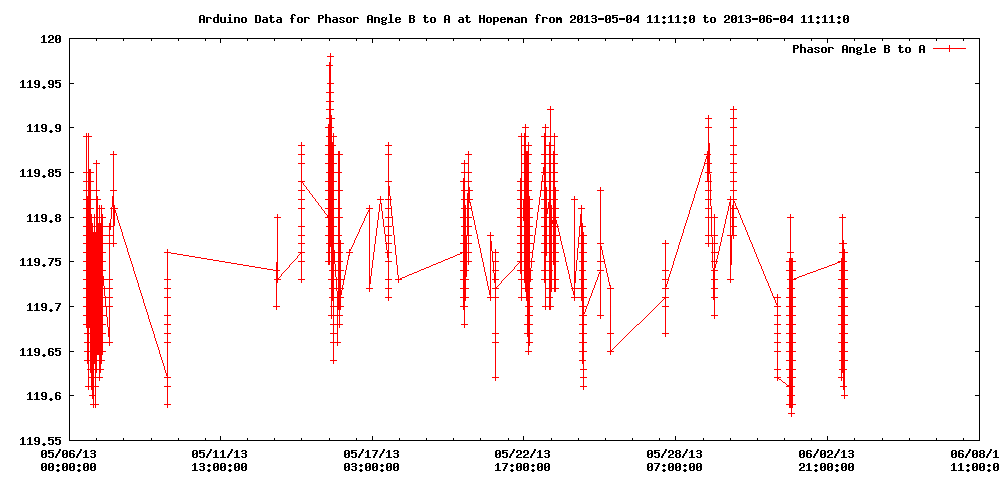
Website/tmp/10.4.146.82.375810270.Phasor Angle B to A.png
