edsammy/wipow/Website/tmp/10.4.146.82.375810270.Power Factor B.png

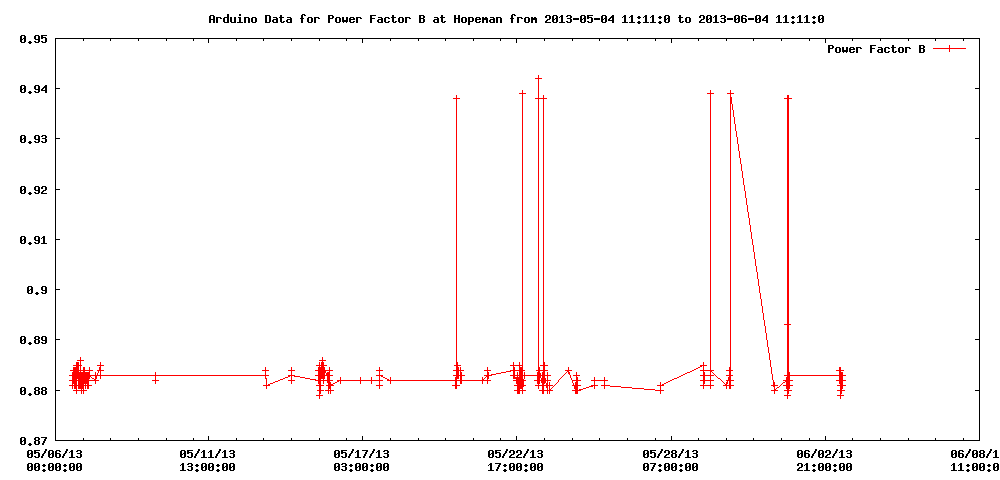
Website/tmp/10.4.146.82.375810270.Power Factor B.png
