edsammy/wipow/Website/tmp/10.4.146.82.375810270.Reactive Power B.png

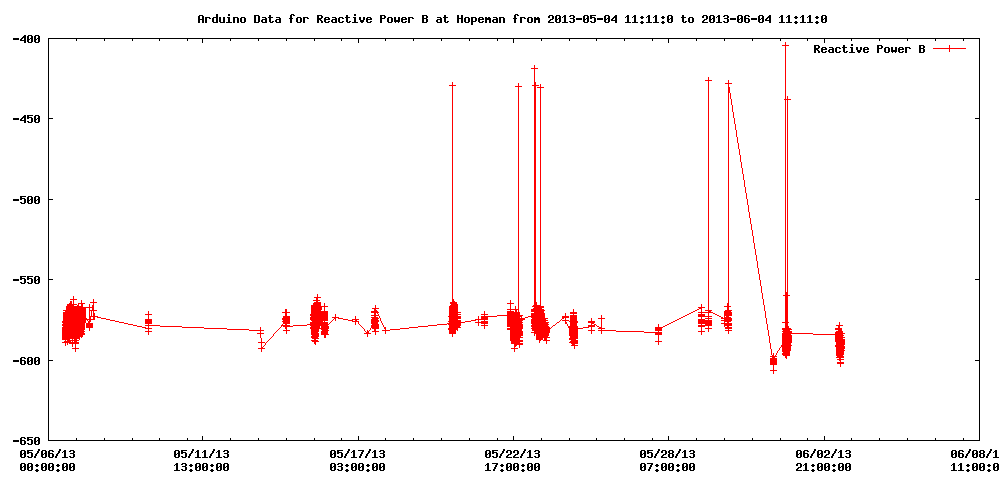
Website/tmp/10.4.146.82.375810270.Reactive Power B.png
