edsammy/wipow/Website/tmp/10.4.146.82.375810270.Voltage B Harmonic 5.png

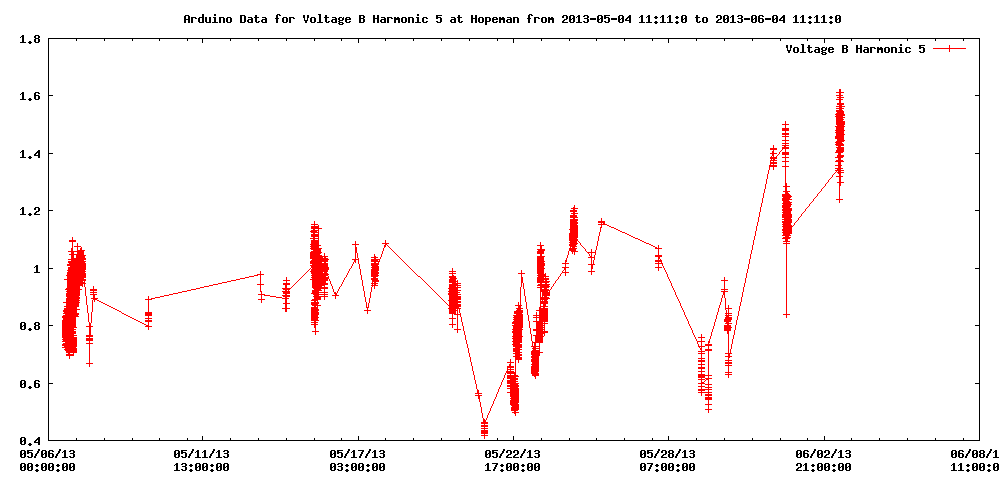
Website/tmp/10.4.146.82.375810270.Voltage B Harmonic 5.png
