edsammy/wipow/Website/tmp/10.4.146.82.375810270.Voltage C Harmonic 3.png

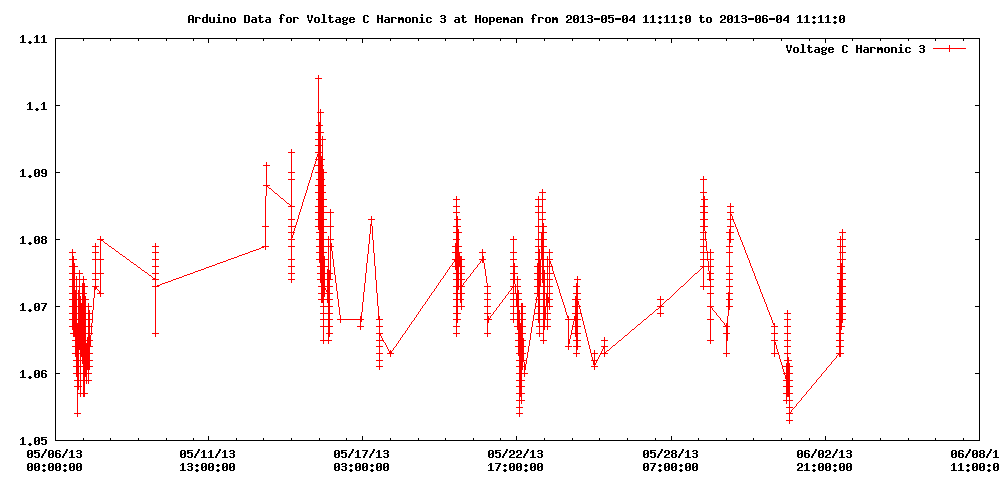
Website/tmp/10.4.146.82.375810270.Voltage C Harmonic 3.png
