edsammy/wipow/Website/tmp/10.4.146.82.375810270.Voltage C.png

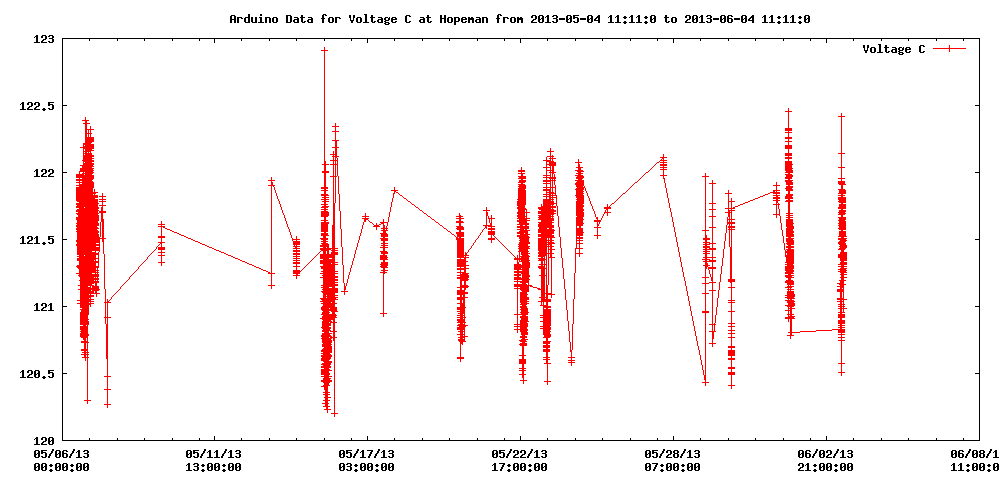
Website/tmp/10.4.146.82.375810270.Voltage C.png
