edsammy/wipow/Website/tmp/10.4.146.82.416322959.Apparent Power A.png

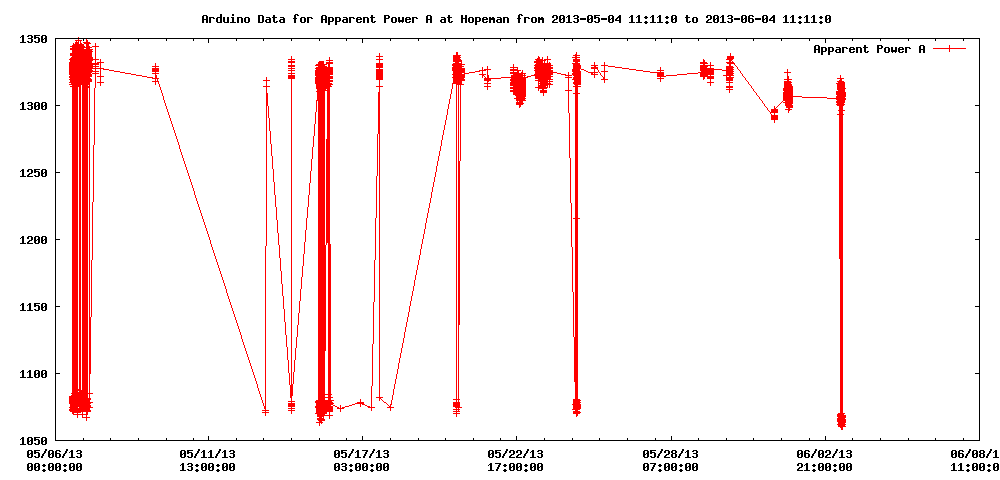
Website/tmp/10.4.146.82.416322959.Apparent Power A.png
