edsammy/wipow/Website/tmp/10.4.146.82.416322959.Current A Harmonic 1.png

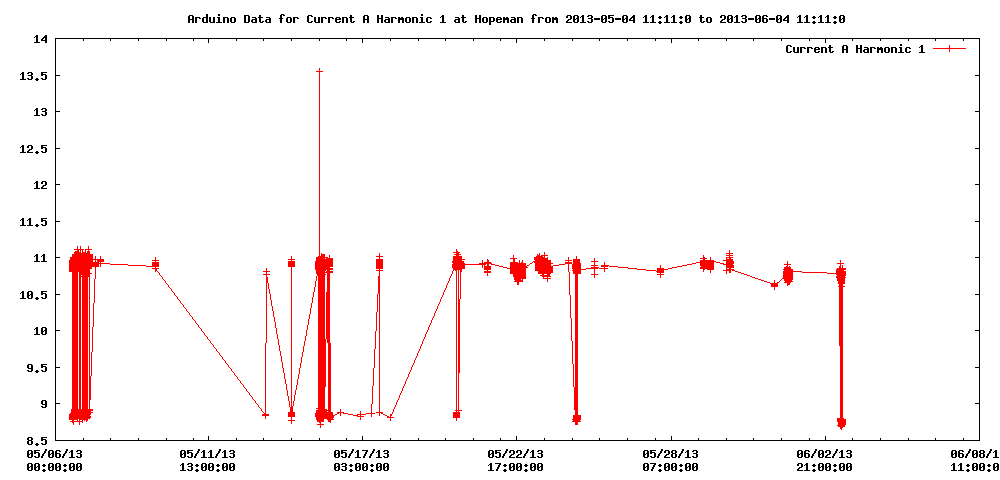
Website/tmp/10.4.146.82.416322959.Current A Harmonic 1.png
