edsammy/wipow/Website/tmp/10.4.146.82.416322959.Real Power C.png

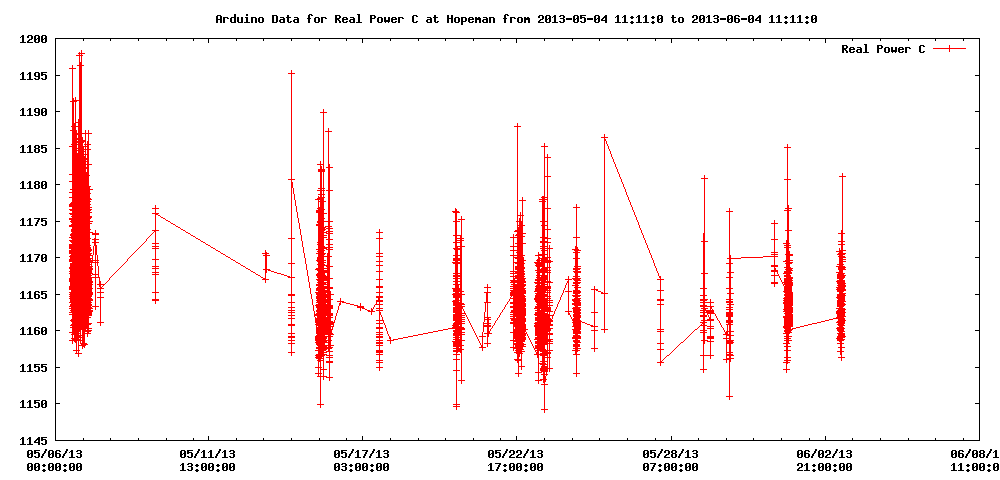
Website/tmp/10.4.146.82.416322959.Real Power C.png
