edsammy/wipow/Website/tmp/10.4.146.82.416322959.Total Power Factor.png

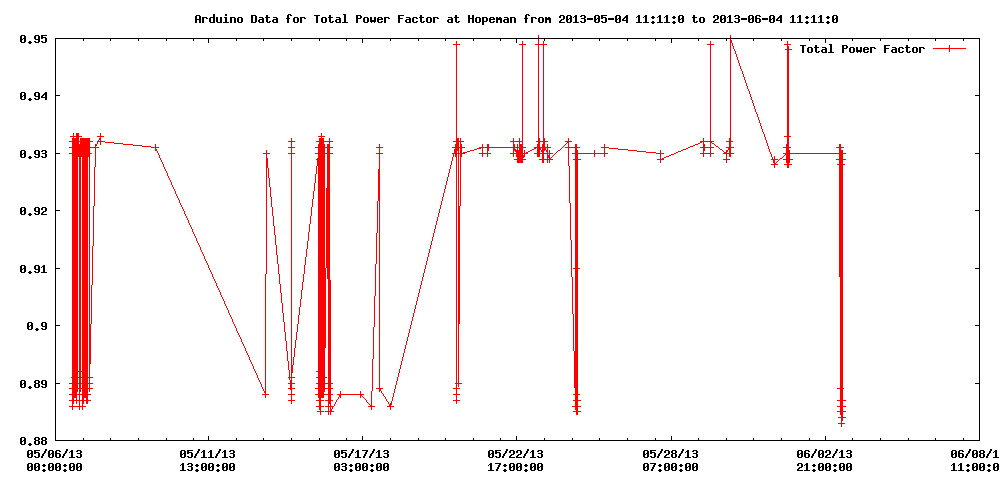
Website/tmp/10.4.146.82.416322959.Total Power Factor.png
