edsammy/wipow/Website/tmp/10.4.146.82.416322959.Voltage A Harmonic 2.png

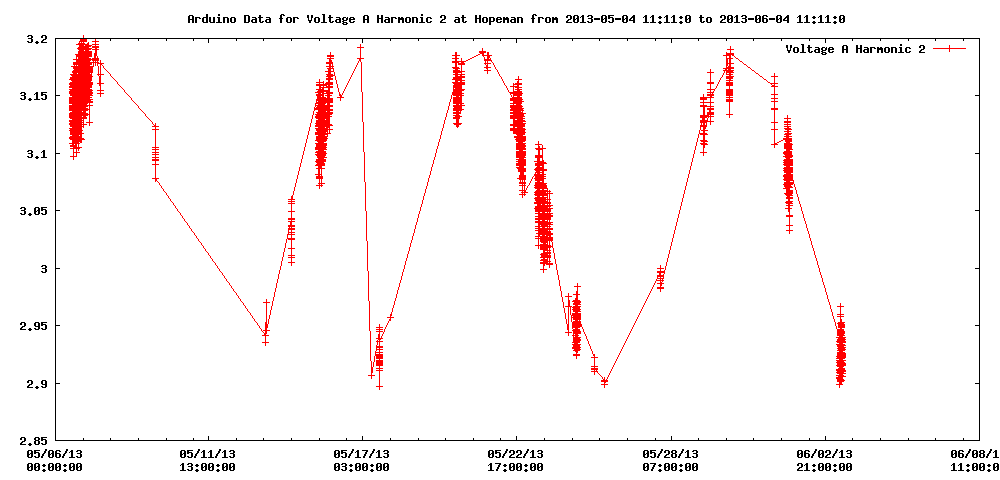
Website/tmp/10.4.146.82.416322959.Voltage A Harmonic 2.png
