edsammy/wipow/Website/tmp/10.4.146.82.416322959.Voltage B Harmonic 3.png

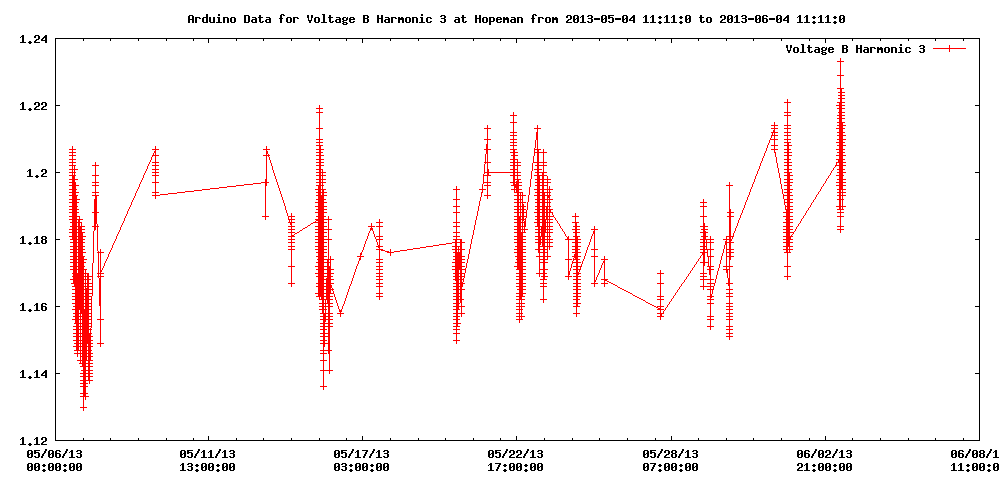
Website/tmp/10.4.146.82.416322959.Voltage B Harmonic 3.png
