edsammy/wipow/Website/tmp/72.43.69.42.1264320460.Real Power B.png

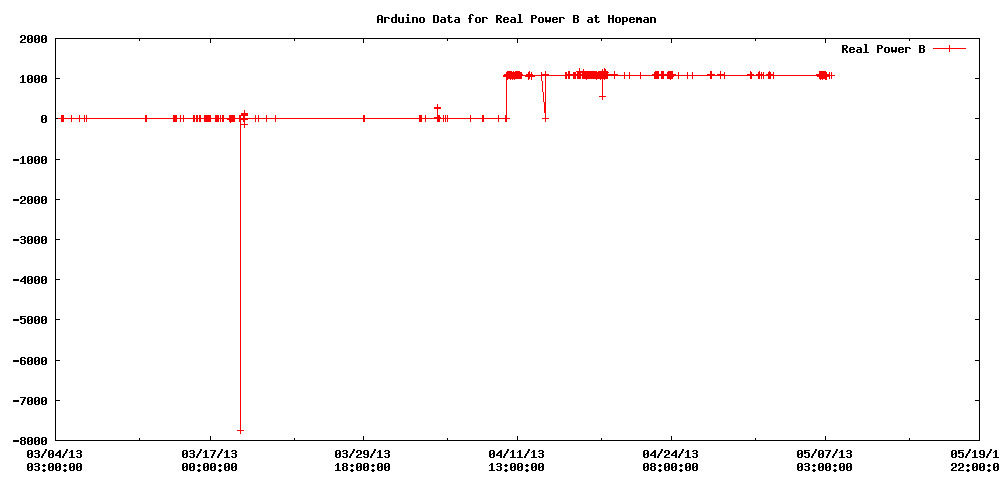
Website/tmp/72.43.69.42.1264320460.Real Power B.png
