edsammy/wipow/Measurement Device/PCB/PCB cost.png

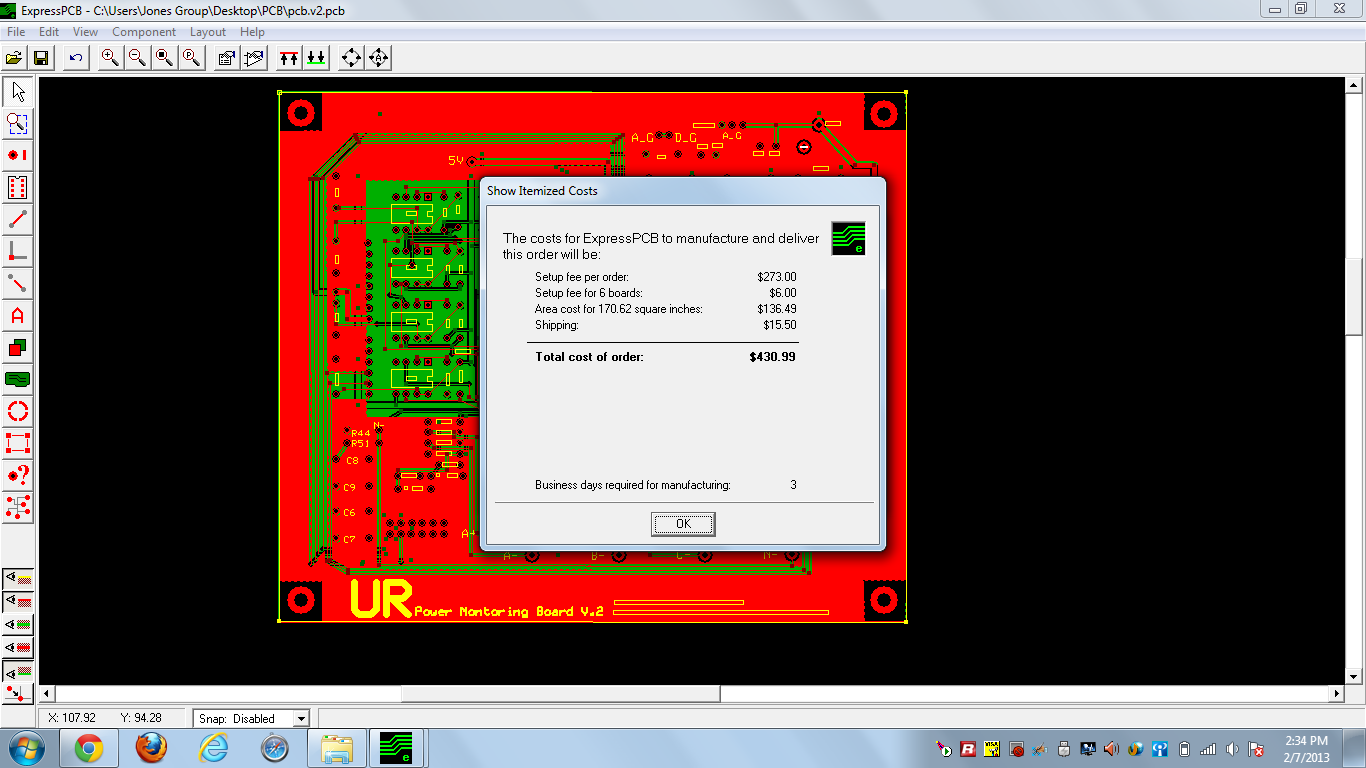
Measurement Device/PCB/PCB cost.png
