edsammy/wipow/Measurement Device/PCB/PCB order number.png

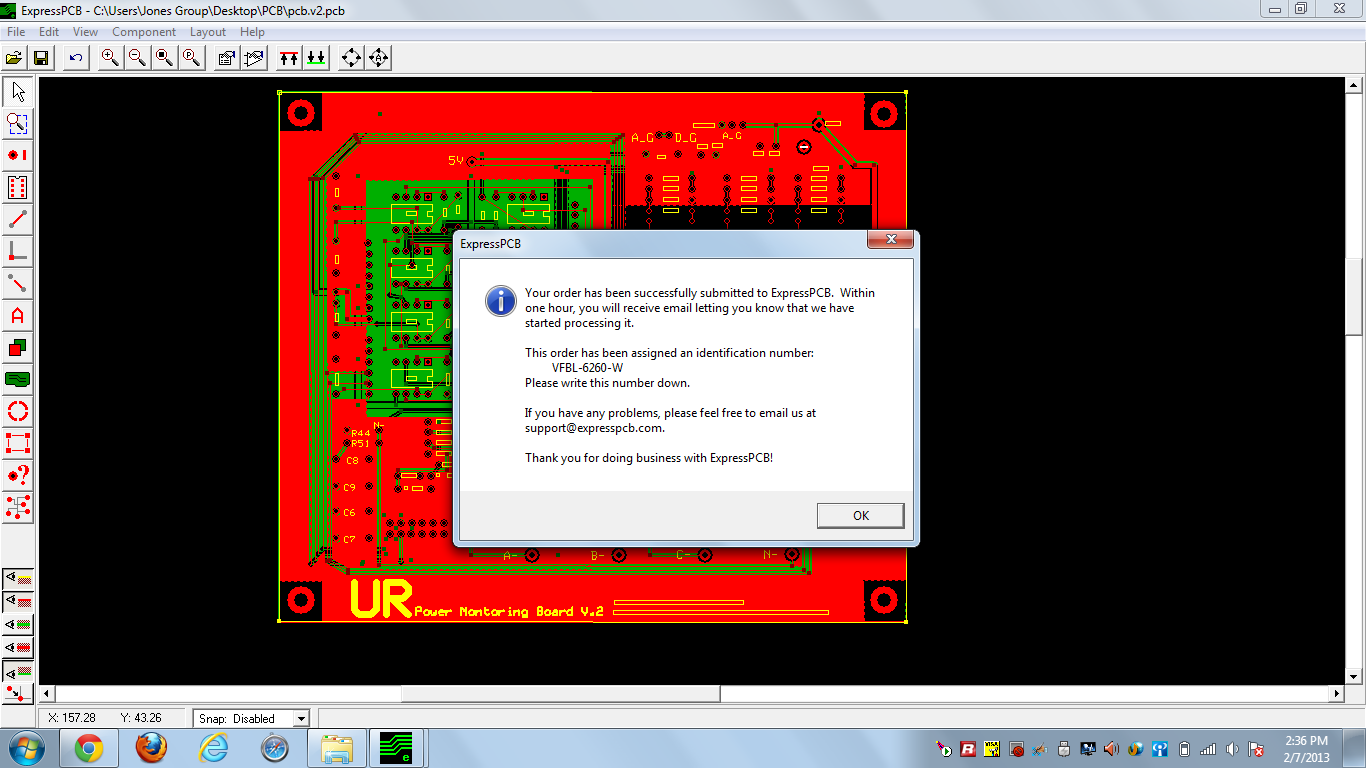
Measurement Device/PCB/PCB order number.png
