edsammy/wipow/Measurement Device/Documentation/Test data/Fluke vs meter (current readings).xlsx

Actual | A | B | C
0.479 | 0.53 | 0.49 | 0.52
0.402 | 0.46 | 0.42 | 0.44
0.295 | 0.36 | 0.32 | 0.34
0.116 | 0.23 | 0.16 | 0.19
0 | 0.18 | 0.11 | 0.14
0 | 0.13 | 0.04 | 0.04
0.056 | 0.14 | 0.07 | 0.07
0.102 | 0.17 | 0.11 | 0.11
0.149 | 0.21 | 0.16 | 0.16
0.199 | 0.25 | 0.21 | 0.21
0.248 | 0.29 | 0.26 | 0.26
0.302 | 0.34 | 0.31 | 0.32
0.349 | 0.39 | 0.36 | 0.36
0.396 | 0.43 | 0.4 | 0.4
0.45 | 0.48 | 0.46 | 0.46
0.5 | 0.53 | 0.5 | 0.51
0.557 | 0.58 | 0.56 | 0.57
0.598 | 0.62 | 0.6 | 0.61
0.65 | 0.67 | 0.65 | 0.66
0.703 | 0.72 | 0.7 | 0.71
0.743 | 0.76 | 0.74 | 0.75
0.802 | 0.82 | 0.8 | 0.81
0.85 | 0.86 | 0.84 | 0.85
0.904 | 0.92 | 0.9 | 0.91
0.948 | 0.97 | 0.95 | 0.94
1.006 | 1.02 | 0.99 | 1
1.094 | 1.09 | 1.08 | 1.09
1.205 | 1.21 | 1.2 | 1.19
1.301 | 1.3 | 1.29 | 1.29
1.401 | 1.4 | 1.38 | 1.38
1.498 | 1.49 | 1.48 | 1.49
1.597 | 1.58 | 1.57 | 1.58
1.701 | 1.68 | 1.67 | 1.68
1.803 | 1.79 | 1.76 | 1.77
1.909 | 1.89 | 1.88 | 1.89
2.008 | 1.99 | 1.97 | 1.97
2.213 | 2.19 | 2.16 | 2.17
2.409 | 2.37 | 2.37 | 2.38
2.607 | 2.57 | 2.56 | 2.57
2.796 | 2.76 | 2.75 | 2.74
3.001 | 2.95 | 2.94 | 2.97
