edsammy/wipow/Measurement Device/Documentation/Test data/Measured Frequency vs harmonic reading.xlsx

Sheet: Sheet1
Frequency | Phase A 1st harmonic |  | Phase A
59.95 | 120.45 | 0.05 | 120.69
59.96 | 120.51 | 0.04 | 120.66
59.97 | 120.60 | 0.03 | 120.72
59.97 | 120.70 | 0.03 | 120.73
59.98 | 120.73 | 0.02 | 120.67
59.98 | 120.76 | 0.02 | 120.84
59.98 | 120.65 | 0.02 | 120.79
59.98 | 120.21 | 0.02 | 120.79
59.98 | 119.86 | 0.02 | 120.53
59.98 | 119.34 | 0.02 | 119.85
59.23 | 116.36 | 0.77 | 119.8
59.42 | 104.68 | 0.58 | 119.36
59.56 | 104.82 | 0.44 | 120.33
59.67 | 109.36 | 0.33 | 120.54
59.35 | 110.15 | 0.65 | 120.32
59.51 | 108.36 | 0.49 | 120.24
59.63 | 112.41 | 0.37 | 120.93
59.78 | 115.17 | 0.22 | 120.26
59.83 | 117.10 | 0.17 | 120.33
59.87 | 119.09 | 0.13 | 120.36
58.99 | 112.23 | 1.01 | 120.49
59.23 | 92.15 | 0.77 | 121.08
59.42 | 96.72 | 0.58 | 120.02
59.56 | 104.42 | 0.44 | 120.62
59.67 | 109.78 | 0.33 | 120.84
59.75 | 113.46 | 0.25 | 120.43
59.81 | 116.01 | 0.19 | 120.21
59.85 | 117.82 | 0.15 | 120.29
61.67 | 105.26 | 1.67 | 120.33
61.24 | 64.59 | 1.24 | 120.42
60.93 | 78.43 | 0.93 | 120.95
60.69 | 90.85 | 0.69 | 120.1
60.51 | 99.24 | 0.51 | 120.97
60.38 | 106.42 | 0.38 | 120.06
60.28 | 112.02 | 0.28 | 120.32
60.21 | 117.35 | 0.21 | 120.62
60.15 | 118.70 | 0.15 | 120.74
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
