edsammy/wipow/Measurement Device/Documentation/Power flow for PCB V2.png

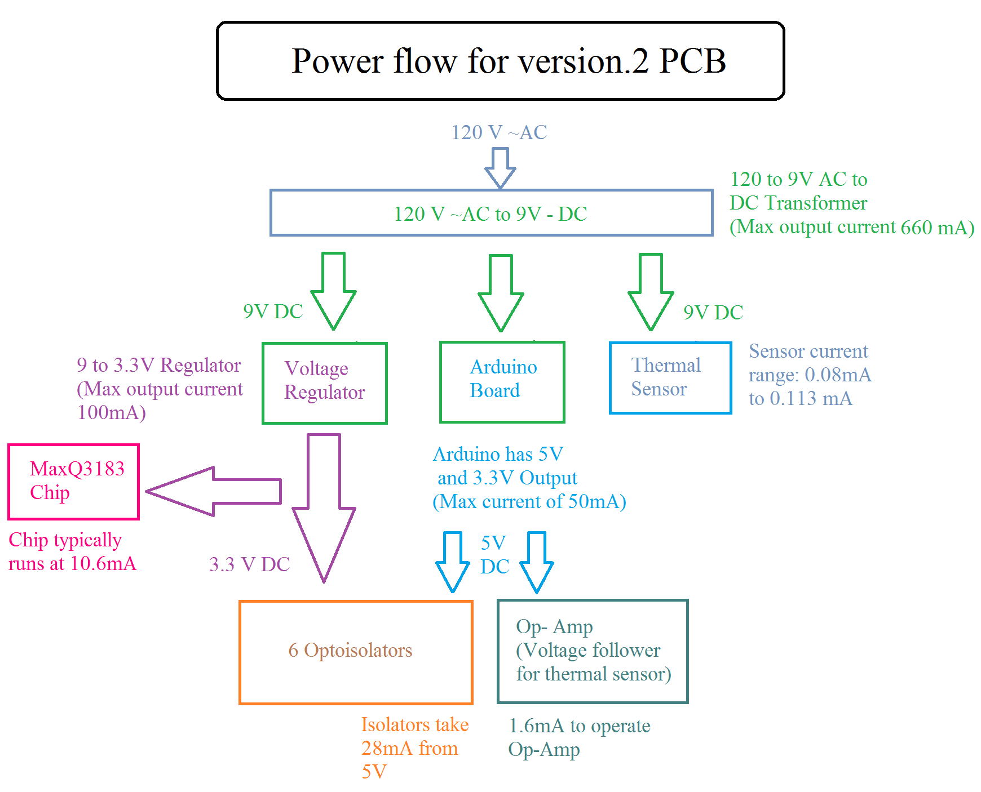
Measurement Device/Documentation/Power flow for PCB V2.png
