edsammy/wipow/Measurement Device/Documentation/SPI read.png

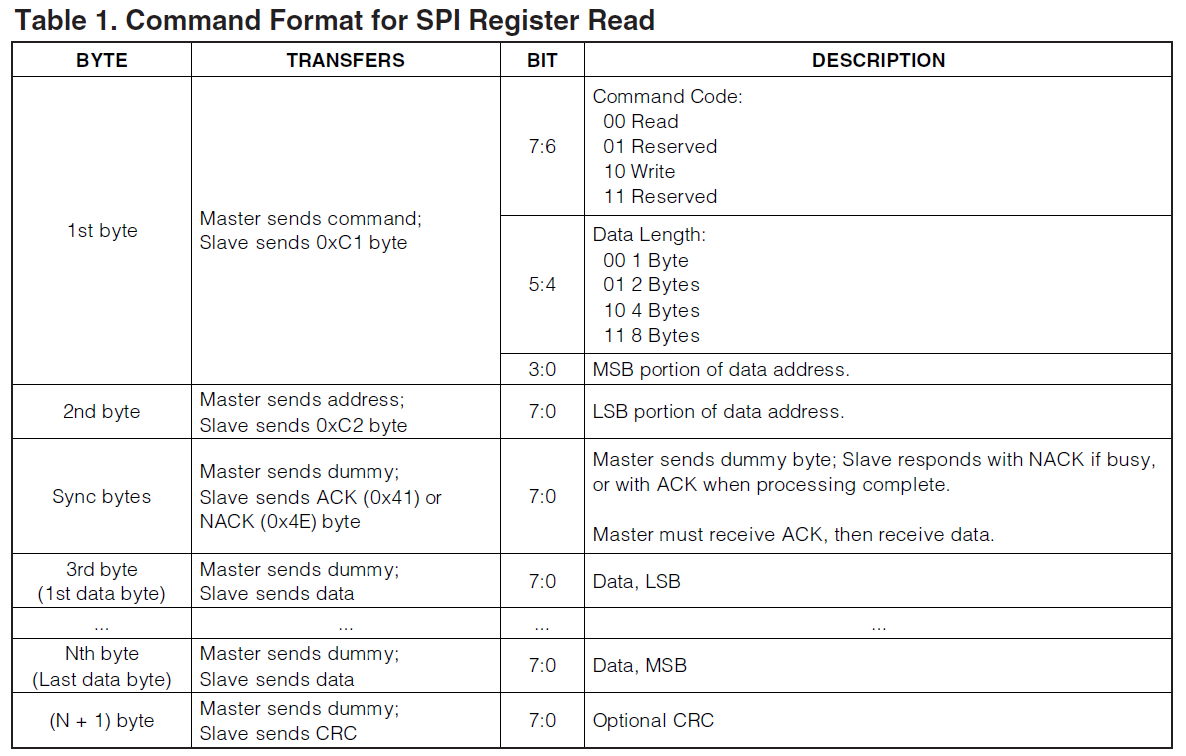
Measurement Device/Documentation/SPI read.png
