edsammy/wipow/Measurement Device/MAXQ3182 Reference Design from Maxim/4663Fig56.pdf

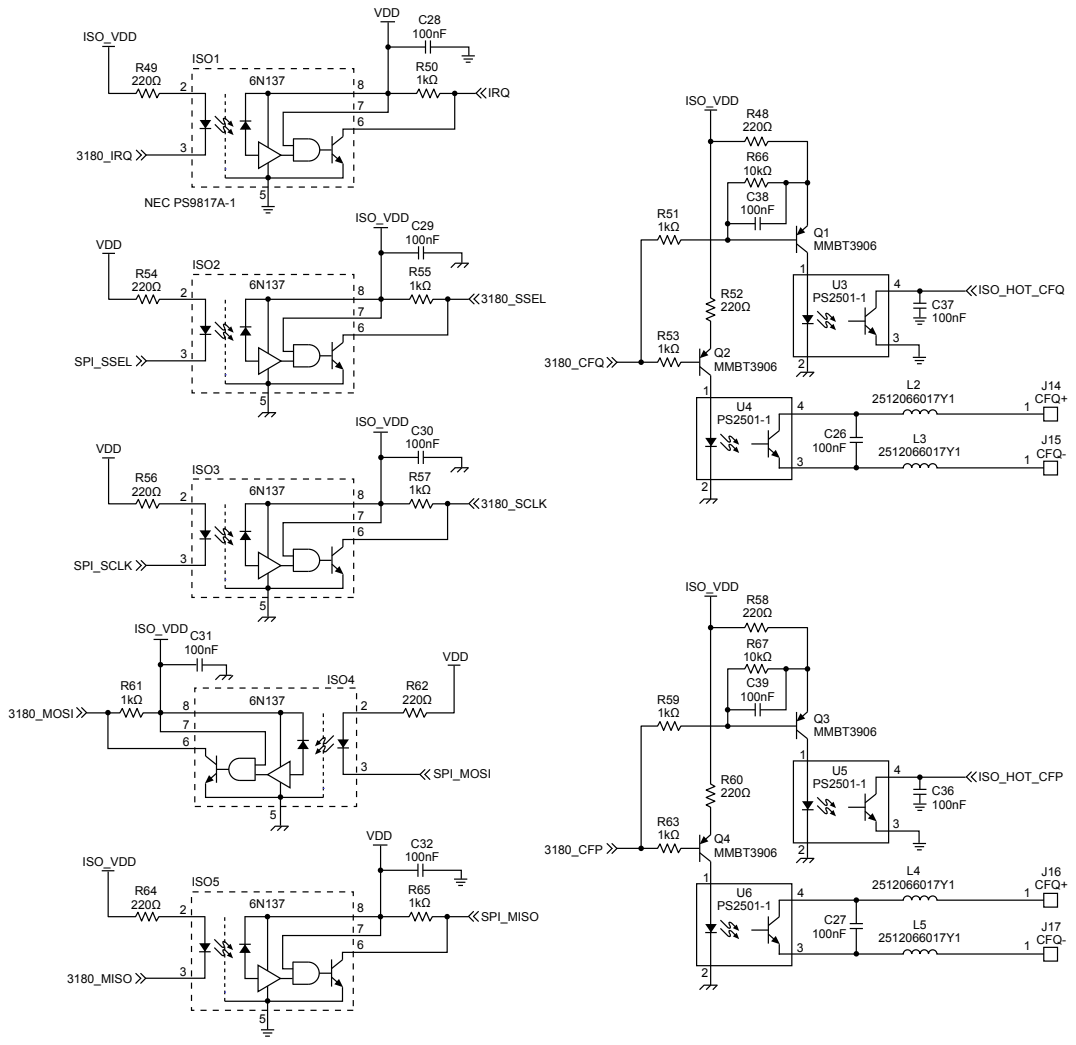
[picture p198: page 1]
