edsammy/wipow/(list of files, drawings)

Other design files:
Measurement Device/PCB/pcb.V1.pcb
Measurement Device/PCB/pcb.v2.pcb
