edsammy/wipow/Measurement Device/Arduino code experimental/chip_test_mega/find_text.ino

// Function to find a string inside another string 
// from http://playground.arduino.cc/Main/FindText

int find_text(String needle, String haystack) {
  int foundpos = -1;
  for (int i = 0; (i < haystack.length() - needle.length()); i++) {
    if (haystack.substring(i,needle.length()+i) == needle) {
      foundpos = i;
    }
  }
  return foundpos;
}
