edsammy/wipow/(commit log)

2013-06-10 added experimental arduino code
2013-06-19 new experimental arduino code & indextest w/ modal
2013-06-28 updates to website and arduino code
2013-07-10 arduino software update
2013-07-18 added hardware watchdog timer
2013-08-21 fixed experimental cogen code
    [user_sel_read.ino]
2013-08-21 ability to plot neutral current added to site
